dioderobot/arduino/README.md

# PCB boards

This repository contains schematics and boards built using the `pcb` command line utility by Diode, using the Zener language and open source compiler
