dioderobot/arduino/boards/Nano/docs/Nano.md

---
title: "Arduino Nano - Compact Development Board"
confidential: false
company:
  name: "Diode Inc"
  url: "https://diode.io"
client:
  name: "Arduino"
releases:
  - version: "1.0"
    date: "2025/10/21"
    description: "Initial Arduino Nano rebuild design"
---

# PCB Design Specification: Arduino Nano

# Description

The Arduino Nano is a compact microcontroller board based on the ATmega328P. It offers similar functionality to the Arduino Uno but in a smaller, breadboard-friendly form factor. The board is designed for embedded applications where space is at a premium while maintaining full Arduino ecosystem compatibility.

# Features

- ATmega328P microcontroller (16 MHz)
- 32 KB Flash memory (2 KB used by bootloader)
- 2 KB SRAM, 1 KB EEPROM
- 14 digital I/O pins (6 PWM outputs)
- 8 analog input pins
- USB connectivity via Mini-B or USB-C connector
- Breadboard-friendly DIP-30 pin layout
- Power via USB or external 7-12V supply
- Compact size: 18mm x 45mm

# Applications

- Embedded system prototyping
- IoT sensor nodes
- Robotics control systems
- Educational electronics projects
- Wearable electronics
- Home automation controllers

# Block Diagram

```mermaid
graph TB
    subgraph "Arduino Nano Board"
        subgraph "Power"
            USB["USB Power"]
            VIN["VIN (7-12V)"]
            REG["Voltage Regulator"]
            VCC["5V/3.3V Rails"]
            GND["Ground"]
        end
        
        subgraph "Communication"
            UART["USB-Serial (CH340/FTDI)"]
            I2C["I2C (A4/A5)"]
            SPI["SPI (D10-D13)"]
        end
        
        subgraph "Signal I/O"
            DIO["Digital I/O (D2-D13)"]
            AIN["Analog Input (A0-A7)"]
            PWM["PWM Output (D3,5,6,9,10,11)"]
        end
        
        subgraph "Processing"
            MCU["ATmega328P<br/>16 MHz"]
            XTAL["16MHz Crystal"]
        end
        
        USB --> UART
        VIN --> REG
        REG --> VCC
        USB --> VCC
        VCC --> MCU
        UART --> MCU
        XTAL --> MCU
        MCU --> DIO
        MCU --> PWM
        AIN --> MCU
        MCU --> I2C
        MCU --> SPI
    end
```
