dioderobot/arduino/components/74LVC1G3157DW-7/74LVC1G3157DW-7.md

## Description

The 74LVC1G3157 is a single-pole, double-throw analog switch. The device is designed for operation with a power supply range of 1.65 V to 5.5 V . The bidirectional switch can handle signal amplitudes between Vcc and Ground. The OFF state impedance of the switch is typically $50 \mathrm{M} \Omega$ while the ON state is typically $6 \Omega$.

## Pin Assignments



SOT363


Packages not to scale

# Features 

- Wide Supply Voltage Range from 1.65 to 5.5 V
- Control Pin Includes Hysteresis Allowing for Slower Input Rise and Fall Times
- CMOS Low Power Consumption
- Very Low ON-State Resistance
- $7.5 \Omega$ (typical) at $\mathrm{V}_{\mathrm{CC}}=2.7 \mathrm{~V}$
- $6.5 \Omega$ (typical) at $\mathrm{V}_{\mathrm{CC}}=3.3 \mathrm{~V}$
- $6 \Omega$ (typical) at $\mathrm{V}_{\mathrm{CC}}=4.5 \mathrm{~V}$
- Break Before Make Switching
- Control Input accepts up to 5.5V Regardless of Vcc.
- Direct Interface with TTL Levels when $\mathrm{V}_{\mathrm{CC}}=3.3 \mathrm{~V}$
- ESD Protection Tested per JESD 22
- Exceeds 2,000-V Human Body Model (A114)
- Exceeds 1,000-V Charged Device Model (C101)
- Latch-Up Exceeds 100mA per JESD 78, Class I
- Range of Package Options
- Totally Lead-Free \& Fully RoHS Compliant (Notes 1 \& 2)
- Halogen and Antimony Free. "Green" Device (Note 3)
- For automotive applications requiring specific change control (i.e. parts qualified to AEC-Q100/101/200, PPAP capable, and manufactured in IATF 16949 certified facilities), please contact us or your local Diodes representative.
https://www.diodes.com/quality/product-definitions/

## Applications

- Multiplexing of Analog Signals
- Multiplexing of Digital Signals
- Wide array of products such as:
- Tablets, E-readers, Wearables
- Cell Phones, Personal Navigation / GPS
- MP3 Players, Cameras, Video Recorders
- Computer Peripherals, Hard Drives, CD/DVD ROMs
- TV, DVD, DVR, Set Top Boxes
- PCs, Networking, Notebooks, Netbooks, PDAs

Notes: 1. No purposely added lead. Fully EU Directive 2002/95/EC (RoHS), 2011/65/EU (RoHS 2) \& 2015/863/EU (RoHS 3) compliant.
2. See https://www.diodes.com/quality/lead-free/ for more information about Diodes Incorporated's definitions of Halogen- and Antimony-free, "Green" and Lead-free.
3. Halogen- and Antimony-free "Green" products are defined as those which contain <900ppm bromine, <900ppm chlorine ( $<1500 \mathrm{ppm}$ total $\mathrm{Br}+\mathrm{Cl}$ ) and $<1000 \mathrm{ppm}$ antimony compounds.# Ordering Information (Note 4) 



| Device | Package <br> Code | Package <br> (Note 5) | Package <br> Size | $7^{\text {th }}$ Tape and Reel (Note 6) |  |
| :--: | :--: | :--: | :--: | :--: | :--: |
|  |  |  |  | Quantity | Part Number Suffix |
| 74LVC1G3157DW-7 | DW | SOT363 | $2.0 \mathrm{~mm} \times 2.0 \mathrm{~mm} \times 1.1 \mathrm{~mm}$ <br> 0.65 mm lead pitch | 3,000/Tape \& Reel | -7 |
| 74LVC1G3157FZ4-7 | FZ4 | X2-DFN1410-6 | $\begin{gathered} 1.4 \mathrm{~mm} \times 1.0 \mathrm{~mm} \times 0.4 \mathrm{~mm} \\ 0.5 \mathrm{~mm} \text { pad pitch } \end{gathered}$ | 5,000/Tape \& Reel | -7 |

Notes: 4. For packaging details, go to our website at https://www.diodes.com/design/support/packaging/diodes-packaging/.
5. Pad layout as shown in Diodes Incorporated's package outline PDFs, which can be found on our website at https://www.diodes.com/design/support/packaging/diodes-packaging/.
6. The taping orientation is located on our website at https://www.diodes.com/assets/Packaging-Support-Docs/ap02007.pdf.

## Pin Descriptions

| Pin Name | Description |
| :--: | :-- |
| B1 | Selectable Data I/0 |
| GND | Ground |
| B0 | Selectable Data I/0 |
| A | Common Data I/0 |
| $\mathrm{V}_{\mathrm{CC}}$ | Supply Voltage |
| Select | Selection Pin |

## Function Table

| Select | Status |
| :--: | :--: |
| H | B1 connected to A; <br> B0 high impedance |
| L | B0 connected to A; <br> B1 high impedance |

## Logic Diagram



## Simplified Schematic

# Absolute Maximum Ratings (Note 7) 

| Symbol | Description | Rating | Unit |
| :--: | :--: | :--: | :--: |
| ESD HBM | Human Body Model ESD Protection | 2 | kV |
| ESD CDM | Charged Device Model ESD Protection | 1 | kV |
| $\mathrm{V}_{\mathrm{CC}}$ | Supply Voltage Range | -0.5 to 6.5 | V |
| $\mathrm{V}_{\mathrm{IN}}$ | Input Voltage Range Applicable to Select Pin | -0.5 to 6.5 | V |
| $\mathrm{V}_{\text {SW }}$ | Voltage Range Applicable to B0, B1, and A Pins | -0.5 to $\mathrm{V}_{\mathrm{CC}}+0.5$ | V |
| $\mathrm{I}_{\text {IK }}$ | Input Clamp Current V,<0 Applicable to Select Pin | -50 | mA |
| $\mathrm{I}_{\text {IO }}$ | Continuous Current Applicable to B0,B1, and A Pins | $\pm 50$ | mA |
| $\mathrm{I}_{\mathrm{CC},} \mathrm{I}_{\text {GND }}$ | Continuous current through $\mathrm{V}_{\mathrm{CC}}$ or GND | $\pm 100$ | mA |
| $\mathrm{T}_{\mathrm{J}}$ | Operating Junction Temperature | -40 to +150 | ${ }^{\circ} \mathrm{C}$ |
| $\mathrm{T}_{\text {STG }}$ | Storage Temperature | -65 to +150 | ${ }^{\circ} \mathrm{C}$ |

Note: $\quad 7$. Stresses beyond the absolute maximum may result in immediate failure or reduced reliability. These are stress values and device operation should be within recommend values.

## Recommended Operating Conditions

| Symbol | Parameter |  | Min | Max | Unit |
| :--: | :--: | :--: | :--: | :--: | :--: |
| $\mathrm{V}_{\mathrm{CC}}$ | Operating Voltage | Operating | 1.65 | 5.5 | V |
| $\mathrm{V}_{\mathrm{IN}}$ | Select Input Voltage |  | 0 | 5.5 | V |
| $\mathrm{V}_{\text {SW }}$ | Switch Voltage (applicable to pins B0,B1,A) |  | $-0.2$ | $\mathrm{V}_{\mathrm{CC}}$ | V |
| $\Delta \mathrm{I} / \Delta \mathrm{V}$ | Input Transition Rise or Fall <br> Rate - Select Pin | $\mathrm{V}_{\mathrm{CC}}=1.65$ to 2.7 V | - | 20 | ns/V |
|  |  | $\mathrm{V}_{\mathrm{CC}}=2.7 \mathrm{~V}$ to 5.5 V | - | 10 |  |
| $T_{A}$ | Operating Free-Air Temperature | - | $-40$ | $+125$ | ${ }^{\circ} \mathrm{C}$ |# Electrical Characteristics (All typical values are at, $\mathrm{T}_{\mathrm{J}}=+25^{\circ} \mathrm{C}$ ) 

| Symbol | Parameter | Test Condition | $\mathrm{V}_{\mathrm{CC}}(\mathrm{V})$ | $\mathrm{T}_{\mathrm{A}}=-40$ to $+85^{\circ} \mathrm{C}$ |  |  | $\mathrm{T}_{\mathrm{A}}=-40$ to $+125^{\circ} \mathrm{C}$ |  | Unit |
| :--: | :--: | :--: | :--: | :--: | :--: | :--: | :--: | :--: | :--: |
|  |  |  |  | Min | Typical <br> (Note 8) | Max | Min | Max |  |
| $V_{I H}$ | High Level Input Voltage Select Pin | - | 1.65 to 1.95 | $0.65 \mathrm{~V}_{\mathrm{CC}}$ | - | - | $0.65 \mathrm{~V}_{\mathrm{CC}}$ | - | V |
|  |  |  | 2.3 to 2.7 | 1.7 | - | - | 1.7 | - |  |
|  |  |  | 3 to 3.6 | 2.0 | - | - | 2.0 | - |  |
|  |  |  | 4.5 to 5.5 | $0.7 \mathrm{~V}_{\mathrm{CC}}$ | - | - | $0.7 \mathrm{~V}_{\mathrm{CC}}$ | - |  |
| $V_{f L}$ | Low Level Input Voltage Select Pin | - | 1.65 to 1.95 | - | - | $0.35 \mathrm{~V}_{\mathrm{CC}}$ | - | $0.35 \mathrm{~V}_{\mathrm{CC}}$ | V |
|  |  |  | 2.3 to 2.7 | - | - | 0.7 | - | 0.7 |  |
|  |  |  | 3 to 3.6 | - | - | 0.8 | - | 0.8 |  |
|  |  |  | 4.5 to 5.5 | - | - | $0.3 \mathrm{~V}_{\mathrm{CC}}$ | - | $0.3 \mathrm{~V}_{\mathrm{CC}}$ |  |
| $I_{I N}$ | Input Leakage Current Select Pin | $0 \leq$ Select $\leq 5.5 \mathrm{~V}$ | 0 to 5.5 | - | $\pm 0.05$ | $\pm 1$ | - | $\pm 10$ | $\mu \mathrm{A}$ |
| $I_{S(\text { OFF })}$ | OFF State Leakage Current | $0 \mathrm{~V} \leq \mathrm{A}, \mathrm{B}_{\mathrm{n}} \leq \mathrm{V}_{\mathrm{CC}}$ <br> Figure 1 | 1.65 to 5.5 | - | $\pm 0.05$ | $\pm 1$ | - | $\pm 10$ | $\mu \mathrm{A}$ |
| $I_{S(C N)}$ | ON State Leakage Current | $0 \mathrm{~V} \leq \mathrm{A}, \mathrm{B}_{\mathrm{n}} \leq \mathrm{V}_{\mathrm{CC}}$ <br> Figure 2 | 1.65 to 5.5 | - | $\pm 0.05$ | $\pm 1$ | - | $\pm 10$ | $\mu \mathrm{A}$ |
| $I_{S(C N)}$ | ON State Leakage Current | $-0.1 \mathrm{~V} \leq \mathrm{A}, \mathrm{B}_{\mathrm{n}} \leq \mathrm{V}_{\mathrm{CC}}$ <br> Figure 2 | 1.65 to 5.5 | - | $\pm 0.05$ | $\pm 2$ | - | $\pm 20$ | $\mu \mathrm{A}$ |
| $I_{C C}$ | Quiescent Supply Current | Select $=\mathrm{V}_{\mathrm{CC}}$ or GND <br> A, Bn $=\mathrm{V}_{\mathrm{CC}}$ or GND <br> $\mathrm{I}_{\text {OUT }}=0$ | 5.5 | - | 1.0 | 10 | - | 40 | $\mu \mathrm{A}$ |
| $\Delta I_{C C}$ | Additional Supply Current | Select $=\mathrm{V}_{\mathrm{CC}}-0.6 \mathrm{~V}$ <br> A, Bn $=\mathrm{V}_{\mathrm{CC}}$ or GND <br> $\mathrm{I}_{\text {OUT }}=0$ | 5.5 | - | 30 | 500 | - | 5,000 | $\mu \mathrm{A}$ |
| $C_{I}$ | Input <br> Capacitance <br> Select Pin | - | 3.3 | - | 2.5 | - | - | - | pF |
| $\mathrm{C}_{\mathrm{S}(\text { OFF })}$ | OFF State Capacitance | Select $=\mathrm{V}_{\mathrm{CC}}$ or GND <br> A, Bn $=\mathrm{V}_{\mathrm{CC}}$ or GND <br> $\mathrm{I}_{\text {OUT }}=0$ | 3.3 | - | 6.0 | - | - | - | pF |
| $\mathrm{C}_{\mathrm{S}(\text { ON })}$ | ON State Capacitance | Select $=\mathrm{V}_{\mathrm{CC}}$ or GND <br> A, Bn $=\mathrm{V}_{\mathrm{CC}}$ or GND <br> $\mathrm{I}_{\text {OUT }}=0$ | 3.3 | - | 18 | - | - | - | pF |

Note: 8. Typical performance information is included in figures 11 to 34 on pages 11 to 14.# Electrical Characteristics (All typical values are at $\mathrm{T}_{J}=+25^{\circ} \mathrm{C}$ ) 

| Symbol | Parameter | Test Condition (Note 9) | $\mathrm{V}_{\mathrm{CC}}(\mathrm{V})$ | $T_{A}=-40$ to $+85^{\circ} \mathrm{C}$ |  |  | $T_{A}=-40$ to $+125^{\circ} \mathrm{C}$ |  | Unit |
| :--: | :--: | :--: | :--: | :--: | :--: | :--: | :--: | :--: | :--: |
|  |  |  |  | Min | Typ | Max | Min | Max |  |
| $R_{\text {ON }}$ | ON <br> Resistance | $\mathrm{V}_{\mathrm{I}}=0 \mathrm{~V}, \mathrm{I}_{\mathrm{O}}=4 \mathrm{~mA}$ | 1.65 | - | 12.5 | 18 | - | 27 | $\Omega$ |
|  |  | $\mathrm{V}_{\mathrm{I}}=1.65 \mathrm{~V}, \mathrm{I}_{\mathrm{O}}=-4 \mathrm{~mA}$ |  | - | 14 | 18 | - | 35 |  |
|  |  | $\mathrm{V}_{\mathrm{I}}=0 \mathrm{~V}, \mathrm{I}_{\mathrm{O}}=8 \mathrm{~mA}$ | 2.3 | - | 9.0 | 16 | - | 24 |  |
|  |  | $\mathrm{V}_{\mathrm{I}}=2.3 \mathrm{~V}, \mathrm{I}_{\mathrm{O}}=-8 \mathrm{~mA}$ |  | - | 9.0 | 16 | - | 30 |  |
|  |  | $\mathrm{V}_{\mathrm{I}}=0 \mathrm{~V}, \mathrm{I}_{\mathrm{O}}=12 \mathrm{~mA}$ | 2.7 | - | 8.0 | 14 | - | 21 |  |
|  |  | $\mathrm{V}_{\mathrm{I}}=2.7 \mathrm{~V}, \mathrm{I}_{\mathrm{O}}=-12 \mathrm{~mA}$ |  | - | 8.0 | 14 | - | 27 |  |
|  |  | $\mathrm{V}_{\mathrm{I}}=0 \mathrm{~V}, \mathrm{I}_{\mathrm{O}}=24 \mathrm{~mA}$ | 3.0 | - | 7.0 | 12 | - | 18 |  |
|  |  | $\mathrm{V}_{\mathrm{I}}=3.0 \mathrm{~V}, \mathrm{I}_{\mathrm{O}}=-24 \mathrm{~mA}$ |  | - | 7.0 | 12 | - | 23 |  |
|  |  | $\mathrm{V}_{\mathrm{I}}=0 \mathrm{~V}, \mathrm{I}_{\mathrm{O}}=32 \mathrm{~mA}$ | 4.5 | - | 5.5 | 10 | - | 15 |  |
|  |  | $\mathrm{V}_{\mathrm{I}}=2.7 \mathrm{~V}, \mathrm{I}_{\mathrm{O}}=-32 \mathrm{~mA}$ |  | - | 6.0 | 12 | - | 17 |  |
|  |  | $\mathrm{V}_{\mathrm{I}}=4.5 \mathrm{~V}, \mathrm{I}_{\mathrm{O}}=-32 \mathrm{~mA}$ |  | - | 5.5 | 10 | - | 15 |  |
| $R_{\text {RANGE }}$ | On Resistance Over Signal Range | $\mathrm{I}_{\mathrm{A}}=4 \mathrm{~mA}, 0 \leq \mathrm{V}_{\mathrm{BN}} \leq \mathrm{V}_{\mathrm{CC}}$ | 1.65 | - | 34 | 130 | - | 195 | $\Omega$ |
|  |  | $\mathrm{I}_{\mathrm{A}}=8 \mathrm{~mA}, 0 \leq \mathrm{V}_{\mathrm{BN}} \leq \mathrm{V}_{\mathrm{CC}}$ | 2.3 | - | 5 | 30 | - | 45 |  |
|  |  | $\mathrm{I}_{\mathrm{A}}=12 \mathrm{~mA}, 0 \leq \mathrm{V}_{\mathrm{BN}} \leq \mathrm{V}_{\mathrm{CC}}$ | 2.7 | - | 4 | 25 | - | 38 |  |
|  |  | $\mathrm{I}_{\mathrm{A}}=24 \mathrm{~mA}, 0 \leq \mathrm{V}_{\mathrm{BN}} \leq \mathrm{V}_{\mathrm{CC}}$ | 3.0 | - | 7.8 | 20 | - | 30 |  |
|  |  | $\mathrm{I}_{\mathrm{A}}=32 \mathrm{~mA}, 0 \leq \mathrm{V}_{\mathrm{BN}} \leq \mathrm{V}_{\mathrm{CC}}$ | 4.5 | - | 6.2 | 15 | - | 23 |  |
| $\Delta R_{\text {ON }}$ | On Resistance Match Between Channels (Note 10) | $\mathrm{I}_{\mathrm{A}}=-4 \mathrm{~mA}$, <br> $\mathrm{V}_{\mathrm{BN}}=1.15 \mathrm{~V}$ | 1.65 | - | 0.25 | - | - | - | $\Omega$ |
|  |  | $\mathrm{I}_{\mathrm{A}}=-8 \mathrm{~mA}$, <br> $\mathrm{V}_{\mathrm{BN}}=1.6 \mathrm{~V}$ | 2.3 | - | 0.25 | - | - | - |  |
|  |  | $\mathrm{I}_{\mathrm{A}}=-12 \mathrm{~mA}$, <br> $\mathrm{V}_{\mathrm{BN}}=1.9 \mathrm{~V}$ | 2.7 | - | 0.25 | - | - | - |  |
|  |  | $\mathrm{I}_{\mathrm{A}}=-24 \mathrm{~mA}$, <br> $\mathrm{V}_{\mathrm{BN}}=2.1$ | 3.0 | - | 0.25 | - | - | - |  |
|  |  | $\mathrm{I}_{\mathrm{A}}=-32 \mathrm{~mA}$, <br> $\mathrm{V}_{\mathrm{BN}}=3.15$ | 4.5 | - | 0.. 25 | - | - | - |  |
| $R_{\text {flat }}$ | On Resistance Flatness (Note 11) | $\mathrm{I}_{\mathrm{A}}=-4 \mathrm{~mA}, 0 \leq \mathrm{V}_{\mathrm{BN}} \leq \mathrm{V}_{\mathrm{CC}}$ | 1.65 | - | 26 | 110 | - | 150 | $\Omega$ |
|  |  | $\mathrm{I}_{\mathrm{A}}=-8 \mathrm{~mA}, 0 \leq \mathrm{V}_{\mathrm{BN}} \leq \mathrm{V}_{\mathrm{CC}}$ | 2.3 | - | 5.0 | 26 | - | 105 |  |
|  |  | $\mathrm{I}_{\mathrm{A}}=-24 \mathrm{~mA}, 0 \leq \mathrm{V}_{\mathrm{BN}} \leq \mathrm{V}_{\mathrm{CC}}$ | 2.7 | - | 3.5 | 16 | - | 35 |  |
|  |  | $\mathrm{I}_{\mathrm{A}}=-24 \mathrm{~mA}, 0 \leq \mathrm{V}_{\mathrm{BN}} \leq \mathrm{V}_{\mathrm{CC}}$ | 3.3 | - | 2.0 | 9 | - | 15 |  |
|  |  | $\mathrm{I}_{\mathrm{A}}=-32 \mathrm{~mA}, 0 \leq \mathrm{V}_{\mathrm{BN}} \leq \mathrm{V}_{\mathrm{CC}}$ | 5.0 | - | 1.5 | 4 | - | 8 |  |

Note: 9. Switch resistance test is measured per Figure 3.
10. $\Delta R_{\text {ON }}$ is measured at identical $\mathrm{V}_{\mathrm{CC}}$, temperature and voltage levels.
11. Flatness is defined as the difference between the maximum and minimum of ON resistance measured at identical $\mathrm{V}_{\mathrm{CC}}$ and temperature.# Switching Characteristics 

| Symbol | Parameter | Test Condition | $\begin{gathered} V_{C C} \\ \text { Volts } \end{gathered}$ | $\mathrm{T}_{\mathrm{A}}=-40 \text { to }+85^{\circ} \mathrm{C}$ |  |  | $\begin{gathered} \mathrm{T}_{\mathrm{A}}=-40 \text { to } \\ +125^{\circ} \mathrm{C} \end{gathered}$ |  | Unit | Figure Number |
| :--: | :--: | :--: | :--: | :--: | :--: | :--: | :--: | :--: | :--: | :--: |
|  |  |  |  | Min | Typ | Max | Min | Max |  |
| $t_{P H L}$ <br> $t_{P L H}$ | Propagation Delay A to $\mathrm{B}_{\mathrm{n}}$ | $\mathrm{V}_{\mathrm{I}}=$ OPEN <br> (Note 12) | 1.65 to 1.95 | - | - | 2.0 | - | 3.0 | ns | Figure 4 |
|  |  |  | 2.3 to 2.7 | - | - | 1.2 | - | 2.0 |  |  |
|  |  |  | 2.7 | - | - | 1.0 | - | 1.5 |  |  |
|  |  |  | 3.0 to 3.6 | - | - | 0.8 | - | 1.5 |  |  |
|  |  |  | 4.5 to 5.5 | - | - | 0.6 | - | 1.0 |  |  |
| $\begin{aligned} & t_{P Z L} \\ & t_{P Z H} \end{aligned}$ | Output <br> Enable Time Switch to $B_{n}$ | $\begin{aligned} & V_{I}=2 \times V_{C C} \text { for } t_{P Z L} \\ & V_{I}=0 \mathrm{~V} \text { for } t_{P Z H} \end{aligned}$ <br> (Note 13) | 1.65 to 1.95 | 1.0 | 8.7 | 14.0 | 1.0 | 14.0 | ns | Figure 4 |
|  |  |  | 2.3 to 2.7 | 1.0 | 5.3 | 7.5 | 1.0 | 7.5 |  |  |
|  |  |  | 2.7 | 1.0 | 4.9 | 6.0 | 1.0 | 6.0 |  |  |
|  |  |  | 3.0 to 3.6 | 0.5 | 4.0 | 5.5 | 0.5 | 5.5 |  |  |
|  |  |  | 4.5 to 5.5 | 0.5 | 3.0 | 4.0 | 0.5 | 4.0 |  |  |
| $\begin{aligned} & t_{P L Z} \\ & t_{P H Z} \end{aligned}$ | Output <br> Disable Time Switch to $B_{n}$ | $\begin{aligned} & V_{I}=2 \times V_{C C} \text { for } t_{P L Z} \\ & V_{I}=0 \mathrm{~V} \text { for } t_{P H Z} \end{aligned}$ <br> (Note 13) | 1.65 to 1.95 | 2.5 | 6.0 | 8.5 | 2.5 | 8.5 | ns | Figure 4 |
|  |  |  | 2.3 to 2.7 | 2.0 | 4.4 | 8.2 | 2.0 | 8.2 |  |  |
|  |  |  | 2.7 | 1.5 | 4.2 | 8.0 | 1.5 | 8.0 |  |  |
|  |  |  | 3.0 to 3.6 | 1.5 | 3.6 | 7.8 | 1.5 | 7.8 |  |  |
|  |  |  | 4.5 to 5.5 | 0.8 | 2.9 | 7.5 | 0.8 | 7.5 |  |  |
| $t_{B-M}$ | Break Before Make Time (Note 9) | - | 1.65 to 1.95 | 0.5 | - |  | 0.5 | - | ns | Figure 5 |
|  |  |  | 2.3 to 2.7 | 0.5 | - | - | 0.5 | - |  |  |
|  |  |  | 2.7 | 0.5 | - | - | 0.5 | - |  |  |
|  |  |  | 3.0 to 3.6 | 0.5 |  | - | 0.5 | - |  |  |
|  |  |  | 4.5 to 5.5 | 0.5 | - | - | 0.5 |  |  |  |
| Q | Charge Injection (Note 9) | $\begin{aligned} & C_{L}=0.1 \mathrm{nF}, \\ & V_{0 E N}=0 \mathrm{~V} \\ & R_{0 E N}=0 \Omega \end{aligned}$ | 5.0 | - | 7.0 | - | - | - | pC | Figure 6 |
|  |  |  | 3.3 |  | 3.0 | - | - | - |  |  |
| QIRR | Off Isolation (Note 11) | $\begin{aligned} & R_{L}=50 \Omega, \\ & f=10 \mathrm{MHz} \end{aligned}$ | $1.65 \sim 5.5$ | - | $-42$ | - | - | - | dB | Figure 7 |
| Xtalk | Crosstalk | $R_{L}=50 \Omega, f=10 \mathrm{MHz}$ | $1.65 \sim 5.5$ | - | $-42$ | - | - | - | dB | Figure 8 |
| BW | -3dB <br> Bandwidth | $R_{L}=50 \Omega$ | $1.65 \sim 5.5$ | - | 300 | - | - | - | MHz | Figure 9 |
| THD | Total <br> Harmonic <br> Distortion <br> (Note 9) | $\begin{aligned} & R_{L}=600 \Omega, 0.5 \mathrm{~V}_{\mathrm{P}, \mathrm{P}}, \\ & f=600 \mathrm{~Hz} \text { to } 20 \mathrm{kHz} \end{aligned}$ | 5.0 | - | 0.1 | - | - | - | \% | Figure 10 |

Notes: 12. Due to the symmetry of the part, the direction of the propagation delay applies to either direction $A$ to $B_{n}$ or $B_{n}$ to $A$. Propagation time is the calculated RC time constant of the typical ON resistance of the switch and the specified load capacitance when capacitance when driven by an ideal voltage source.
13. The Switch signal enable and disables time are the same for Bn and A if they are reversed at input and output.# Parameter Measurement Information 



Condition 1: $\quad \mathrm{V}_{\mathrm{I}}=\mathrm{GND}, \mathrm{V}_{\mathrm{O}}=\mathrm{V}_{\mathrm{CC}}$
Condition 2: $\quad \mathrm{V}_{\mathrm{I}}=\mathrm{V}_{\mathrm{CC}}, \mathrm{V}_{\mathrm{O}}=\mathrm{GND}$

Figure 1 OFF -State Leakage Curent Test


Figure 2 ON -State Leakage Curent Test


Figure 3 ON State Resistance Test# Parameter Measurement Information (Notes 15-19) 



Figure 4 Load Circuit and Voltage Waveforms

Notes: 14. Includes test lead and test apparatus capacitance.
15. All pulses are supplied at pulse repetition rate $\leq 10 \mathrm{MHz}$.
16. Inputs are measured separately one transition per measurement.
17. $t_{\mathrm{PL} 2}$ and $t_{\mathrm{PH} 2}$ are the same as $t_{\mathrm{dx}}$.
18. $t_{\mathrm{VCL}}$ and $t_{\mathrm{FOV}}$ are the same as $t_{\mathrm{IO}}$.
19. $t_{\mathrm{PLH}}$ and $t_{\mathrm{PH} 4}$ are the same as $t_{\mathrm{IO}}$.# Parameter Measurement Information 



Figure 5 Break before Make Timing Test


Figure 6 Charge Injection


Figure 7 OFF Isolation# Parameter Measurement Information 



Figure 8 Cross Talk


Adjust fin voltage to obtain 0 dBm level at input.
Adjust fin frequency until dB meter reads -3 dB .
Figure 9 Bandwdith


Figure 10 THD

Figure 11 ON state Resistance $\mathrm{Vcc}=1.65 \mathrm{~V} ; \mathrm{I}_{0 \mathrm{n}}=4 \mathrm{ma}$


Figure 13 ON state Resistance $\mathrm{Vcc}=2.3 \mathrm{~V} ; \mathrm{I}_{0 \mathrm{n}}=8 \mathrm{ma}$


Figure 15 ON state Resistance $\mathrm{Vcc}=2.7 \mathrm{~V} ; \mathrm{I}_{0 \mathrm{n}}=12 \mathrm{ma}$


Figure 12 ON state Resistance $\mathrm{Vcc}=1.8 \mathrm{~V} ; \mathrm{I}_{0 \mathrm{n}}=4 \mathrm{ma}$


Figure 14 ON state Resistance $\mathrm{Vcc}=2.5 \mathrm{~V} ; \mathrm{I}_{0 \mathrm{n}}=8 \mathrm{ma}$


Figure 16 ON state Resistance $\mathrm{Vcc}=3 \mathrm{~V} ; \mathrm{I}_{0 \mathrm{n}}=24 \mathrm{ma}$Typical Performance Characteristics (continued)


Figure 17 ON state Resistance $\mathrm{Vcc}=3.3 \mathrm{~V} ; \mathrm{I}_{\mathrm{Bn}}=24 \mathrm{ma}$


Figure 19 ON state Resistance $\mathrm{Vcc}=5.5 \mathrm{~V} ; \mathrm{I}_{\mathrm{Bn}}=32 \mathrm{ma}$


Figure $21 \mathrm{I}_{\mathrm{S}(\mathrm{OFF})}$ OFF state leakage $\mathrm{V}_{\mathrm{IN}}=0 \mathrm{~V}$


Figure 18 ON state Resistance $\mathrm{Vcc}=4.5 \mathrm{~V} ; \mathrm{I}_{\mathrm{Bn}}=32 \mathrm{ma}$


Figure 20 $\triangle$ Ron-Resistance Match Between Channels


Figure $22 \mathrm{I}_{\mathrm{S}(\mathrm{OFF})}$ OFF state leakage $\mathrm{V}_{\mathrm{IN}}=-0.1 \mathrm{~V}$Typical Performance Characteristics (continued)


Figure $23 \mathrm{I}_{\mathrm{S}(\mathrm{OFF})}$ OFF state leakage $\mathrm{V}_{\mathrm{IN}}=-0.2 \mathrm{~V}$


Figure $25 \mathrm{I}_{\mathrm{S}(\mathrm{ON})}$ ON state leakage $\mathrm{V}_{\mathrm{m}}=-0.1 \mathrm{~V}$


Figure $27 \mathrm{I}_{\mathrm{CC}}$ verses Temperture


Figure $24 \mathrm{I}_{\mathrm{S}(\mathrm{ON})}$ ON state leakage $\mathrm{V}_{\mathrm{IN}}=0 \mathrm{~V}$


Figure $26 \mathrm{I}_{\mathrm{S}(\mathrm{ON})}$ ON state leakage $\mathrm{V}_{\mathrm{m}}=-0.2 \mathrm{~V}$


Figure 28 Delta $\mathrm{I}_{\mathrm{CC}}$ verses Temperture# Typical Performance Characteristics (continued) 



Figure $29 \mathrm{~V}_{\mathrm{H}}, \mathrm{V}_{\mathrm{E}}, \mathrm{Hysteresis} \mathrm{V}_{\mathrm{CC}}=1.65 \mathrm{~V}$ and $\mathrm{V}_{\mathrm{CC}}=1.95 \mathrm{~V}$


Figure $31 \mathrm{~V}_{\mathrm{H}}, \mathrm{V}_{\mathrm{E}}, \mathrm{Hysteresis} \mathrm{V}_{\mathrm{CC}}=3 \mathrm{~V}$ and $\mathrm{V}_{\mathrm{CC}}=3.3 \mathrm{~V}$


Figure $30 \mathrm{~V}_{\mathrm{H}}, \mathrm{V}_{\mathrm{E}}, \mathrm{Hysteresis} \mathrm{V}_{\mathrm{CC}}=2.3 \mathrm{~V}$ and $\mathrm{V}_{\mathrm{CC}}=2.7 \mathrm{~V}$


Figure $32 \mathrm{~V}_{\mathrm{H}}, \mathrm{V}_{\mathrm{E}}, \mathrm{Hysteresis} \mathrm{V}_{\mathrm{CC}}=4.5 \mathrm{~V}$ and $\mathrm{V}_{\mathrm{CC}}=5.5 \mathrm{~V}$# Marking Information 

(1) SOT363

(2) X2-DFN1410-6


| Part Number | Package | Identification Code |
| :--: | :--: | :--: |
| 74LVC1G3157FZ4 | X2-DFN1410-6 | J7 |

Package Characteristics (All typical values are at $\mathrm{V}_{\mathrm{CC}}=3.3 \mathrm{~V}, \mathrm{~T}_{\mathrm{A}}=+25^{\circ} \mathrm{C}$ )

| Symbol | Parameter | Test Conditions | $\mathrm{V}_{\mathrm{CC}}$ | Min | Typ. | Max | Unit |
| :--: | :--: | :--: | :--: | :--: | :--: | :--: | :--: |
| $\theta_{\text {JA }}$ | Thermal Resistance Junction-to-Ambient | SOT363 | (Note 20) | - | 371 | - | ${ }^{\circ} \mathrm{C} / \mathrm{W}$ |
|  |  | X2-DFN1410-6 |  | - | 460 | - |  |
| $\theta_{\text {JC }}$ | Thermal Resistance Junction-to-Case | SOT363 | (Note 20) | - | 143 | - | ${ }^{\circ} \mathrm{C} / \mathrm{W}$ |
|  |  | X2-DFN1410-6 |  | - | 265 | - |  |

Note: 20. Test condition SOT363, and X2-DFN1410-6: Device mounted on FR-4 substrate PC board, 2oz. copper, with minimum recommended pad layout.# SOT363 Package Outline Dimensions and Suggested Pad Layout 

Please see http://www.diodes.com/package-outlines.html for the latest version.


| SOT363 |  |  |  |
| :--: | :--: | :--: | :--: |
| Dim | Min | Max | Typ |
| A1 | 0.00 | 0.10 | 0.05 |
| A2 | 0.90 | 1.00 | 1.00 |
| b | 0.10 | 0.30 | 0.25 |
| c | 0.10 | 0.22 | 0.11 |
| D | 1.80 | 2.20 | 2.15 |
| E | 2.00 | 2.20 | 2.10 |
| E1 | 1.15 | 1.35 | 1.30 |
| e | 0.650 BSC |  |  |
| F | 0.40 | 0.45 | 0.425 |
| L | 0.25 | 0.40 | 0.30 |
| a | $0^{\prime \prime}$ | $8^{\prime \prime}$ | - |
| All Dimensions in mm |  |  |  |



| Dimensions | Value <br> (in mm) |
| :--: | :--: |
| C | 0.650 |
| G | 1.300 |
| X | 0.420 |
| Y | 0.600 |
| Y1 | 2.500 |# X2-DFN1410-6 Package Outline Dimensions and Suggested Pad Layout 

Please see http://www.diodes.com/package-outlines.html for the latest version.


| X2-DFN1410-6 |  |  |  |
| :--: | :--: | :--: | :--: |
| Dim | Min | Max | Typ |
| A | - | 0.40 | 0.39 |
| A1 | 0.00 | 0.05 | 0.02 |
| A3 | - | - | 0.13 |
| b | 0.15 | 0.25 | 0.20 |
| D | 1.35 | 1.45 | 1.40 |
| E | 0.95 | 1.05 | 1.00 |
| e | - | - | 0.50 |
| L | 0.25 | 0.35 | 0.30 |
| Z | - | - | 0.10 |
| Z1 | 0.045 | 0.105 | 0.075 |
| All Dimensions in mm |  |  |  |



| Dimensions | Value <br> (in mm) |
| :--: | :--: |
| C | 0.500 |
| G | 0.250 |
| X | 0.250 |
| X1 | 1.250 |
| Y | 0.525 |
| Y1 | 1.250 |

## Mechanical Data

## SOT363

- Moisture Sensitivity: Level 1 per J-STD-020
- Terminals: Finish - Mate Tin Plated Leads, Solderable per MIL-STD-202, Method 208 (1)
- Weight: 0.0064 grams (Approximate)

## X2-DFN1410-6

- Moisture Sensitivity: Level 1 per J-STD-020
- Terminals: Finish - NiPdAu Nickel Palladium Gold, Solderable per MIL-STD-202, Method 208 (1)
- Weight: 0.002 grams (Approximate)# IMPORTANT NOTICE 

1. DIODES INCORPORATED AND ITS SUBSIDIARIES ("DIODES") MAKE NO WARRANTY OF ANY KIND, EXPRESS OR IMPLIED, WITH REGARDS TO ANY INFORMATION CONTAINED IN THIS DOCUMENT, INCLUDING, BUT NOT LIMITED TO, THE IMPLIED WARRANTIES OF MERCHANTABILITY, FITNESS FOR A PARTICULAR PURPOSE OR NON-INFRINGEMENT OF THIRD PARTY INTELLECTUAL PROPERTY RIGHTS (AND THEIR EQUIVALENTS UNDER THE LAWS OF ANY JURISDICTION).
2. The Information contained herein is for informational purpose only and is provided only to illustrate the operation of Diodes products described herein and application examples. Diodes does not assume any liability arising out of the application or use of this document or any product described herein. This document is intended for skilled and technically trained engineering customers and users who design with Diodes products. Diodes products may be used to facilitate safety-related applications; however, in all instances customers and users are responsible for (a) selecting the appropriate Diodes products for their applications, (b) evaluating the suitability of the Diodes products for their intended applications, (c) ensuring their applications, which incorporate Diodes products, comply the applicable legal and regulatory requirements as well as safety and functional-safety related standards, and (d) ensuring they design with appropriate safeguards (including testing, validation, quality control techniques, redundancy, malfunction prevention, and appropriate treatment for aging degradation) to minimize the risks associated with their applications.
3. Diodes assumes no liability for any application-related information, support, assistance or feedback that may be provided by Diodes from time to time. Any customer or user of this document or products described herein will assume all risks and liabilities associated with such use, and will hold Diodes and all companies whose products are represented herein or on Diodes' websites, harmless against all damages and liabilities.
4. Products described herein may be covered by one or more United States, international or foreign patents and pending patent applications. Product names and markings noted herein may also be covered by one or more United States, international or foreign trademarks and trademark applications. Diodes does not convey any license under any of its intellectual property rights or the rights of any third parties (including third parties whose products and services may be described in this document or on Diodes' website) under this document.
5. Diodes products are provided subject to Diodes' Standard Terms and Conditions of Sale (https://www.diodes.com/about/company/terms-and-conditions/terms-and-conditions-of-sales/) or other applicable terms. This document does not alter or expand the applicable warranties provided by Diodes. Diodes does not warrant or accept any liability whatsoever in respect of any products purchased through unauthorized sales channel.
6. Diodes products and technology may not be used for or incorporated into any products or systems whose manufacture, use or sale is prohibited under any applicable laws and regulations. Should customers or users use Diodes products in contravention of any applicable laws or regulations, or for any unintended or unauthorized application, customers and users will (a) be solely responsible for any damages, losses or penalties arising in connection therewith or as a result thereof, and (b) indemnify and hold Diodes and its representatives and agents harmless against any and all claims, damages, expenses, and attorney fees arising out of, directly or indirectly, any claim relating to any noncompliance with the applicable laws and regulations, as well as any unintended or unauthorized application.
7. While efforts have been made to ensure the information contained in this document is accurate, complete and current, it may contain technical inaccuracies, omissions and typographical errors. Diodes does not warrant that information contained in this document is error-free and Diodes is under no obligation to update or otherwise correct this information. Notwithstanding the foregoing, Diodes reserves the right to make modifications, enhancements, improvements, corrections or other changes without further notice to this document and any product described herein. This document is written in English but may be translated into multiple languages for reference. Only the English version of this document is the final and determinative format released by Diodes.
8. Any unauthorized copying, modification, distribution, transmission, display or other use of this document (or any portion hereof) is prohibited. Diodes assumes no responsibility for any losses incurred by the customers or users or any third parties arising from any such unauthorized use.

Copyright © 2021 Diodes Incorporated
www.diodes.com
