dioderobot/arduino/components/B3U-1000P/B3U-1000P.md

# Ultra-small Tactile Switch (SMT) B3U 

## Ultra-small Surface-mounting Tactile Switches with High Contact Reliability $(1.2 \times 3 \times 2.5 \mathrm{~mm}(H \times W \times D)$

- Smallest class in the industry for high-density mounting of compact devices.
- Surface mounted: Ideal for high-density mounting.
- Models with ground terminals are available for protection against static electricity.
- Available on embossed tape: Ideal for automatic mounting.


## RoHS Compliant

## List of Models

| Operation type | Contact material | Height | Operating <br> force (SF) | Plunger color | Locating pin | Embossed taping (standard quantity) |  |  | Embossed taping (small quantity) |  |  |
| :--: | :--: | :--: | :--: | :--: | :--: | :--: | :--: | :--: | :--: | :--: | :--: |
|  |  |  |  |  |  | Without ground terminal | With ground terminal | Minimum packing unit | Without ground terminal | With ground terminal | Minimum packing unit |
| B3U-1000 Series: Topactuated | Silver <br> plated | 1.6 mm | $\begin{aligned} & 1.5 \mathrm{~N} \\ & \text { (153 gf) } \end{aligned}$ | Black | Without boss | B3U-1000P | B3U-1100P | 3,500 | B3U-1000PM | B3U-1100PM | 1,000 |
|  |  |  |  |  | With boss | B3U-1000P-B | B3U-1100P-B |  | B3U-1000PM-B | B3U-1100PM-B |  |
| B3U-3000 Series: <br> Sideactuated |  | 3.2 mm | $\begin{aligned} & 1,59 \mathrm{~N} \\ & (162 \mathrm{gf}) \end{aligned}$ |  | Without boss | B3U-3000P | B3U-3100P | 4,000 | B3U-3000PM | B3U-3100PM | 1,000 |
|  |  |  |  |  | With boss | B3U-3000P-B | B3U-3100P-B |  | B3U-3000PM-B | B3U-3100PM-B |  |

Note: Orders must be made in multiples of the order unit specified above.

## Ratings/Characteristics

|  | Operation <br> type | Top-actuated <br> (B3U-1000 Series) | Side-actuated <br> (B3U-3000 Series) |
| :-- | :-- | :-- | :-- |
| Rating <br> (resistive load) | 1 to 50 mA , 3 to 12 VDC |  |  |
| Minimum applicable <br> load (reference value) | $10 \mu \mathrm{~A}$ at 1 VDC (resistive load) |  |  |
| Ambient operating <br> temperature | $-25^{\circ} \mathrm{C}$ to $+70^{\circ} \mathrm{C}$ at $60 \% \mathrm{RH}$ max. (with no icing or <br> condensation) |  |  |
| Ambient operating <br> humidity | $35 \%$ to $85 \%$ (at +5 to $+35^{\circ} \mathrm{C}$ ) |  |  |
| Contact form | SPST-NO |  |  |
| Contact resistance <br> (initial value) | $100 \mathrm{~m} \Omega$ max. |  |  |
| Insulation resistance | $100 \mathrm{M} \Omega$ min. (at 100 VDC with insulation tester) |  |  |
| Dielectric strength | 250 VAC, 50/60 Hz for 1 min |  |  |
| Bounce time | 5 ms max. |  |  |
| Vibration resistance | 10 to $55 \mathrm{~Hz}, 1.5 \mathrm{~mm}$ double amplitude |  |  |
| Shock resistance | $1,000 \mathrm{~m} / \mathrm{s}^{2}$ max. |  |  |
| Durability | 200,000 operations <br> min. | 100,000 operations <br> min. |  |
| Weight | Approx. 0.022 g |  |  |
| Degree of protection | IEC IP40 |  |  |
| Washing | Not possible |  |  |

## Operating Characteristics

| Operation type <br> Item | Top-actuated <br> (B3U-1000 Series) | Side-actuated <br> (B3U-3000 Series) |
| :-- | :-- | :-- |
| Operating force (OF) | $1.50 \pm 0.49 \mathrm{~N}$ <br> $(153 \pm 50 \mathrm{gf})$ | $1.59 \pm 0.49 \mathrm{~N}$ <br> $(162 \pm 50 \mathrm{gf})$ |
| Releasing force (RF) | 0.2 N min. (20 gf) |  |
| Pretravel (PT) | $0.15 \frac{\pi}{51} \mathrm{~mm}$ | $0.2 \frac{\pi}{51} \mathrm{~mm}$ |- Dimensions (Unit: mm)

Top-actuated Models


Note: Unless otherwise specified, a tolerance of $\pm 0.2 \mathrm{~mm}$ applies to all dimensions. No terminal numbers are indicated on the Switches.Side-actuated Models


Note: Unless otherwise specified, a tolerance of $\pm 0.2 \mathrm{~mm}$ applies to all dimensions. No terminal numbers are indicated on the Switches.

# - Precautions 

Be sure to read the precautions common to all Tactile Switches on pages for correct use.Please check each region's Terms \& Conditions by region website.

# OMRON Corporation 

Electronic and Mechanical Components Company

## Regional Contact

## Americas

https://www.components.omron.com/
Asia-Pacific
https://ecb.omron.com.sg/
Korea
https://www.omron-ecb.co.kr/

Europe
http://components.omron.eu/
China
https://www.ecb.omron.com.cn/
Japan
https://www.omron.co.jp/ecb/
