dioderobot/arduino/components/CLE-130-01-G-DV-P-TR/CLE-130-01-G-DV-P-TR.md

# REVISION BB

## DO NOT SCALE FROM THIS PRINT

- No of Positions: 04 THRU -90 (PER ROW)
- Lead Style: 01 (USE C-80-01-X)
- Plating Specification: -F: 3µ" FLASH SELECTIVE GOLD ON ENTIRE CONTACT -G: 10µ" LIGHT GOLD ON ENTIRE CONTACT

## NOTES:

1. ☑ REPRESENTS A CRITICAL DIMENSION.
2. NOTE DELETED.
3. MINIMUM PUSHOUT FORCE: .5 LB.
4. WILL LOSE TWO POSITIONS FOR EVERY CUT MADE. MAXIMUM CUT FLASH TO BE .010 [0.25] WITH NO FLASH IN HOLES OR EXTENDING BELOW LEADS.
5. NOTE DELETED.
6. MAXIMUM BURR ALLOWANCE: .003 [0.08].
7. ENDWALL AFTER CUTTING: .0115±.0025 [0.292±0.064].
8. VOIDS ON TOP SURFACE TO BE LOCATED AT VENDOR DISCRETION TO CONTROL PART WARPAGE.
9. -TR OPTION ORDERS INVOLVING PARTIAL REEL QUANTITIES MAY BE PACKAGED ACCORDING TO THE SAMTEC PACKAGING EFFICIENCY STANDARDS (SPES) FOUND ON WWW.SAMTEC.COM.
10. -FR OPTIONS WILL BE SHIPPED AT THE MAX QUANTITY PER REEL, BASED ON OPTIONS SELECTED.

## CLE-1XX-XX-X-DV-XX

|  **OPTION** | **P: PICK & PLACE PAD (SEE FIG 2, 5HT 2)**  |
| --- | --- |
|  (AVAILABLE ON POSITIONS -08 THRU -90 ONLY) | (USE LMP-10)  |
|  (USE LMP-10) | -TR: TAPE & REEL PACKAGING (SEE NOTE 9)  |
|  -A: ALIGNMENT PIN (SEE FIG 3 & 4, 5HT 2) | (MOLDED TO POSITION OR STAKED)  |
|  (SAMEC DISCRETION WHICH -A PIN IS USED) | (SAMEC DISCRETION WHICH -A PIN IS USED)  |
|  (STAKE 7 POSITIONS MIN) | (STAKE 7 POSITIONS MIN)  |
|  -K: POLYIMIDE FILM PAD | (AVAILABLE ON POS. 8 THRU 90 ONLY)  |
|  (AVAILABLE ON POS. 8 THRU 90 ONLY) | (SEE FIG 5, 5HT 2)  |
|  (USE K-DOT-.157-.250-.005) | (USE K-DOT-.157-.250-.005)  |

## ROW SPECIFICATION

- D: DOUBLE ROW - VERTICAL (USE CLE-90-D)

END WALLS TO BE SYMMETRICAL 1.0050

- SEE NOTE 6
- 004[.10] POS. 04-65
- 006[.15] POS. 66-90

## SECTION "A"-"A"

UNLESS OTHERWISE SPECIFIED. DIMENSIONS ARE IN INCHES.

|  **TELEFANCES ARE:** | **ANGLES**  |
| --- | --- |
|  **DECIMAL:** | **X**  |
|  **XXX:** | **1.0050 [.13]**  |
|  **XXX:** | **1.0020 [.051]**  |
|  **MATERIAL:** | **DO NOT SCALE DRAWING**  |
|  **INSULATOR:** | **LCP, UL 94 VO, COLOR: BLACK**  |
|  **CONTACT:** | BeCu 190 ALLOY (TM04)  |
|  **THICKNESS:** | **007 [0.18] REF**  |

|  **PROPRIETARY HOTS** | **PREPARED BY:**  |
| --- | --- |
|  **THIS DOCUMENT CONTAINS CONFIDENTIAL AND** | **AND SHUTS RIGHTS AND EXPRESSLY REVERSED BY SAMPLE**  |
|  **AND SHUTS RIGHTS AND EXPRESSLY REVERSED BY SAMPLE** | **DET. THIS DOCUMENT SHALL NOT BE DISCLOSED, IN OR IN**  |
|  **DET. THIS DOCUMENT SHALL NOT BE DISCLOSED, IN OR IN** | **DET. THIS DOCUMENT SHALL NOT BE DISCLOSED, IN OR IN**  |
|  **DRAWING OF SHEET:** | **DRAWING OF SHEET**  |
|  **DRAWING OF SHEET:** | **DRAWING OF SHEET**  |
|  **DRAWING OF SHEET:** | **DRAWING OF SHEET**  |
|  **DRAWING OF SHEET:** | **DRAWING OF SHEET**  |
|  **DRAWING OF SHEET:** | **DRAWING OF SHEET**  |
|  **DRAWING OF SHEET:** | **DRAWING OF SHEET**  |
|  **DRAWING OF SHEET:** | **DRAWING OF SHEET**  |
|  **DRAWING OF SHEET:** | **DRAWING OF SHEET**  |
|  **DRAWING OF SHEET:** | **DRAWING OF SHEET**  |
|  **DRAWING OF SHEET:** | **DRAWING OF SHEET**  |
|  **DRAWING OF SHEET:** | **DRAWING OF SHEET**  |
|  **DRAWING OF SHEET:** | **DRAWING OF SHEET**  |
|  **DRAWING OF SHEET:** | **DRAWING OF SHEET**  |
|  **DRAWING OF SHEET:** | **DRAWING OF SHEET**  |
|  **DRAWING OF SHEET:** | **DRAWING OF SHEET**  |
|  **DRAWING OF SHEET:** | **DRAWING OF SHEET**  |
|  **DRAWING OF SHEET:** | **DRAWING OF SHEET**  |
|  **DRAWING OF SHEET:** | **DRAWING OF SHEET**  |
|  **DRAWING OF SHEET:** | **DRAWING OF SHEET**  |
|  **DRAWING OF SHEET:** | **DRAWING OF SHEET**  |
|  **DRAWING OF SHEET:** | **DRAWING OF SHEET**  |
|  **DRAWING OF SHEET:** | **DRAWING OF SHEET**  |
|  **DRAWING OF SHEET:** | **DRAWING OF SHEET**  |
|  **DRAWING OF SHEET:** | **DRAWING OF SHEET**  |
|  **DRAWING OF SHEET:** | **DRAWING OF SHEET**  |
|  **DRAWING OF SHEET:** | **DRAWING OF SHEET**  |
|  **DRAWING OF SHEET:** | **DRAWING OF SHEET**  |
|  **DRAWING OF SHEET:** | **DRAWING OF SHEET**  |
|  **DRAWING OF SHEET:** | **DRAWING OF SHEET**  |
|  **DRAWING OF SHEET:** | **DRAWING OF SHEET**  |
|  **DRAWING OF SHEET:** | **DRAWING OF SHEET**  |


# REVISION BB

## FIG. 2
### -P OPTION 8 POSITIONS MIN

- **P = [(M - 225) / 2] ± 0.15 [0.38]**
- **LMP - 10**
- **225 [5.72] REF**
- **M**

## FIG. 3
### -A STAKED OPTION 7 POSITIONS MIN

- **P = [(M - 225) / 2] ± 0.15 [0.38]**
- **LMP - 10**
- **225 [5.72] REF**
- **M**

## FIG. 4
### -A OPTION (MOLDED) 4 POSITIONS MIN

- **P = [(M - 225) / 2] ± 0.15 [0.800]**
- **5**
- **1570 ± 0.050 [3.988 ± 0.127]**
- **135 [3.43]**

**NOTE:** "R" = USED MEASURED DIMENSION (REF), "S" = [(R - 1575 [4.00]) / 2] ± 0.20 [0.51]

## FIG. 5
### -K: POLYIMIDE FILM PAD 8 POSITIONS MIN

- **K = [(M - 225) / 2] ± 0.15 [0.800]**
- **5**
- **1570 ± 0.050 [3.988 ± 0.127]**
- **135 [3.43]**

**NOTE:** "R" = USED MEASURED DIMENSION (REF), "S" = [(R - 1575 [4.00]) / 2] ± 0.20 [0.51]

## FIG. 6
### -A ALIGNMENT PIN OPTION
- **M = A7H FOR STAKED VERSION**
- **SM - A7H FOR STAKED VERSION**
- **5**
- **1570 ± 0.050 [3.988 ± 0.127]**
- **135 [3.43]**

## FIG. 7
### -A STAKED OPTION 7 POSITIONS MIN

- **P = [(M - 225) / 2] ± 0.15 [0.800]**
- **5**
- **1570 ± 0.050 [3.988 ± 0.127]**
- **135 [3.43]**

## FIG. 8
### -A STAKED OPTION 7 POSITIONS MIN

- **P = [(M - 225) / 2] ± 0.15 [0.800]**
- **5**
- **1570 ± 0.050 [3.988 ± 0.127]**
- **135 [3.43]**

## FIG. 9
### -B OPTION (MOLDED) 4 POSITIONS MIN

- **B = [(M - 225) / 2] ± 0.15 [0.800]**
- **5**
- **1570 ± 0.050 [3.988 ± 0.127]**
- **135 [3.43]**

**NOTE:** "R" = USED MEASURED DIMENSION (REF), "S" = [(R - 1575 [4.00]) / 2] ± 0.20 [0.51]

## FIG. 10
### -C OPTION (MOLDED) 4 POSITIONS MIN

- **C = [(M - 225) / 2] ± 0.15 [0.800]**
- **5**
- **1570 ± 0.050 [3.988 ± 0.127]**
- **135 [3.43]**

**NOTE:** "R" = USED MEASURED DIMENSION (REF), "S" = [(R - 1575 [4.00]) / 2] ± 0.20 [0.51]
