dioderobot/arduino/components/MMBT3904W_SOT323_3P/SMMBT3904WT1G.md

## General Purpose Transistors NPN and PNP Silicon

## MMBT3904WT1G, NPN, SMMBT3904WT1G, NPN, MMBT3906WT1G, PNP, SMMBT3906WT1G, PNP

These transistors are designed for general purpose amplifier applications. They are housed in the SOT-323/SC-70 package which is designed for low power surface mount applications.

## Features

- S Prefix for Automotive and Other Applications Requiring Unique Site and Control Change Requirements; AEC-Q101 Qualified and PPAP Capable
- These Devices are $\mathrm{Pb}-\mathrm{Free}$, Halogen Free/BFR Free and are RoHS Compliant

## MAXIMUM RATINGS

| Rating | Symbol | Value | Unit |
| :--: | :--: | :--: | :--: |
| Collector-Emitter Voltage <br> MMBT3904WT1, SMMBT3904WT1 <br> MMBT3906WT1, SMMBT3906WT1 | $\mathrm{V}_{\text {CEO }}$ | $\begin{gathered} 40 \\ -40 \end{gathered}$ | Vdc |
| Collector-Base Voltage MMBT3904WT1, SMMBT3904WT1 MMBT3906WT1, SMMBT3906WT1 | $\mathrm{V}_{\text {CBO }}$ | $\begin{gathered} 60 \\ -40 \end{gathered}$ | Vdc |
| Emitter-Base Voltage MMBT3904WT1, SMMBT3904WT1 MMBT3906WT1, SMMBT3906WT1 | $\mathrm{V}_{\text {EBO }}$ | $\begin{gathered} 6.0 \\ -5.0 \end{gathered}$ | Vdc |
| Collector Current - Continuous MMBT3904WT1, SMMBT3904WT1 MMBT3906WT1, SMMBT3906WT1 | $\mathrm{I}_{\mathrm{C}}$ | $\begin{gathered} 200 \\ -200 \end{gathered}$ | mAdc |

THERMAL CHARACTERISTICS

| Characteristic | Symbol | Max | Unit |
| :-- | :--: | :--: | :--: |
| Total Device Dissipation (Note 1) <br> @T $T_{A}=25^{\circ} \mathrm{C}$ | $\mathrm{P}_{\mathrm{D}}$ | 150 | mW |
| Thermal Resistance, Junction-to-Ambient | $\mathrm{R}_{\mathrm{II}, \mathrm{IA}}$ | 833 | ${ }^{\circ} \mathrm{C} / \mathrm{W}$ |
| Junction and Storage Temperature | $\mathrm{T}_{\mathrm{J}}, \mathrm{T}_{\text {stg }}$ | -55 to +150 | ${ }^{\circ} \mathrm{C}$ |

Stresses exceeding those listed in the Maximum Ratings table may damage the device. If any of these limits are exceeded, device functionality should not be assumed, damage may occur and reliability may be affected.

1. Device mounted on FR4 glass epoxy printed circuit board using the minimum recommended footprint.



## MARKING DIAGRAM


$x x \quad=$ AM for MMBT3904WT1, SMMBT3904WT
= 2A for MMBT3906WT1, SMMBT3906WT1
M = Date Code*
$=\mathrm{Pb}-$ Free Package
(Note: Microdot may be in either location)
*Date Code orientation may vary depending upon manufacturing location.

ORDERING INFORMATION

| Device | Package | Shipping ${ }^{\dagger}$ |
| :-- | :--: | :--: |
| MMBT3904WT1G, <br> SMMBT3904WT1G | SC-70/ <br> SOT-323 <br> (Pb-Free) | $3000 /$ Tape \& <br> Reel |
| MMBT3906WT1G, <br> SMMBT3906WT1G | SC-70/ <br> SOT-323 <br> (Pb-Free) | $3000 /$ Tape \& <br> Reel |

$\dagger$ For information on tape and reel specifications, including part orientation and tape sizes, please refer to our Tape and Reel Packaging Specifications Brochure, BRD8011/D.# MMBT3904WT1G, NPN, SMMBT3904WT1G, NPN, MMBT3906WT1G, PNP, SMMBT3906WT1G, PNP 

ELECTRICAL CHARACTERISTICS $\left(T_{A}=25^{\circ} \mathrm{C}\right.$ unless otherwise noted $)$

| Characteristic |  | Symbol | Min | Max | Unit |
| :--: | :--: | :--: | :--: | :--: | :--: |
| OFF CHARACTERISTICS |  |  |  |  |  |
| Collector-Emitter Breakdown Voltage (Note 2) $\left(\mathrm{I}_{\mathrm{C}}=1.0 \mathrm{mAdc}, \mathrm{I}_{\mathrm{B}}=0\right)$ $\left(\mathrm{I}_{\mathrm{C}}=-1.0 \mathrm{mAdc}, \mathrm{I}_{\mathrm{B}}=0\right)$ | MMBT3904WT1, SMMBT3904WT1 <br> MMBT3906WT1, SMMBT3906WT1 | $\mathrm{V}_{(\mathrm{BR}) \mathrm{CEO}}$ | $\begin{aligned} & 40 \\ & -40 \end{aligned}$ | - | Vdc |
| Collector-Base Breakdown Voltage $\left(\mathrm{I}_{\mathrm{C}}=10 \mu \mathrm{Adc}, \mathrm{I}_{\mathrm{E}}=0\right)$ $\left(\mathrm{I}_{\mathrm{C}}=-10 \mu \mathrm{Adc}, \mathrm{I}_{\mathrm{E}}=0\right)$ | MMBT3904WT1, SMMBT3904WT1 <br> MMBT3906WT1, SMMBT3906WT1 | $\mathrm{V}_{(\mathrm{BR}) \mathrm{CBO}}$ | $\begin{aligned} & 60 \\ & -40 \end{aligned}$ | - | Vdc |
| Emitter-Base Breakdown Voltage $\left(\mathrm{I}_{\mathrm{E}}=10 \mu \mathrm{Adc}, \mathrm{I}_{\mathrm{C}}=0\right)$ $\left(\mathrm{I}_{\mathrm{E}}=-10 \mu \mathrm{Adc}, \mathrm{I}_{\mathrm{C}}=0\right)$ | MMBT3904WT1, SMMBT3904WT1 <br> MMBT3906WT1, SMMBT3906WT1 | $\mathrm{V}_{(\mathrm{BR}) \mathrm{EBO}}$ | $\begin{aligned} & 6.0 \\ & -5.0 \end{aligned}$ | - | Vdc |
| Base Cutoff Current $\left(\mathrm{V}_{\mathrm{CE}}=30 \mathrm{Vdc}, \mathrm{V}_{\mathrm{EB}}=3.0 \mathrm{Vdc}\right)$ $\left(\mathrm{V}_{\mathrm{CE}}=-30 \mathrm{Vdc}, \mathrm{V}_{\mathrm{EB}}=-3.0 \mathrm{Vdc}\right)$ | MMBT3904WT1, SMMBT3904WT1 <br> MMBT3906WT1, SMMBT3906WT1 | $\mathrm{I}_{\mathrm{BL}}$ | - | $\begin{aligned} & 50 \\ & -50 \end{aligned}$ | nAdc |
| Collector Cutoff Current $\left(\mathrm{V}_{\mathrm{CE}}=30 \mathrm{Vdc}, \mathrm{V}_{\mathrm{EB}}=3.0 \mathrm{Vdc}\right)$ $\left(\mathrm{V}_{\mathrm{CE}}=-30 \mathrm{Vdc}, \mathrm{V}_{\mathrm{EB}}=-3.0 \mathrm{Vdc}\right)$ | MMBT3904WT1, SMMBT3904WT1 <br> MMBT3906WT1, SMMBT3906WT1 | $\mathrm{I}_{\text {CEX }}$ | - | $\begin{aligned} & 50 \\ & -50 \end{aligned}$ | nAdc |

ON CHARACTERISTICS (Note 2)

| DC Current Gain $\left(\mathrm{I}_{\mathrm{C}}=0.1 \mathrm{mAdc}, \mathrm{V}_{\mathrm{CE}}=1.0 \mathrm{Vdc}\right)$ $\left(\mathrm{I}_{\mathrm{C}}=1.0 \mathrm{mAdc}, \mathrm{V}_{\mathrm{CE}}=1.0 \mathrm{Vdc}\right)$ $\left(\mathrm{I}_{\mathrm{C}}=10 \mathrm{mAdc}, \mathrm{V}_{\mathrm{CE}}=1.0 \mathrm{Vdc}\right)$ $\left(\mathrm{I}_{\mathrm{C}}=50 \mathrm{mAdc}, \mathrm{V}_{\mathrm{CE}}=1.0 \mathrm{Vdc}\right)$ $\left(\mathrm{I}_{\mathrm{C}}=100 \mathrm{mAdc}, \mathrm{V}_{\mathrm{CE}}=1.0 \mathrm{Vdc}\right)$ $\left(\mathrm{I}_{\mathrm{C}}=-0.1 \mathrm{mAdc}, \mathrm{V}_{\mathrm{CE}}=-1.0 \mathrm{Vdc}\right)$ $\left(\mathrm{I}_{\mathrm{C}}=-1.0 \mathrm{mAdc}, \mathrm{V}_{\mathrm{CE}}=-1.0 \mathrm{Vdc}\right)$ $\left(\mathrm{I}_{\mathrm{C}}=-10 \mathrm{mAdc}, \mathrm{V}_{\mathrm{CE}}=-1.0 \mathrm{Vdc}\right)$ $\left(\mathrm{I}_{\mathrm{C}}=-50 \mathrm{mAdc}, \mathrm{V}_{\mathrm{CE}}=-1.0 \mathrm{Vdc}\right)$ $\left(\mathrm{I}_{\mathrm{C}}=-100 \mathrm{mAdc}, \mathrm{V}_{\mathrm{CE}}=-1.0 \mathrm{Vdc}\right)$ | MMBT3904WT1, SMMBT3904WT1 |  | $\begin{aligned} & 40 \\ & 70 \\ & 100 \\ & 60 \\ & 30 \end{aligned}$ | - | - |
| Collector-Emitter Saturation Voltage $\left(\mathrm{I}_{\mathrm{C}}=10 \mathrm{mAdc}, \mathrm{I}_{\mathrm{B}}=1.0 \mathrm{mAdc}\right)$ $\left(\mathrm{I}_{\mathrm{C}}=50 \mathrm{mAdc}, \mathrm{I}_{\mathrm{B}}=5.0 \mathrm{mAdc}\right)$ $\left(\mathrm{I}_{\mathrm{C}}=-10 \mathrm{mAdc}, \mathrm{I}_{\mathrm{B}}=-1.0 \mathrm{mAdc}\right)$ $\left(\mathrm{I}_{\mathrm{C}}=-50 \mathrm{mAdc}, \mathrm{I}_{\mathrm{B}}=-5.0 \mathrm{mAdc}\right)$ | MMBT3904WT1, SMMBT3904WT1 <br> MMBT3906WT1, SMMBT3906WT1 | $\mathrm{V}_{\text {CE(sat) }}$ | - | $\begin{aligned} & 0.2 \\ & 0.3 \\ & -0.25 \\ & -0.4 \end{aligned}$ | Vdc |
| Base-Emitter Saturation Voltage $\left(\mathrm{I}_{\mathrm{C}}=10 \mathrm{mAdc}, \mathrm{I}_{\mathrm{B}}=1.0 \mathrm{mAdc}\right)$ $\left(\mathrm{I}_{\mathrm{C}}=50 \mathrm{mAdc}, \mathrm{I}_{\mathrm{B}}=5.0 \mathrm{mAdc}\right)$ $\left(\mathrm{I}_{\mathrm{C}}=-10 \mathrm{mAdc}, \mathrm{I}_{\mathrm{B}}=-1.0 \mathrm{mAdc}\right)$ $\left(\mathrm{I}_{\mathrm{C}}=-50 \mathrm{mAdc}, \mathrm{I}_{\mathrm{B}}=-5.0 \mathrm{mAdc}\right)$ | MMBT3904WT1, SMMBT3904WT1 <br> MMBT3906WT1, SMMBT3906WT1 | $\mathrm{V}_{\mathrm{BE}(\text { sat) }}$ | $\begin{aligned} & 0.65 \\ & - \\ & -0.65 \\ & - \end{aligned}$ | $\begin{aligned} & 0.85 \\ & 0.95 \\ & -0.85 \\ & -0.95 \end{aligned}$ | Vdc |

2. Pulse Test: Pulse Width $\leq 300 \mu \mathrm{~s}$; Duty Cycle $\leq 2.0 \%$.# MMBT3904WT1G, NPN, SMMBT3904WT1G, NPN, MMBT3906WT1G, PNP, SMMBT3906WT1G, PNP 

ELECTRICAL CHARACTERISTICS ( $\mathrm{T}_{\mathrm{A}}=25^{\circ} \mathrm{C}$ unless otherwise noted) (Continued)

| Characteristic |  | Symbol | Min | Max | Unit |
| :--: | :--: | :--: | :--: | :--: | :--: |
| SMALL-SIGNAL CHARACTERISTICS |  |  |  |  |  |
| Current-Gain - Bandwidth Product $\left(\mathrm{I}_{\mathrm{C}}=10 \mathrm{mAdc}, \mathrm{V}_{\mathrm{CE}}=20 \mathrm{Vdc}, \mathrm{f}=100 \mathrm{MHz}\right)$ $\left(\mathrm{I}_{\mathrm{C}}=-10 \mathrm{mAdc}, \mathrm{V}_{\mathrm{CE}}=-20 \mathrm{Vdc}, \mathrm{f}=100 \mathrm{MHz}\right)$ | MMBT3904WT1, SMMBT3904WT1 <br> MMBT3906WT1, SMMBT3906WT1 | $\mathrm{f}_{\mathrm{T}}$ | $\begin{aligned} & 300 \\ & 250 \end{aligned}$ | - | MHz |
| Output Capacitance $\left(\mathrm{V}_{\mathrm{CB}}=5.0 \mathrm{Vdc}, \mathrm{I}_{\mathrm{E}}=0, \mathrm{f}=1.0 \mathrm{MHz}\right)$ $\left(\mathrm{V}_{\mathrm{CB}}=-5.0 \mathrm{Vdc}, \mathrm{I}_{\mathrm{E}}=0, \mathrm{f}=1.0 \mathrm{MHz}\right)$ | MMBT3904WT1, SMMBT3904WT1 <br> MMBT3906WT1, SMMBT3906WT1 | $\mathrm{C}_{\text {obo }}$ | - | $\begin{aligned} & 4.0 \\ & 4.5 \end{aligned}$ | pF |
| Input Capacitance $\left(\mathrm{V}_{\mathrm{EB}}=0.5 \mathrm{Vdc}, \mathrm{I}_{\mathrm{C}}=0, \mathrm{f}=1.0 \mathrm{MHz}\right)$ $\left(\mathrm{V}_{\mathrm{EB}}=-0.5 \mathrm{Vdc}, \mathrm{I}_{\mathrm{C}}=0, \mathrm{f}=1.0 \mathrm{MHz}\right)$ | MMBT3904WT1, SMMBT3904WT1 <br> MMBT3906WT1, SMMBT3906WT1 | $\mathrm{C}_{\text {Bo }}$ | - | $\begin{aligned} & 8.0 \\ & 10.0 \end{aligned}$ | pF |
| Input Impedance $\left(\mathrm{V}_{\mathrm{CE}}=10 \mathrm{Vdc}, \mathrm{I}_{\mathrm{C}}=1.0 \mathrm{mAdc}, \mathrm{f}=1.0 \mathrm{kHz}\right)$ $\left(\mathrm{V}_{\mathrm{CE}}=-10 \mathrm{Vdc}, \mathrm{I}_{\mathrm{C}}=-1.0 \mathrm{mAdc}, \mathrm{f}=1.0 \mathrm{kHz}\right)$ | MMBT3904WT1, SMMBT3904WT1 <br> MMBT3906WT1, SMMBT3906WT1 | $\mathrm{h}_{\text {ie }}$ | $\begin{aligned} & 1.0 \\ & 2.0 \end{aligned}$ | $\begin{aligned} & 10 \\ & 12 \end{aligned}$ | $\mathrm{k} \Omega$ |
| Voltage Feedback Ratio $\left(\mathrm{V}_{\mathrm{CE}}=10 \mathrm{Vdc}, \mathrm{I}_{\mathrm{C}}=1.0 \mathrm{mAdc}, \mathrm{f}=1.0 \mathrm{kHz}\right)$ $\left(\mathrm{V}_{\mathrm{CE}}=-10 \mathrm{Vdc}, \mathrm{I}_{\mathrm{C}}=-1.0 \mathrm{mAdc}, \mathrm{f}=1.0 \mathrm{kHz}\right)$ | MMBT3904WT1, SMMBT3904WT1 <br> MMBT3906WT1, SMMBT3906WT1 | $\mathrm{h}_{\text {ie }}$ | $\begin{aligned} & 0.5 \\ & 0.1 \end{aligned}$ | $\begin{aligned} & 8.0 \\ & 10 \end{aligned}$ | $\times 10^{-4}$ |
| Small-Signal Current Gain $\left(\mathrm{V}_{\mathrm{CE}}=10 \mathrm{Vdc}, \mathrm{I}_{\mathrm{C}}=1.0 \mathrm{mAdc}, \mathrm{f}=1.0 \mathrm{kHz}\right)$ $\left(\mathrm{V}_{\mathrm{CE}}=-10 \mathrm{Vdc}, \mathrm{I}_{\mathrm{C}}=-1.0 \mathrm{mAdc}, \mathrm{f}=1.0 \mathrm{kHz}\right)$ | MMBT3904WT1, SMMBT3904WT1 <br> MMBT3906WT1, SMMBT3906WT1 | $\mathrm{h}_{\text {te }}$ | $\begin{aligned} & 100 \\ & 100 \end{aligned}$ | $\begin{aligned} & 400 \\ & 400 \end{aligned}$ | - |
| Output Admittance $\left(\mathrm{V}_{\mathrm{CE}}=10 \mathrm{Vdc}, \mathrm{I}_{\mathrm{C}}=1.0 \mathrm{mAdc}, \mathrm{f}=1.0 \mathrm{kHz}\right)$ $\left(\mathrm{V}_{\mathrm{CE}}=-10 \mathrm{Vdc}, \mathrm{I}_{\mathrm{C}}=-1.0 \mathrm{mAdc}, \mathrm{f}=1.0 \mathrm{kHz}\right)$ | MMBT3904WT1, SMMBT3904WT1 <br> MMBT3906WT1, SMMBT3906WT1 | $\mathrm{h}_{\text {oe }}$ | $\begin{aligned} & 1.0 \\ & 3.0 \end{aligned}$ | $\begin{aligned} & 40 \\ & 60 \end{aligned}$ | $\mu \mathrm{mhos}$ |
| Noise Figure $\left(\mathrm{V}_{\mathrm{CE}}=5.0 \mathrm{Vdc}, \mathrm{I}_{\mathrm{C}}=100 \mu \mathrm{Adc}, \mathrm{R}_{\mathrm{S}}=1.0 \mathrm{k} \Omega, \mathrm{f}=1.0 \mathrm{kHz}\right)$ <br> MMBT3904WT1, SMMBT3904WT1 $\left(\mathrm{V}_{\mathrm{CE}}=-5.0 \mathrm{Vdc}, \mathrm{I}_{\mathrm{C}}=-100 \mu \mathrm{Adc}, \mathrm{R}_{\mathrm{S}}=1.0 \mathrm{k} \Omega, \mathrm{f}=1.0 \mathrm{kHz}\right)$ <br> MMBT3906WT1, SMMBT3906WT1 |  | NF | - | $\begin{aligned} & 5.0 \\ & 4.0 \end{aligned}$ | dB |

SWITCHING CHARACTERISTICS

| Characteristic | Condition | Symbol | Min | Max | Unit |
| :--: | :--: | :--: | :--: | :--: | :--: |
| Delay Time | $\left(\mathrm{V}_{\mathrm{CC}}=3.0 \mathrm{Vdc}, \mathrm{V}_{\mathrm{BE}}=-0.5 \mathrm{Vdc}\right)$ <br> MMBT3904WT1, SMMBT3904WT1 <br> $\left(\mathrm{V}_{\mathrm{CC}}=-3.0 \mathrm{Vdc}, \mathrm{V}_{\mathrm{BE}}=0.5 \mathrm{Vdc}\right)$ <br> MMBT3906WT1, SMMBT3906WT1 | $\mathrm{t}_{\mathrm{d}}$ | - | $\begin{aligned} & 35 \\ & 35 \end{aligned}$ | ns |
| Rise Time | $\left(\mathrm{I}_{\mathrm{C}}=10 \mathrm{mAdc}, \mathrm{I}_{\mathrm{B} 1}=1.0 \mathrm{mAdc}\right)$ <br> MMBT3904WT1, SMMBT3904WT1 <br> $\left(\mathrm{I}_{\mathrm{C}}=-10 \mathrm{mAdc}, \mathrm{I}_{\mathrm{B} 1}=-1.0 \mathrm{mAdc}\right)$ <br> MMBT3906WT1, SMMBT3906WT1 | $\mathrm{t}_{\mathrm{r}}$ | - | $\begin{aligned} & 35 \\ & 35 \end{aligned}$ |  |
| Storage Time | $\left(\mathrm{V}_{\mathrm{CC}}=3.0 \mathrm{Vdc}, \mathrm{I}_{\mathrm{C}}=10 \mathrm{mAdc}\right)$ <br> MMBT3904WT1, SMMBT3904WT1 <br> $\left(\mathrm{V}_{\mathrm{CC}}=-3.0 \mathrm{Vdc}, \mathrm{I}_{\mathrm{C}}=-10 \mathrm{mAdc}\right)$ <br> MMBT3906WT1, SMMBT3906WT1 | $\mathrm{t}_{\mathrm{s}}$ | - | $\begin{aligned} & 200 \\ & 225 \end{aligned}$ | ns |
| Fall Time | $\left(\mathrm{I}_{\mathrm{B} 1}=\mathrm{I}_{\mathrm{B} 2}=1.0 \mathrm{mAdc}\right)$ <br> $\left(\mathrm{I}_{\mathrm{B} 1}=\mathrm{I}_{\mathrm{B} 2}=-1.0 \mathrm{mAdc}\right)$ | MMBT3904WT1, SMMBT3904WT1 <br> MMBT3906WT1, SMMBT3906WT1 | $\mathrm{t}_{\mathrm{f}}$ | - | $\begin{aligned} & 50 \\ & 75 \end{aligned}$ |MMBT3904WT1G, NPN, SMMBT3904WT1G, NPN, MMBT3906WT1G, PNP, SMMBT3906WT1G, PNP
MMBT3904WT1, SMMBT3904WT1


* Total shunt capacitance of test jig and connectors

Figure 1. Delay and Rise Time Equivalent Test Circuit

Figure 2. Storage and Fall Time Equivalent Test Circuit# TYPICAL TRANSIENT CHARACTERISTICS 



## TYPICAL AUDIO SMALL-SIGNAL CHARACTERISTICS NOISE FIGURE VARIATIONS

$\left(\mathrm{V}_{\mathrm{CE}}=5.0 \mathrm{VDC}, \mathrm{T}_{\mathrm{A}}=25^{\circ} \mathrm{C}, \mathrm{BANDWIDTH}=1.0 \mathrm{HZ}\right)$


Figure 7. Noise Figure


Figure 4. Rise Time


Figure 6. Fall Time
MMBT3904WT1G, NPN, SMMBT3904WT1G, NPN, MMBT3906WT1G, PNP, SMMBT3906WT1G, PNP
MMBT3904WT1, SMMBT3904WT1


Figure 11. Input Impedance
Figure 12. Voltage Feedback Ratio

# TYPICAL STATIC CHARACTERISTICS 



Figure 13. DC Current GainMMBT3904WT1G, NPN, SMMBT3904WT1G, NPN, MMBT3906WT1G, PNP, SMMBT3906WT1G, PNP
MMBT3904WT1, SMMBT3904WT1


Figure 14. Collector Saturation Region


Figure 15. Collector Emitter Saturation Voltage vs. Collector Current


Figure 17. Base Emitter Voltage vs. Collector
CurrentMMBT3904WT1G, NPN, SMMBT3904WT1G, NPN, MMBT3906WT1G, PNP, SMMBT3906WT1G, PNP
MMBT3904WT1, SMMBT3904WT1


Figure 18. Temperature Coefficients


Figure 20. Current Gain Bandwidth Product vs. Collector Current


Figure 19. Capacitance


Figure 21. Safe Operating AreaMMBT3904WT1G, NPN, SMMBT3904WT1G, NPN, MMBT3906WT1G, PNP, SMMBT3906WT1G, PNP
MMBT3906WT1, SMMBT3906WT1


* Total shunt capacitance of test jig and connectors

Figure 22. Delay and Rise Time Equivalent Test Circuit

Figure 23. Storage and Fall Time Equivalent Test Circuit

# TYPICAL TRANSIENT CHARACTERISTICS 



Figure 25. Fall Time

## TYPICAL AUDIO SMALL-SIGNAL CHARACTERISTICS NOISE FIGURE VARIATIONS



Figure 26.
Figure 27.MMBT3904WT1G, NPN, SMMBT3904WT1G, NPN, MMBT3906WT1G, PNP, SMMBT3906WT1G, PNP
MMBT3906WT1, SMMBT3906WT1

# H PARAMETERS 

$\left(V_{C E}=-10 \mathrm{VDC}, \mathrm{F}=1.0 \mathrm{KHZ}, \mathrm{T}_{\mathrm{A}}=25^{\circ} \mathrm{C}\right)$


Figure 28. Current Gain


Figure 30. Input Impedance


Figure 29. Output Admittance


Figure 31. Voltage Feedback Ratio

## STATIC CHARACTERISTICS



Figure 32. DC Current GainMMBT3904WT1G, NPN, SMMBT3904WT1G, NPN, MMBT3906WT1G, PNP, SMMBT3906WT1G, PNP
MMBT3906WT1, SMMBT3906WT1


Figure 33. Collector Saturation Region


Figure 34. Collector Emitter Saturation Voltage vs. Collector Current


Figure 35. Base Emitter Saturation Voltage vs. Collector Current


Figure 36. Base Emitter Voltage vs. Collector CurrentMMBT3904WT1G, NPN, SMMBT3904WT1G, NPN, MMBT3906WT1G, PNP, SMMBT3906WT1G, PNP
MMBT3906WT1, SMMBT3906WT1
#  

SC-70 (SOT-323)
CASE 419
ISSUE R
DATE 11 OCT 2022

SCALE 4:1


GENERIC
MARKING DIAGRAM

$\mathrm{XX} \quad=$ Specific Device Code
M = Date Code
$\bullet \quad=$ Pb-Free Package
*This information is generic. Please refer to device data sheet for actual part marking. Pb -Free indicator, "G" or microdot " $\bullet$ ", may or may not be present. Some products may not follow the Generic Marking.

| STYLE 1: <br> CANCELLED | STYLE 2: <br> PIN 1, ANGDE <br> 2. N.C. <br> 3. CATHODE | STYLE 3: <br> PIN 1, BASE <br> 2. EMITTER <br> 3. COLLECTOR | STYLE 4: <br> PIN 1, CATHODE <br> 2. CATHODE <br> 3. ANGDE | STYLE 5: <br> PIN 1, ANGDE <br> 2. CATHODE <br> 3. ANGDE | STYLE 6: <br> PIN 1, ANGDE <br> 2. ANGDE <br> 3. CATHODE | STYLE 7: <br> PIN 1, BASE <br> 2. ANGDE <br> 3. CATHODE |
| :--: | :--: | :--: | :--: | :--: | :--: | :--: |
| STYLE 8: <br> PIN 1, EMITTER <br> 2. BASE <br> 3. COLLECTOR | STYLE 7: <br> PIN 1, BASE <br> 2. EMITTER <br> 3. COLLECTOR | STYLE 8: <br> PIN 1, GATE <br> 2. SOURCE <br> 3. DRAIN | STYLE 9: <br> PIN 1, ANGDE <br> 2. CATHODE <br> 3. CATHODE-ANGDE | STYLE 10: <br> PIN 1, CATHODE <br> 2. ANGDE <br> 3. ANGDE-CATHODE | STYLE 11: <br> PIN 1, CATHODE <br> 2. CATHODE <br> 3. CATHODE | STYLE 12: <br> PIN 1, CATHODE <br> 2. CATHODE <br> 3. CATHODE |



| DOCUMENT NUMBER: | 98ASB42819B |  |  | Electronic versions are uncontrolled except when accessed directly from the Document Repository. Printed versions are uncontrolled except when damped "CONTROLLED COPY" in red. |  |  |
| :--: | :--: | :--: | :--: | :--: | :--: | :--: |
| DESCRIPTION: | SC-70 (SOT-323) |  |  |  |  | PAGE 1 OF 1 |

[^0]
[^0]:    onsemi and OTSENTL are trademarks of Semiconductor Components Industries, LLC dba onsemi or its subsidiaries in the United States and/or other countries. onsemi reserves the right to make changes without further notice to any products herein. onsemi makes no warranty, representation or guarantee regarding the suitability of its products for any particular purpose, nor does onsemi assume any liability arising out of the application or use of any product or circuit, and specifically disclaims any and all liability, including without limitation special, consequential or incidental damages. onsemi does not convey any license under its patent rights nor the rights of others.onsemi, CITOUNTS, and other names, marks, and brands are registered and/or common law trademarks of Semiconductor Components Industries, LLC dba "onsemi" or its affiliates and/or subsidiaries in the United States and/or other countries. onsemi owns the rights to a number of patents, trademarks, copyrights, trade secrets, and other intellectual property. A listing of onsemi's product/patent coverage may be accessed at www.onsemi.com/site/pdf/Patent-Marking.pdf. onsemi reserves the right to make changes at any time to any products or information herein, without notice. The information herein is provided "as-is" and onsemi makes no warranty, representation or guarantee regarding the accuracy of the information, product features, availability, functionality, or suitability of its products for any particular purpose, nor does onsemi assume any liability arising out of the application or use of any product or circuit, and specifically disclaims any and all liability, including without limitation special, consequential or incidental damages. Buyer is responsible for its products and applications using onsemi products, including compliance with all laws, regulations and safety requirements or standards, regardless of any support or applications information provided by onsemi. "Typical" parameters which may be provided in onsemi data sheets and/or specifications can and do vary in different applications and actual performance may vary over time. All operating parameters, including "Typicals" must be validated for each customer application by customer's technical experts. onsemi does not convey any license under any of its intellectual property rights nor the rights of others. onsemi products are not designed, intended, or authorized for use as a critical component in life support systems or any FDA Class 3 medical devices or medical devices with a same or similar classification in a foreign jurisdiction or any devices intended for implantation in the human body. Should Buyer purchase or use onsemi products for any such unintended or unauthorized application, Buyer shall indemnify and hold onsemi and its officers, employees, subsidiaries, affiliates, and distributors harmless against all claims, costs, damages, and expenses, and reasonable attorney fees arising out of, directly or indirectly, any claim of personal injury or death associated with such unintended or unauthorized use, even if such claim alleges that onsemi was negligent regarding the design or manufacture of the part. onsemi is an Equal Opportunity/Affirmative Action Employer. This literature is subject to all applicable copyright laws and is not for resale in any manner.

# ADDITIONAL INFORMATION 

## TECHNICAL PUBLICATIONS:

Technical Library: www.onsemi.com/design/resources/technical-documentation onsemi Website: www.onsemi.com

ONLINE SUPPORT: www.onsemi.com/support
For additional information, please contact your local Sales Representative at www.onsemi.com/support/sales
