dioderobot/arduino/components/MMDT3904-7-F_SOT363_6P/C83572.md

Features

- Epitaxial Planar Die Construction
- Ideal for Medium Power Amplification and Switching
- Ultra-Small Surface Mount Package
- Totally Lead-Free \& Fully RoHS Compliant (Notes 1 \& 2)
- Halogen and Antimony Free. "Green" Device (Note 3)
- Qualified to AEC-Q101 Standards for High Reliability

## Mechanical Data

- Case: SOT363
- Case Material: Molded Plastic, "Green" Molding Compound; UL Flammability Classification Rating 94V-0
- Moisture Sensitivity: Level 1 per J-STD-020
- Terminals: Finish - Matte Tin Finish; Solderable per MIL-STD202, Method 208®
- Weight: 0.006 grams (Approximate)

SOT363


Top View


Device Schematic
Top View

# Ordering Information 

| Product | Status | Compliance | Marking | Reel size (inches) | Tape width (mm) | Quantity per reel |
| :--: | :--: | :--: | :--: | :--: | :--: | :--: |
| MMDT3904-7-F | Active | AEC-Q101 | K6N | 7 | 8 | 3,000 |

Notes: 1. No purposely added lead. Fully EU Directive 2002/95/EC (RoHS) \& 2011/65/EU (RoHS 2) compliant.
2. See http://www.diodes.com/quality/lead_free.html for more information about Diodes Incorporated's definitions of Halogen- and Antimony-free, "Green" and Lead-free.
3. Halogen- and Antimony-free "Green" products are defined as those which contain <900ppm bromine, <900ppm chlorine ( $<1500 \mathrm{ppm}$ total $\mathrm{Br}+\mathrm{Cl}$ ) and $<1000 \mathrm{ppm}$ antimony compounds.
4. For packaging details, go to our website at http://www.diodes.com/products/packages.html.

## Marking Information

SOT363


K6N = Product Type Marking Code
YM = Date Code Marking
Y or $\bar{Y}=$ Year (ex: $D=2016$ )
M or $\bar{M}=$ Month (ex: $9=$ September)

Date Code Key

| Year | 2015 |  | 2016 |  | 2017 |  | 2018 |  | 2019 |  | 2020 |  | 2021 |  | 2022 |  |
| :--: | :--: | :--: | :--: | :--: | :--: | :--: | :--: | :--: | :--: | :--: | :--: | :--: | :--: | :--: | :--: | :--: |
| Code | C |  | D |  | E |  | F |  | G |  | H |  | I |  | J |  |
| Month | Jan | Feb | Mar |  | Apr |  | May |  | Jun |  | Jul | Aug | Sep | Oct | Nov | Dec |
| Code | 1 | 2 | 3 |  | 4 |  | 5 |  | 6 |  | 7 | 8 | 9 | 0 | N | D |# Absolute Maximum Ratings ( $\left.\mathrm{GP}_{\mathrm{A}}=+25^{\circ} \mathrm{C}\right)$, unless otherwise specified.) 

| Characteristic | Symbol | Value | Unit |
| :-- | :--: | :--: | :--: |
| Collector-Base Voltage | $\mathrm{V}_{\text {CBO }}$ | 60 | V |
| Collector-Emitter Voltage | $\mathrm{V}_{\text {CEO }}$ | 40 | V |
| Emitter-Base Voltage | $\mathrm{V}_{\text {EBO }}$ | 6.0 | V |
| Collector Current | $\mathrm{I}_{\mathrm{C}}$ | 200 | mA |

## Thermal Characteristics

| Characteristic | Symbol | Value | Unit |
| :-- | :--: | :--: | :--: |
| Power Dissipation (Note 5) | $\mathrm{P}_{\mathrm{D}}$ | 200 | mW |
| Thermal Resistance, Junction to Ambient (Note 5) | $\mathrm{R}_{\mathrm{BJA}}$ | 625 | ${ }^{\circ} \mathrm{C} / \mathrm{W}$ |
| Operating and Storage and Temperature Range | $\mathrm{T}_{\mathrm{J}}, \mathrm{T}_{\mathrm{STG}}$ | -55 to +150 | ${ }^{\circ} \mathrm{C}$ |

## ESD Ratings (Note 6)

| Characteristic | Symbol | Value | Unit | JEDEC Class |
| :-- | :--: | :--: | :--: | :--: |
| Electrostatic Discharge - Human Body Model | ESD HBM | 4,000 | V | 3 A |
| Electrostatic Discharge - Machine Model | ESD MM | 400 | V | C |

Notes: 5. For the device mounted on minimum recommended pad layout FR4 PCB with high coverage of single sided 1 oz copper, in still air conditions; the device is measured when operating in a steady-state condition.
6. Refer to JEDEC specification JESD22-A114 and JESD22-A115.

## Thermal Characteristic and Derating Information

# Electrical Characteristics (@TA $=+25^{\circ} \mathrm{C}$, unless otherwise specified.)

| Characteristic | Symbol | Min | Max | Unit | Test Condition |
| :--: | :--: | :--: | :--: | :--: | :--: |
| OFF CHARACTERISTICS |  |  |  |  |  |
| Collector-Base Breakdown Voltage | $\mathrm{BV}_{\text {CBO }}$ | 60 | — | V | $\mathrm{I}_{\mathrm{C}}=100 \mu \mathrm{~A}, \mathrm{I}_{\mathrm{E}}=0$ |
| Collector-Emitter Breakdown Voltage (Note 7) | $\mathrm{BV}_{\text {CEO }}$ | 40 | — | V | $\mathrm{I}_{\mathrm{C}}=10.0 \mathrm{~mA}, \mathrm{I}_{\mathrm{B}}=0$ |
| Emitter-Base Breakdown Voltage | $\mathrm{BV}_{\text {EBO }}$ | 6.0 | — | V | $\mathrm{I}_{\mathrm{E}}=100 \mu \mathrm{~A}, \mathrm{I}_{\mathrm{C}}=0$ |
| Collector-Base Cut-Off Current | $\mathrm{I}_{\text {CBO }}$ | - | 50 | nA | $\mathrm{V}_{\mathrm{CB}}=50 \mathrm{~V}$ |
| Collector-Emitter Cut-Off Current | $\mathrm{I}_{\mathrm{CEV}}$ | - | 50 | nA | $\begin{aligned} & \mathrm{V}*{\mathrm{CE}}=40 \mathrm{~V}, \mathrm{~V}*{\mathrm{BE}(\mathrm{OFF})}=3.0 \mathrm{~V} \\ & \mathrm{~V}*{\mathrm{CE}}=40 \mathrm{~V}, \mathrm{~V}*{\mathrm{BE}(\mathrm{ON})}=0.25 \mathrm{~V} \end{aligned}$ |
| Emitter-Base Cut-Off Current | $\mathrm{I}_{\text {EBO }}$ | - | 50 | nA | $\mathrm{V}_{\mathrm{EB}}=5 \mathrm{~V}$ |
| ON CHARACTERISTICS (Note 7) |  |  |  |  |  |
| DC Current Gain | $\mathrm{h}_{\mathrm{FE}}$ | $\begin{gathered} 40 \\ 70 \\ 100 \\ 60 \\ 30 \end{gathered}$ | $\begin{aligned} & \text { — } \\ & 300 \\ & \text { — } \\ & \text { — } \end{aligned}$ | — | $\begin{aligned} & \mathrm{I}*{\mathrm{C}}=100 \mu \mathrm{~A}, \mathrm{~V}*{\mathrm{CE}}=1.0 \mathrm{~V} \\ & \mathrm{I}*{\mathrm{C}}=1.0 \mathrm{~mA}, \mathrm{~V}*{\mathrm{CE}}=1.0 \mathrm{~V} \\ & \mathrm{I}*{\mathrm{C}}=10 \mathrm{~mA}, \mathrm{~V}*{\mathrm{CE}}=1.0 \mathrm{~V} \\ & \mathrm{I}*{\mathrm{C}}=50 \mathrm{~mA}, \mathrm{~V}*{\mathrm{CE}}=1.0 \mathrm{~V} \\ & \mathrm{I}*{\mathrm{C}}=100 \mathrm{~mA}, \mathrm{~V}*{\mathrm{CE}}=1.0 \mathrm{~V} \end{aligned}$ |
| Collector-Emitter Saturation Voltage | $\mathrm{V}_{\text {CE }(\text { sat }}$ | - | $\begin{aligned} & 0.20 \\ & 0.30 \end{aligned}$ | V | $\begin{aligned} & \mathrm{I}*{\mathrm{C}}=10 \mathrm{~mA}, \mathrm{I}*{\mathrm{B}}=1.0 \mathrm{~mA} \\ & \mathrm{I}*{\mathrm{C}}=50 \mathrm{~mA}, \mathrm{I}*{\mathrm{B}}=5.0 \mathrm{~mA} \end{aligned}$ |
| Base-Emitter Saturation Voltage | $\mathrm{V}_{\mathrm{BE}(\text { sat }}$ | $\begin{aligned} & 0.65 \\ & - \end{aligned}$ | $\begin{aligned} & 0.85 \\ & 0.95 \end{aligned}$ | V | $\begin{aligned} & \mathrm{I}*{\mathrm{C}}=10 \mathrm{~mA}, \mathrm{I}*{\mathrm{B}}=1.0 \mathrm{~mA} \\ & \mathrm{I}*{\mathrm{C}}=50 \mathrm{~mA}, \mathrm{I}_{\mathrm{B}}=5.0 \mathrm{~mA} \end{aligned}$ |
| SMALL SIGNAL CHARACTERISTICS |  |  |  |  |  |
| Output Capacitance | $\mathrm{C}_{\text {obo }}$ | - | 4.0 | pF | $\mathrm{V}_{\mathrm{CB}}=5.0 \mathrm{~V}, \mathrm{f}=1.0 \mathrm{MHz}, \mathrm{I}_{\mathrm{E}}=0$ |
| Input Capacitance | $\mathrm{C}_{\text {ibo }}$ | - | 8.0 | pF | $\mathrm{V}_{\mathrm{EB}}=0.5 \mathrm{~V}, \mathrm{f}=1.0 \mathrm{MHz}, \mathrm{I}_{\mathrm{C}}=0$ |
| Input Impedance | $\mathrm{h}_{\text {ip }}$ | 1.0 | 10 | k 1 |  |
| Voltage Feedback Ratio | $\mathrm{h}_{\mathrm{ff}}$ | 0.5 | 8.0 | $\times 10^{-4}$ | $\mathrm{V}_{\mathrm{CE}}=10 \mathrm{~V}, \mathrm{I}_{\mathrm{C}}=1.0 \mathrm{~mA}$, $\mathrm{f}=1.0 \mathrm{kHz}$ |
| Small Signal Current Gain | $\mathrm{h}_{\mathrm{ss}}$ | 100 | 400 | — |  |
| Output Admittance | $\mathrm{h}_{\text {oa }}$ | 1.0 | 40 | $\mu \mathrm{S}$ |  |
| Current Gain-Bandwidth Product | $\mathrm{f}_{\mathrm{T}}$ | 300 | - | MHz | $\begin{aligned} & \mathrm{V}*{\mathrm{CE}}=20 \mathrm{~V}, \mathrm{I}*{\mathrm{C}}=10 \mathrm{~mA}, \\ & \mathrm{f}=100 \mathrm{MHz} \end{aligned}$ |
| Noise Figure | NF | - | 5.0 | dB | $\begin{aligned} & \mathrm{V}*{\mathrm{CE}}=5.0 \mathrm{~V}, \mathrm{I}*{\mathrm{C}}=100 \mu \mathrm{~A}, \\ & \mathrm{R}*{\mathrm{S}}=1.0 \mathrm{k} \Omega, \mathrm{f}=1.0 \mathrm{kHz} \end{aligned}$ |
| SWITCHING CHARACTERISTICS |  |  |  |  |  |
| Delay Time | $\mathrm{t}_{\mathrm{d}}$ | - | 35 | ns | $\mathrm{V}_{\mathrm{CC}}=3.0 \mathrm{~V}, \mathrm{I}_{\mathrm{C}}=10 \mathrm{~mA}$, |
| Rise Time | $\mathrm{t}_{\mathrm{r}}$ | - | 35 | ns | $\begin{aligned} & \mathrm{V}_{\mathrm{RE}(\text { off }}=-0.5 \mathrm{~V}, \mathrm{I}_{\mathrm{B} 1}=1.0 \mathrm{~mA} \end{aligned}$ |
| Storage Time | $\mathrm{t}_{\mathrm{s}}$ | - | 200 | ns | $\mathrm{V}_{\mathrm{CC}}=3.0 \mathrm{~V}, \mathrm{I}_{\mathrm{C}}=10 \mathrm{~mA}$, |
| Fall Time | $\mathrm{t}_{\mathrm{f}}$ | - | 50 | ns | $\mathrm{I}_{\mathrm{B} 1}=\mathrm{I}_{\mathrm{B} 2}=1.0 \mathrm{~mA}$ |

Note: 7. Measured under pulsed conditions. Pulse width $\leq 300 \mu \mathrm{~s}$. Duty cycle $\leq 2 \%$.

# Typical Electrical Characteristics (@TA = +25°C, unless otherwise specified.)

## Table 1: Typical Electrical Characteristics

|  **Parameter** | **Value**  |
| --- | --- |
|  **AC** | 1.000  |
|  **DC** | 1.000  |
|  **AC** | 1.000  |
|  **CE** | 1.000  |
|  **FWHM** | 100  |
|  **PRIORITY** | 10  |
|  **AC** | 1.000  |
|  **DC** | 1.000  |
|  **CE** | 1.000  |
|  **FWHM** | 100  |
|  **PRIORITY** | 10  |
|  **AC** | 1.000  |
|  **DC** | 1.000  |
|  **CE** | 1.000  |
|  **FWHM** | 100  |
|  **PRIORITY** | 10  |
|  **AC** | 1.000  |
|  **DC** | 1.000  |
|  **CE** | 1.000  |
|  **FWHM** | 100  |
|  **PRIORITY** | 10  |
|  **AC** | 1.000  |
|  **DC** | 1.000  |
|  **CE** | 1.000  |
|  **FWHM** | 100  |
|  **PRIORITY** | 10  |
|  **AC** | 1.000  |
|  **DC** | 1.000  |
|  **CE** | 1.000  |
|  **FWHM** | 100  |
|  **PRIORITY** | 10  |
|  **AC** | 1.000  |
|  **DC** | 1.000  |
|  **CE** | 1.000  |
|  **FWHM** | 100  |
|  **PRIORITY** | 10  |
|  **AC** | 1.000  |
|  **DC** | 1.000  |
|  **CE** | 1.000  |
|  **FWHM** | 100  |
|  **PRIORITY** | 10  |
|  **AC** | 1.000  |
|  **DC** | 1.000  |
|  **CE** | 1.000  |
|  **FWHM** | 100  |
|  **PRIORITY** | 10  |
|  **AC** | 1.000  |
|  **DC** | 1.000  |
|  **CE** | 1.000  |
|  **FWHM** | 100  |
|  **PRIORITY** | 10  |
|  **AC** | 1.000  |
|  **DC** | 1.000  |
|  **CE** | 1.000  |
|  **FWHM** | 100  |
|  **PRIORITY** | 10  |
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
|  **DC** | 1.0  |
|  **DC** | 1.0  |
|  **DC** | 1.0  |
|  **DC** | 1.0  |
|  **DC** | 1.0  |
|  **DC** | 1.0  |
|  **DC** | 1.0  |
|  **DC** | 1.0  |
|  **DC** | 1.0  |
# Package Outline Dimensions 

Please see http://www.diodes.com/package-outlines.html for the latest version.


| SOT363 |  |  |  |
| :--: | :--: | :--: | :--: |
| Dim | Min | Max | Typ |
| A1 | 0.00 | 0.10 | 0.05 |
| A2 | 0.90 | 1.00 | 1.00 |
| b | 0.10 | 0.30 | 0.25 |
| c | 0.10 | 0.22 | 0.11 |
| D | 1.80 | 2.20 | 2.15 |
| E | 2.00 | 2.20 | 2.10 |
| E1 | 1.15 | 1.35 | 1.30 |
| e | 0.650 BSC |  |  |
| F | 0.40 | 0.45 | 0.425 |
| L | 0.25 | 0.40 | 0.30 |
| a | $0^{\circ}$ | $8^{\circ}$ | - |
| All Dimensions in mm |  |  |  |

## Suggested Pad Layout

Please see http://www.diodes.com/package-outlines.html for the latest version.


| Dimensions | Value <br> (in mm) |
| :--: | :--: |
| C | 0.650 |
| G | 1.300 |
| X | 0.420 |
| Y | 0.600 |
| Y1 | 2.500 |# IMPORTANT NOTICE 

DIODES INCORPORATED MAKES NO WARRANTY OF ANY KIND, EXPRESS OR IMPLIED, WITH REGARDS TO THIS DOCUMENT, INCLUDING, BUT NOT LIMITED TO, THE IMPLIED WARRANTIES OF MERCHANTABILITY AND FITNESS FOR A PARTICULAR PURPOSE (AND THEIR EQUIVALENTS UNDER THE LAWS OF ANY JURISDICTION).

Diodes Incorporated and its subsidiaries reserve the right to make modifications, enhancements, improvements, corrections or other changes without further notice to this document and any product described herein. Diodes Incorporated does not assume any liability arising out of the application or use of this document or any product described herein; neither does Diodes Incorporated convey any license under its patent or trademark rights, nor the rights of others. Any Customer or user of this document or products described herein in such applications shall assume all risks of such use and will agree to hold Diodes Incorporated and all the companies whose products are represented on Diodes Incorporated website, harmless against all damages.

Diodes Incorporated does not warrant or accept any liability whatsoever in respect of any products purchased through unauthorized sales channel. Should Customers purchase or use Diodes Incorporated products for any unintended or unauthorized application, Customers shall indemnify and hold Diodes Incorporated and its representatives harmless against all claims, damages, expenses, and attorney fees arising out of, directly or indirectly, any claim of personal injury or death associated with such unintended or unauthorized application.

Products described herein may be covered by one or more United States, international or foreign patents pending. Product names and markings noted herein may also be covered by one or more United States, international or foreign trademarks.

This document is written in English but may be translated into multiple languages for reference. Only the English version of this document is the final and determinative format released by Diodes Incorporated.

## LIFE SUPPORT

Diodes Incorporated products are specifically not authorized for use as critical components in life support devices or systems without the express written approval of the Chief Executive Officer of Diodes Incorporated. As used herein:
A. Life support devices or systems are devices or systems which:

1. are intended to implant into the body, or
2. support or sustain life and whose failure to perform when properly used in accordance with instructions for use provided in the labeling can be reasonably expected to result in significant injury to the user.
B. A critical component is any component in a life support device or system whose failure to perform can be reasonably expected to cause the failure of the life support device or to affect its safety or effectiveness.

Customers represent that they have all necessary expertise in the safety and regulatory ramifications of their life support devices or systems, and acknowledge and agree that they are solely responsible for all legal, regulatory and safety-related requirements concerning their products and any use of Diodes Incorporated products in such safety-critical, life support devices or systems, notwithstanding any devices- or systems-related information or support that may be provided by Diodes Incorporated. Further, Customers must fully indemnify Diodes Incorporated and its representatives against any damages arising out of the use of Diodes Incorporated products in such safety-critical, life support devices or systems.

Copyright © 2016, Diodes Incorporated
www.diodes.com
