dioderobot/arduino/components/MT53E512M32D1ZW-046_WT_B/MT53E512M32D1ZW-046_WT_B.md

# LPDDR4X/LPDDR4 SDRAM 

## MT53E512M32D1, MT53E1G32D2, MT53E512M64D2

## Features

This data sheet is for LPDDR4X and LPDDR4 unified product based on LPDDR4X information. As for LPDDR4 setting, refer to General LPDDR4 Specification at the end of this data sheet.

- Ultra-low-voltage core and I/O power supplies
$-\mathrm{V}_{\mathrm{DD} 1}=1.70-1.95 \mathrm{~V} ; 1.80 \mathrm{~V}$ nominal
$-\mathrm{V}_{\mathrm{DD} 2}=1.06-1.17 \mathrm{~V} ; 1.10 \mathrm{~V}$ nominal
$-\mathrm{V}_{\mathrm{DDQ}}=0.57-0.65 \mathrm{~V} ; 0.60 \mathrm{~V}$ nominal or $\mathrm{V}_{\mathrm{DDQ}}=1.06-1.17 \mathrm{~V} ; 1.10 \mathrm{~V}$ nominal
- Frequency range
- 2133-10 MHz (data rate range per pin: 4266-20 $\mathrm{Mb} / \mathrm{s}$ )
- 16n prefetch DDR architecture
- 8 internal banks per channel for concurrent operation
- Single-data-rate CMD/ADR entry
- Bidirectional/differential data strobe per byte lane
- Programmable READ and WRITE latencies (RL/WL)
- Programmable and on-the-fly burst lengths ( $\mathrm{BL}=16$, 32)
- Directed per-bank refresh for concurrent bank operation and ease of command scheduling
- Up to $8.5 \mathrm{~GB} / \mathrm{s}$ per die x16 channel
- On-chip temperature sensor to control self refresh rate
- Partial-array self refresh (PASR)
- Selectable output drive strength (DS)
- Clock-stop capability
- RoHS-compliant, "green" packaging
- Programmable $\mathrm{V}_{\mathrm{SS}}$ (ODT) termination
- Single-ended CK and DQS support

## Options

- $\mathrm{V}_{\mathrm{DD} 1} / \mathrm{V}_{\mathrm{DD} 2} / \mathrm{V}_{\mathrm{DDQ}}: 1.80 \mathrm{~V} / 1.10 \mathrm{~V} / 0.60 \mathrm{~V}$ or 1.10 V
- Array configuration
- 512 Meg x 32 (2 channels x 16 I/O) 512M32
- 1 Gig x 32 (2 channels x 16 I/O) 1G32
- 512 Meg x 64 (4 channels x 16 I/O) 512M64
- Device configuration
- 512M32 x 1 die in package D1
- 512M32 x 2 die in package D2
- FBGA "green" package
- 200-ball TFBGA ( $10 \mathrm{~mm} \times 14.5 \mathrm{~mm} \mathrm{x}$ ZW 1.05mm, Ø0.40 SMD)
- 200-ball TFBGA ( $10 \mathrm{~mm} \times 14.5 \mathrm{~mm} \mathrm{x}$ FW 1.1mm, Ø0.40 SMD)
- 376-ball WFBGA ( $14 \mathrm{~mm} \times 14 \mathrm{~mm} \mathrm{x}$ NZ 0.71mm, Ø0.24 SMD)
- 556-ball TFBGA ( $12.4 \mathrm{~mm} \times 12.4 \mathrm{~mm} \mathrm{x}$ HJ 1.1mm, Ø0.24 SMD)
- Speed grade, cycle time
- 468ps @ RL = 36/40 -046
- Operating temperature range
- $-25^{\circ} \mathrm{C}$ to $+85^{\circ} \mathrm{C} \quad$ WT
- $-40^{\circ} \mathrm{C}$ to $+95^{\circ} \mathrm{C} \quad$ IT
- Revision :B

Table 1: Key Timing Parameters

| Speed Grade | Clock Rate (MHz) | Data Rate per Pin (Mb/s) | Array <br> Configuration | WRITE Latency |  | READ Latency |  |
| :--: | :--: | :--: | :--: | :--: | :--: | :--: | :--: |
|  |  |  |  | Set A | Set B | DBI <br> Disabled | DBI <br> Enabled |
| $-046$ | 2133 | 4266 | 512 Meg x 32 | 18 | 34 | 36 | 40 |
| $-046$ | 2133 | 4266 | $1 G \times 32$ | 18 | 34 | 36 | 40 |
| $-046$ | 2133 | 4266 | 512 Meg x 64 | 18 | 34 | 36 | 40 |# Part Number Ordering Information 

Figure 1: Part Number Chart


Table 2: Part Number List

| Part Number | Total Density | Data Rate per Pin |
| :--: | :--: | :--: |
| MT53E512M32D1ZW-046 WT:B | 2GB (16Gb) | $4266 \mathrm{Mb} / \mathrm{s}$ |
| MT53E512M32D1ZW-046 IT:B | 2GB (16Gb) | $4266 \mathrm{Mb} / \mathrm{s}$ |
| MT53E1G32D2FW-046 WT:B | 4GB (32Gb) | $4266 \mathrm{Mb} / \mathrm{s}$ |
| MT53E512M64D2NZ-046 WT:B | 4GB (32Gb) | $4266 \mathrm{Mb} / \mathrm{s}$ |
| MT53E512M64D2HJ-046 WT:B | 4GB (32Gb) | $4266 \mathrm{Mb} / \mathrm{s}$ |

## FBGA Part Marking Decoder

Due to space limitations, FBGA-packaged components have an abbreviated part marking that is different from the part number. Micron's FBGA part marking decoder is available at www.micron.com/decoder.# Micron 

## Contents

Part Number Ordering Information ..... 2
FBGA Part Marking Decoder ..... 2
Important Notes and Warnings ..... 16
Product Specification ..... 17
General Description ..... 17
General Notes ..... 17
Device Configuration ..... 18
Refresh Requirement Parameters ..... 19
Package Block Diagrams ..... 20
Ball Assignments and Descriptions ..... 23
Ball Descriptions and Assignments ..... 26
Package Dimensions ..... 29
Package Dimensions ..... 31
Package Dimensions ..... 32
Product Specific Mode Register Definition ..... 33
$\mathrm{I}_{\mathrm{DD}}$ Parameters ..... 34
$\mathrm{I}_{\mathrm{DD}}$ Parameters ..... 36
General LPDDR4X Specification ..... 38
Functional Description ..... 38
SDRAM Addressing ..... 39
Simplified Bus Interface State Diagram ..... 42
Power-Up and Initialization ..... 43
Voltage Ramp ..... 44
Reset Initialization with Stable Power ..... 46
Power-Off Sequence ..... 46
Controlled Power-Off ..... 46
Uncontrolled Power-Off ..... 47
Mode Registers ..... 48
Mode Register Assignments and Definitions ..... 48
Commands and Timing ..... 74
Truth Tables ..... 74
ACTIVATE Command ..... 77
Read and Write Access Modes ..... 78
Preamble and Postamble ..... 78
Burst READ Operation ..... 82
Read Timing ..... 84
${ }^{1} \mathrm{LZ}(\mathrm{DQS}),{ }^{1} \mathrm{LZ}(\mathrm{DQ}),{ }^{1} \mathrm{HZ}(\mathrm{DQS}),{ }^{1} \mathrm{HZ}(\mathrm{DQ})$ Calculation ..... 85
${ }^{1} \mathrm{LZ}(\mathrm{DQS})$ and ${ }^{1} \mathrm{HZ}(\mathrm{DQS})$ Calculation for ATE (Automatic Test Equipment) ..... 85
${ }^{1} \mathrm{LZ}(\mathrm{DQ})$ and ${ }^{1} \mathrm{HZ}(\mathrm{DQ})$ Calculation for ATE (Automatic Test Equipment) ..... 87
Burst WRITE Operation ..... 88
Write Timing ..... 90
${ }^{1}$ WPRE Calculation for ATE (Automatic Test Equipment) ..... 91
${ }^{1}$ WPST Calculation for ATE (Automatic Test Equipment) ..... 92
MASK WRITE Operation ..... 92
Mask Write Timing Constraints for BL16 ..... 94
Data Mask and Data Bus Inversion (DBI [DC]) Function ..... 96
WRITE and MASKED WRITE Operation DQS Control (WDQS Control) ..... 100
WDQS Control Mode 1 - Read-Based Control ..... 100
WDQS Control Mode 2 - WDQS_On/Off ..... 100
Preamble and Postamble Behavior ..... 104
Preamble, Postamble Behavior in READ-to-READ Operations ..... 104READ-to-READ Operations - Seamless ..... 104
READ-to-READ Operations - Consecutive ..... 105
WRITE-to-WRITE Operations - Seamless ..... 111
WRITE-to-WRITE Operations - Consecutive ..... 113
PRECHARGE Operation ..... 117
Burst READ Operation Followed by Precharge ..... 117
Burst WRITE Followed by Precharge ..... 118
Auto Precharge ..... 119
Burst READ With Auto Precharge ..... 119
Burst WRITE With Auto Precharge ..... 120
RAS Lock Function ..... 124
Delay Time From WRITE-to-READ with Auto Precharge ..... 125
REFRESH Command ..... 125
Burst READ Operation Followed by Per-Bank Refresh ..... 131
Refresh Requirement ..... 132
Refresh Management Command ..... 133
Refresh Management Command Definition ..... 133
Refresh Management Operation Examples ..... 135
SELF REFRESH Operation ..... 135
Self Refresh Entry and Exit ..... 135
Power-Down Entry and Exit During Self Refresh ..... 136
Command Input Timing After Power-Down Exit ..... 137
Self Refresh Abort ..... 138
MRR, MRW, MPC Commands During ${ }^{1} \mathrm{XSR},{ }^{1} \mathrm{RFC}$ ..... 138
Power-Down Mode ..... 140
Power-Down Entry and Exit ..... 140
Input Clock Stop and Frequency Change ..... 147
Clock Frequency Change - CKE LOW ..... 147
Clock Stop - CKE LOW ..... 147
Clock Frequency Change - CKE HIGH ..... 147
Clock Stop - CKE HIGH ..... 147
MODE REGISTER READ Operation ..... 149
MRR After a READ and WRITE Command ..... 150
MRR After Power-Down Exit ..... 152
MODE REGISTER WRITE ..... 153
Mode Register Write States ..... 154
$\mathrm{V}_{\text {REF }}$ Current Generator (VRCG) ..... 155
$\mathrm{V}_{\text {REF }}$ Training ..... 156
$\mathrm{V}_{\text {REF(CA) }}$ Training ..... 156
$\mathrm{V}_{\text {REF(DQ) }}$ Training ..... 162
Command Bus Training ..... 167
Command Bus Training Mode ..... 167
Training Sequence for Single-Rank Systems ..... 168
Training Sequence for Multiple-Rank Systems ..... 168
Relation Between CA Input Pin and DQ Output Pin ..... 170
Write Leveling ..... 174
Mode Register Write-WR Leveling Mode ..... 174
Write Leveling Procedure ..... 174
Input Clock Frequency Stop and Change ..... 175
MULTIPURPOSE Operation ..... 178
Read DQ Calibration Training ..... 182
Read DQ Calibration Training Procedure ..... 182
Read DQ Calibration Training Example ..... 184MPC|READ DQ CALIBRATION] After Power-Down Exit ..... 185
Write Training ..... 185
Internal Interval Timer ..... 190
DQS Interval Oscillator Matching Error ..... 191
OSC Count Readout Time ..... 193
Thermal Offset ..... 194
Temperature Sensor ..... 194
ZQ Calibration ..... 195
ZQCAL Reset ..... 196
Multichannel Considerations ..... 196
ZQ External Resistor, Tolerance, and Capacitive Loading ..... 197
Frequency Set Points ..... 198
Frequency Set Point Update Timing ..... 199
Pull-Up and Pull-Down Characteristics and Calibration ..... 202
On-Die Termination for the Command/Address Bus ..... 203
ODT Mode Register and ODT State Table ..... 203
ODT Mode Register and ODT Characteristics ..... 204
ODT for CA Update Time ..... 205
DQ On-Die Termination ..... 206
Output Driver and Termination Register Temperature and Voltage Sensitivity ..... 207
ODT Mode Register ..... 208
Asynchronous ODT ..... 208
DQ ODT During Power-Down and Self Refresh Modes ..... 210
ODT During Write Leveling Mode ..... 210
Target Row Refresh Mode ..... 210
TRR Mode Operation ..... 210
Post-Package Repair ..... 212
Failed Row Address Repair ..... 212
Read Preamble Training ..... 214
Electrical Specifications ..... 215
Absolute Maximum Ratings ..... 215
AC and DC Operating Conditions ..... 215
AC and DC Input Measurement Levels ..... 217
Input Levels for CKE ..... 217
Input Levels for RESET_n ..... 217
Differential Input Voltage for CK ..... 217
Peak Voltage Calculation Method ..... 218
Single-Ended Input Voltage for Clock ..... 219
Differential Input Slew Rate Definition for Clock ..... 220
Differential Input Cross-Point Voltage ..... 221
Differential Input Voltage for DQS ..... 222
Peak Voltage Calculation Method ..... 222
Single-Ended Input Voltage for DQS ..... 223
Differential Input Slew Rate Definition for DQS ..... 224
Differential Input Cross-Point Voltage ..... 225
Input Levels for ODT_CA ..... 225
Output Slew Rate and Overshoot/Undershoot Specifications ..... 226
Single-Ended Output Slew Rate ..... 226
Differential Output Slew Rate ..... 226
Overshoot and Undershoot Specifications ..... 227
Driver Output Timing Reference Load ..... 228
LVSTL I/O System ..... 228
Input/Output Capacitance ..... 230$\mathrm{I}_{\mathrm{DD}}$ Specification Parameters and Test Conditions ..... 230
$\mathrm{I}_{\mathrm{DD}}$ Specifications ..... 247
AC Timing ..... 249
CA Rx Voltage and Timing ..... 257
DQ Tx Voltage and Timing ..... 261
DRAM Data Timing ..... 261
DQ Rx Voltage and Timing ..... 262
Clock Specification ..... 265
${ }^{1} \mathrm{CK}(\mathrm{abs}),{ }^{1} \mathrm{CH}(\mathrm{abs})$, and ${ }^{1} \mathrm{CL}(\mathrm{abs})$ ..... 266
Clock Period Jitter ..... 266
Clock Period Jitter Effects on Core Timing Parameters ..... 266
Cycle Time Derating for Core Timing Parameters ..... 267
Clock Cycle Derating for Core Timing Parameters ..... 267
Clock Jitter Effects on Command/Address Timing Parameters ..... 267
Clock Jitter Effects on READ Timing Parameters ..... 267
Clock Jitter Effects on WRITE Timing Parameters ..... 268
LPDDR4 $1.10 \mathrm{~V} \mathrm{~V}_{\mathrm{DDQ}}$ ..... 269
Power-Up and Initialization - LPDDR4 ..... 269
Mode Register Definition - LPDDR4 ..... 270
Burst READ Operation - LPDDR4 ATE Condition ..... 277
${ }^{1} \mathrm{LZ}(\mathrm{DQS}),{ }^{1} \mathrm{LZ}(\mathrm{DQ}),{ }^{1} \mathrm{HZ}(\mathrm{DQS}),{ }^{1} \mathrm{HZ}(\mathrm{DQ})$ Calculation ..... 277
${ }^{1} \mathrm{LZ}(\mathrm{DQS})$ and ${ }^{1} \mathrm{HZ}(\mathrm{DQS})$ Calculation for ATE (Automatic Test Equipment) ..... 277
${ }^{1} \mathrm{LZ}(\mathrm{DQ})$ and ${ }^{1} \mathrm{HZ}(\mathrm{DQ})$ Calculation for ATE (Automatic Test Equipment) ..... 279
$\mathrm{V}_{\text {REF }}$ Specifications - LPDDR4 ..... 281
Internal $\mathrm{V}_{\text {REF(CA) }}$ Specifications ..... 281
Internal $\mathrm{V}_{\text {REF(DQ) }}$ Specifications ..... 282
Command Definitions and Timing Diagrams - LPDDR4 ..... 284
Pull Up/Pull Down Driver Characteristics and Calibration ..... 284
On-Die Termination for the Command/Address Bus ..... 284
ODT Mode Register and ODT State Table ..... 285
ODT Mode Register and ODT Characteristics ..... 286
DQ On-Die Termination ..... 287
Output Driver and Termination Register Temperature and Voltage Sensitivity ..... 290
AC and DC Operating Conditions - LPDDR4 ..... 290
Recommended DC Operating Conditions ..... 290
Output Slew Rate and Overshoot/Undershoot specifications - LPDDR4 ..... 291
Single-Ended Output Slew Rate ..... 291
Differential Output Slew Rate ..... 292
LVSTL I/O System - LPDDR4 ..... 292
Product Specific Mode Register definition ..... 294
Revision History ..... 295
Rev. G - 05/2022 ..... 295
Rev. F - 04/2022 ..... 295
Rev. E - 02/2022 ..... 295
Rev. D - 11/2021 ..... 295
Rev. C - 09/2021 ..... 295
Rev. B - 05/2021 ..... 295
Rev. A - 04/2021 ..... 295# LPDDR4X/LPDDR4 SDRAM 

## List of Figures

Figure 1: Part Number Chart ..... 2
Figure 2: Single-Die, Dual-Channel Package Block Diagram ..... 20
Figure 3: Dual-Die, Dual-Channel Package Block Diagram ..... 21
Figure 4: Dual-Die, Quad-Channel Package Block Diagram ..... 22
Figure 5: 200-Ball Dual-Channel, Single-Rank Discrete FBGA ..... 23
Figure 6: 200-Ball Dual-Channel, Dual-Rank Discrete FBGA ..... 24
Figure 7: 376-Ball Quad-Channel, Single-Rank POP FBGA ..... 27
Figure 8: 556-Ball Quad-Channel, Single-Rank POP FBGA ..... 28
Figure 9: 200-Ball TFBGA - $10 \mathrm{~mm} \times 14.5 \mathrm{~mm} \times 1.05 \mathrm{~mm}$ (Package Code: ZW) ..... 29
Figure 10: 200-Ball TFBGA - $10 \mathrm{~mm} \times 14.5 \mathrm{~mm} \times 1.1 \mathrm{~mm}$ (Package Code: FW) ..... 30
Figure 11: 376-Ball WFBGA - $14.0 \mathrm{~mm} \times 14.0 \mathrm{~mm} \times 0.71 \mathrm{~mm}$ (Package Code: NZ) ..... 31
Figure 12: 556-Ball TFBGA - $12.4 \mathrm{~mm} \times 12.4 \mathrm{~mm} \times 1.1 \mathrm{~mm}$ (Package Code: HJ) ..... 32
Figure 13: Simplified State Diagram ..... 42
Figure 14: Simplified State Diagram ..... 43
Figure 15: Voltage Ramp and Initialization Sequence ..... 45
Figure 16: ACTIVATE Command ..... 77
Figure 17: ${ }^{1}$ FAW Timing ..... 78
Figure 18: DQS Read Preamble and Postamble - Toggling Preamble and $0.5 n$ CK Postamble ..... 79
Figure 19: DQS Read Preamble and Postamble - Static Preamble and $1.5 n$ CK Postamble ..... 79
Figure 20: DQS Write Preamble and Postamble $-0.5 n$ CK Postamble ..... 80
Figure 21: DQS Write Preamble and Postamble $-1.5 n$ CK Postamble ..... 81
Figure 22: Burst Read Timing ..... 82
Figure 23: Burst Read Followed by Burst Write or Burst Mask Write ..... 83
Figure 24: Seamless Burst Read ..... 83
Figure 25: Read Timing ..... 84
Figure 26: ${ }^{1}$ LZ(DQS) Method for Calculating Transitions and Endpoint ..... 85
Figure 27: ${ }^{1} \mathrm{HZ}(\mathrm{DQS})$ Method for Calculating Transitions and Endpoint ..... 86
Figure 28: ${ }^{1} \mathrm{LZ}(\mathrm{DQ})$ Method for Calculating Transitions and Endpoint ..... 87
Figure 29: ${ }^{1} \mathrm{HZ}(\mathrm{DQ})$ Method for Calculating Transitions and Endpoint ..... 87
Figure 30: Burst WRITE Operation ..... 89
Figure 31: Burst Write Followed by Burst Read ..... 89
Figure 32: Write Timing ..... 90
Figure 33: Method for Calculating ${ }^{1}$ WPRE Transitions and Endpoints ..... 91
Figure 34: Method for Calculating ${ }^{1}$ WPST Transitions and Endpoints ..... 92
Figure 35: MASK WRITE Command - Same Bank ..... 93
Figure 36: MASK WRITE Command - Different Bank ..... 93
Figure 37: MASKED WRITE Command with Write DBI Enabled; DM Enabled. ..... 98
Figure 38: WRITE Command with Write DBI Enabled; DM Disabled ..... 99
Figure 39: WDQS Control Mode 1 ..... 100
Figure 40: Burst WRITE Operation ..... 102
Figure 41: Burst READ Followed by Burst WRITE or Burst MASKED WRITE (ODT Disable) ..... 103
Figure 42: Burst READ Followed by Burst WRITE or Burst MASKED WRITE (ODT Enable) ..... 103
Figure 43: READ Operations: ${ }^{1} \mathrm{CCD}=$ MIN, Preamble $=$ Toggle, $1.5 n$ CK Postamble ..... 104
Figure 44: Seamless READ: ${ }^{1} \mathrm{CCD}=$ MIN +1 , Preamble $=$ Toggle, $1.5 n$ CK Postamble ..... 105
Figure 45: Consecutive READ: ${ }^{1} \mathrm{CCD}=$ MIN +1 , Preamble $=$ Toggle, $0.5 n$ CK Postamble ..... 105
Figure 46: Consecutive READ: ${ }^{1} \mathrm{CCD}=$ MIN +1 , Preamble $=$ Static, $1.5 n$ CK Postamble ..... 106
Figure 47: Consecutive READ: ${ }^{1} \mathrm{CCD}=$ MIN +1 , Preamble $=$ Static, $0.5 n$ CK Postamble ..... 106
Figure 48: Consecutive READ: ${ }^{1} \mathrm{CCD}=$ MIN +2 , Preamble $=$ Toggle, $1.5 n$ CK Postamble ..... 107
Figure 49: Consecutive READ: ${ }^{1} \mathrm{CCD}=$ MIN +2 , Preamble $=$ Toggle, $0.5 n$ CK Postamble ..... 107
Figure 50: Consecutive READ: ${ }^{1} \mathrm{CCD}=$ MIN +2 , Preamble $=$ Static, $1.5 n$ CK Postamble ..... 108
Figure 51: Consecutive READ: ${ }^{1} \mathrm{CCD}=$ MIN +2 , Preamble $=$ Static, $0.5 n$ CK Postamble ..... 108Figure 52: Consecutive READ: ${ }^{1} \mathrm{CCD}=\mathrm{MIN}+3$, Preamble $=$ Toggle, $1.5 n \mathrm{CK}$ Postamble ..... 109
Figure 53: Consecutive READ: ${ }^{1} \mathrm{CCD}=\mathrm{MIN}+3$, Preamble $=$ Toggle, $0.5 n \mathrm{CK}$ Postamble ..... 109
Figure 54: Consecutive READ: ${ }^{1} \mathrm{CCD}=\mathrm{MIN}+3$, Preamble $=$ Static, $1.5 n \mathrm{CK}$ Postamble ..... 110
Figure 55: Consecutive READ: ${ }^{1} \mathrm{CCD}=\mathrm{MIN}+3$, Preamble $=$ Static, $0.5 n \mathrm{CK}$ Postamble ..... 110
Figure 56: Seamless WRITE: ${ }^{1} \mathrm{CCD}=\mathrm{MIN}, 0.5 n \mathrm{CK}$ Postamble. ..... 111
Figure 57: Seamless WRITE: ${ }^{1} \mathrm{CCD}=\mathrm{MIN}, 1.5 n \mathrm{CK}$ Postamble, 533 MHz < Clock Frequency <= 800 MHz , ODT Worst Timing Case ..... 112
Figure 58: Seamless WRITE: ${ }^{1} \mathrm{CCD}=\mathrm{MIN}, 1.5 n \mathrm{CK}$ Postamble ..... 112
Figure 59: Consecutive WRITE: ${ }^{1} \mathrm{CCD}=\mathrm{MIN}+1,0.5 n \mathrm{CK}$ Postamble ..... 113
Figure 60: Consecutive WRITE: ${ }^{1} \mathrm{CCD}=\mathrm{MIN}+1,1.5 n \mathrm{CK}$ Postamble ..... 113
Figure 61: Consecutive WRITE: ${ }^{1} \mathrm{CCD}=\mathrm{MIN}+2,0.5 n \mathrm{CK}$ Postamble ..... 114
Figure 62: Consecutive WRITE: ${ }^{1} \mathrm{CCD}=\mathrm{MIN}+2,1.5 n \mathrm{CK}$ Postamble ..... 114
Figure 63: Consecutive WRITE: ${ }^{1} \mathrm{CCD}=\mathrm{MIN}+3,0.5 n \mathrm{CK}$ Postamble ..... 115
Figure 64: Consecutive WRITE: ${ }^{1} \mathrm{CCD}=\mathrm{MIN}+3,1.5 n \mathrm{CK}$ Postamble ..... 115
Figure 65: Consecutive WRITE: ${ }^{1} \mathrm{CCD}=\mathrm{MIN}+4,1.5 n \mathrm{CK}$ Postamble ..... 116
Figure 66: Burst READ Followed by Precharge - BL16, Toggling Preamble, $0.5 n \mathrm{CK}$ Postamble ..... 118
Figure 67: Burst READ Followed by Precharge - BL32, $2^{1} \mathrm{CK}, 0.5 n \mathrm{CK}$ Postamble ..... 118
Figure 68: Burst WRITE Followed by PRECHARGE - BL16, $2 n$ CK Preamble, $0.5 n$ CK Postamble ..... 119
Figure 69: Burst READ With Auto Precharge - BL16, Non-Toggling Preamble, $0.5 n \mathrm{CK}$ Postamble ..... 120
Figure 70: Burst READ With Auto Precharge - BL32, Toggling Preamble, $1.5 n$ CK Postamble ..... 120
Figure 71: Burst WRITE With Auto Precharge - BL16, $2 n$ CK Preamble, $0.5 n$ CK Postamble ..... 121
Figure 72: Command Input Timing with RAS Lock ..... 124
Figure 73: Delay Time From WRITE-to-READ with Auto Precharge ..... 125
Figure 74: All-Bank REFRESH Operation ..... 128
Figure 75: Per-Bank REFRESH Operation ..... 128
Figure 76: Postponing REFRESH Commands (Example) ..... 130
Figure 77: Pulling in REFRESH Commands (Example) ..... 130
Figure 78: Burst READ Operation Followed by Per-Bank Refresh ..... 131
Figure 79: Burst READ With AUTO PRECHARGE Operation Followed by Per-Bank Refresh ..... 132
Figure 80: Self Refresh Entry/Exit Timing ..... 136
Figure 81: Self Refresh Entry/Exit Timing with Power-Down Entry/Exit ..... 137
Figure 82: Command Input Timings after Power-Down Exit During Self Refresh ..... 137
Figure 83: MRR, MRW, and MPC Commands Issuing Timing During ${ }^{1} \mathrm{XSR}$. ..... 138
Figure 84: MRR, MRW, and MPC Commands Issuing Timing During ${ }^{1} \mathrm{RFC}$ ..... 139
Figure 85: Basic Power-Down Entry and Exit Timing ..... 141
Figure 86: Read and Read with Auto Precharge to Power-Down Entry. ..... 141
Figure 87: Write and Mask Write to Power-Down Entry. ..... 142
Figure 88: Write With Auto Precharge and Mask Write With Auto Precharge to Power-Down Entry. ..... 143
Figure 89: Refresh Entry to Power-Down Entry ..... 143
Figure 90: ACTIVATE Command to Power-Down Entry. ..... 144
Figure 91: PRECHARGE Command to Power-Down Entry ..... 144
Figure 92: Mode Register Read to Power-Down Entry ..... 145
Figure 93: Mode Register Write to Power-Down Entry. ..... 146
Figure 94: MULTI PURPOSE Command for ZQCAL Start to Power-Down Entry ..... 146
Figure 95: MODE REGISTER READ Operation ..... 150
Figure 96: READ-to-MRR Timing. ..... 151
Figure 97: WRITE-to-MRR Timing. ..... 152
Figure 98: MRR Following Power-Down ..... 153
Figure 99: MODE REGISTER WRITE Timing. ..... 153
Figure 100: VRCG Enable Timing. ..... 156
Figure 101: VRCG Disable Timing ..... 156
Figure 102: $\mathrm{V}_{\text {REF }}$ Operating Range $\left(\mathrm{V}_{\text {REF,max }} \mathrm{V}_{\text {REF,min }}\right)$ ..... 157
Figure 103: $\mathrm{V}_{\text {REF }}$ Set-Point Tolerance and Step Size ..... 158Figure 104: ${ }^{\mathrm{t}} \mathrm{V}_{\text {ref }}$ for Short, Middle, and Long Timing Diagram ..... 159
Figure 105: $\mathrm{V}_{\text {REF(CA) }}$ Single-Step Increment ..... 159
Figure 106: $\mathrm{V}_{\text {REF(CA) }}$ Single-Step Decrement. ..... 160
Figure 107: $\mathrm{V}_{\text {REF(CA) }}$ Full Step from $\mathrm{V}_{\text {REF,min }}$ to $\mathrm{V}_{\text {REF,max }}$ ..... 160
Figure 108: $\mathrm{V}_{\text {REF(CA) }}$ Full Step from $\mathrm{V}_{\text {REF,max }}$ to $\mathrm{V}_{\text {REF,min }}$ ..... 160
Figure 109: $\mathrm{V}_{\text {REF }}$ Operating Range $\left(\mathrm{V}_{\text {REF,max }} \mathrm{V}_{\text {REF,min }}\right)$ ..... 162
Figure 110: $\mathrm{V}_{\text {REF }}$ Set Tolerance and Step Size ..... 163
Figure 111: $\mathrm{V}_{\text {REF(DQ) }}$ Transition Time for Short, Middle, or Long Changes ..... 164
Figure 112: $\mathrm{V}_{\text {REF(DQ) }}$ Single-Step Size Increment ..... 164
Figure 113: $\mathrm{V}_{\text {REF(DQ) }}$ Single-Step Size Decrement ..... 165
Figure 114: $\mathrm{V}_{\text {REF(DQ) }}$ Full Step from $\mathrm{V}_{\text {REF,min }}$ to $\mathrm{V}_{\text {REF,max }}$ ..... 165
Figure 115: $\mathrm{V}_{\text {REF(DQ) }}$ Full Step from $\mathrm{V}_{\text {REF,max }}$ to $\mathrm{V}_{\text {REF,min }}$ ..... 165
Figure 116: Command Bus Training Mode Entry - CA Training Pattern I/O with $\mathrm{V}_{\text {REF(CA) }}$ Value Update ..... 170
Figure 117: Consecutive $\mathrm{V}_{\text {REF(CA) }}$ Value Update ..... 171
Figure 118: Command Bus Training Mode Exit with Valid Command ..... 172
Figure 119: Command Bus Training Mode Exit with Power-Down Entry ..... 173
Figure 120: Write Leveling Timing - ${ }^{\mathrm{t}}$ DQSL(MAX) ..... 175
Figure 121: Write Leveling Timing - ${ }^{\mathrm{t}}$ DQSL(MIN) ..... 175
Figure 122: Clock Stop and Timing During Write Leveling ..... 176
Figure 123: DQS_t/DQS_c to CK_t/CK_c Timings at the Pins Referenced from the Internal Latch ..... 177
Figure 124: WRITE-FIFO - ${ }^{\mathrm{t}}$ WPRE $=2 n \mathrm{CK},{ }^{\mathrm{t}}$ WPST $=0.5 n \mathrm{CK}$ ..... 179
Figure 125: READ-FIFO - ${ }^{\mathrm{t}}$ WPRE $=2 n \mathrm{CK},{ }^{\mathrm{t}}$ WPST $=0.5 n \mathrm{CK},{ }^{\mathrm{t}}$ RPRE $=$ Toggling, ${ }^{\mathrm{t}}$ RPST $=1.5 n \mathrm{CK}$ ..... 180
Figure 126: READ-FIFO - ${ }^{\mathrm{t}}$ RPRE $=$ Toggling, ${ }^{\mathrm{t}}$ RPST $=1.5 n \mathrm{CK}$ ..... 180
Figure 127: Read DQ Calibration Training Timing: Read-to-Read DQ Calibration ..... 183
Figure 128: Read DQ Calibration Training Timing: Read DQ Calibration to Read DQ Calibration/Read. ..... 183
Figure 129: MPC[READ DQ CALIBRATION] Following Power-Down State ..... 185
Figure 130: WRITE-to-MPC[WRITE-FIFO] Operation Timing ..... 187
Figure 131: MPC[WRITE-FIFO]-to-MPC[READ-FIFO] Timing ..... 187
Figure 132: MPC[READ-FIFO] to Read Timing ..... 188
Figure 133: MPC[WRITE-FIFO] with DQ ODT Timing ..... 189
Figure 134: Power-Down Exit to MPC[WRITE-FIFO] Timing ..... 190
Figure 135: Interval Oscillator Offset - OSC $_{\text {offset }}$ ..... 192
Figure 136: In Case of DQS Interval Oscillator is Stopped by MPC Command ..... 193
Figure 137: In Case of DQS Interval Oscillator is Stopped by DQS Interval Timer ..... 193
Figure 138: Temperature Sensor Timing ..... 195
Figure 139: ZQCAL Timing ..... 196
Figure 140: Frequency Set Point Switching Timing ..... 199
Figure 141: Training for Two Frequency Set Points. ..... 201
Figure 142: Example of Switching Between Two Trained Frequency Set Points. ..... 201
Figure 143: Example of Switching to a Third Trained Frequency Set Point ..... 202
Figure 144: ODT for CA ..... 203
Figure 145: ODT for CA Setting Update Timing in 4-Clock Cycle Command ..... 205
Figure 146: Functional Representation of DQ ODT. ..... 206
Figure 147: Asynchronous ODTon/ODToff Timing. ..... 209
Figure 148: Target Row Refresh Mode ..... 211
Figure 149: Post-Package Repair Timing ..... 213
Figure 150: Read Preamble Training ..... 214
Figure 151: Input Timing Definition for CKE ..... 217
Figure 152: Input Timing Definition for RESET_n ..... 217
Figure 153: CK Differential Input Voltage ..... 218
Figure 154: Definition of Differential Clock Peak Voltage ..... 219
Figure 155: Clock Single-Ended Input Voltage ..... 219
Figure 156: Differential Input Slew Rate Definition for CK_t, CK_c. ..... 220Figure 157: $\mathrm{V}_{\mathrm{le}}$ Definition (Clock) ..... 221
Figure 158: DQS Differential Input Voltage ..... 222
Figure 159: Definition of Differential DQS Peak Voltage ..... 223
Figure 160: DQS Single-Ended Input Voltage ..... 223
Figure 161: Differential Input Slew Rate Definition for DQS_t, DQS_c ..... 224
Figure 162: $\mathrm{V}_{\text {le }}$ Definition (DQS) ..... 225
Figure 163: Single-Ended Output Slew Rate Definition ..... 226
Figure 164: Differential Output Slew Rate Definition ..... 227
Figure 165: Overshoot and Undershoot Definition ..... 228
Figure 166: Driver Output Timing Reference Load ..... 228
Figure 167: LVSTL I/O Cell ..... 229
Figure 168: Pull-Up Calibration ..... 229
Figure 169: ${ }^{t}$ CMDCKE Timing ..... 253
Figure 170: ${ }^{t}$ ESCKE Timing ..... 255
Figure 171: CA Receiver (Rx) Mask ..... 257
Figure 172: Across Pin $\mathrm{V}_{\text {REF (CA) }}$ Voltage Variation ..... 258
Figure 173: CA Timings at the DRAM Pins ..... 258
Figure 174: CA ${ }^{\text {t }} \mathrm{clPW}$ and SRIN_cIVW Definition (for Each Input Pulse) ..... 259
Figure 175: CA $\mathrm{V}_{\mathrm{IHL}_{-} \mathrm{AC}}$ Definition (for Each Input Pulse) ..... 259
Figure 176: Read Data Timing Definitions - ${ }^{\mathrm{t}} \mathrm{QH}$ and ${ }^{\mathrm{t}} \mathrm{DQSQ}$ Across DQ Signals per DQS Group ..... 261
Figure 177: DQ Receiver (Rx) Mask ..... 262
Figure 178: Across Pin $\mathrm{V}_{\text {REF }}$ DQ Voltage Variation ..... 262
Figure 179: DQ-to-DQS ${ }^{\mathrm{t}} \mathrm{DQS} 2 \mathrm{DQ}$ and ${ }^{\mathrm{t}} \mathrm{DQDQ}$ ..... 263
Figure 180: DQ ${ }^{\mathrm{t}} \mathrm{DIPW}$ and SRIN_dIVW Definition for Each Input Pulse ..... 264
Figure 181: DQ $\mathrm{V}_{\mathrm{IHL}(\mathrm{AC})}$ Definition (for Each Input Pulse) ..... 264
Figure 182: ${ }^{\mathrm{t}} \mathrm{LZ}(\mathrm{DQS})$ Method for Calculating Transitions and Endpoint ..... 277
Figure 183: ${ }^{\mathrm{t}} \mathrm{HZ}(\mathrm{DQS})$ Method for Calculating Transitions and Endpoint ..... 278
Figure 184: ${ }^{\mathrm{t}} \mathrm{LZ}(\mathrm{DQ})$ Method for Calculating Transitions and Endpoint ..... 279
Figure 185: ${ }^{\mathrm{t}} \mathrm{HZ}(\mathrm{DQ})$ Method for Calculating Transitions and Endpoint ..... 279
Figure 186: ODT for CA ..... 285
Figure 187: Functional Representation of DQ ODT ..... 288
Figure 188: Single-Ended Output Slew Rate Definition ..... 291
Figure 189: Differential Output Slew Rate Definition ..... 292
Figure 190: LVSTL I/O Cell ..... 293
Figure 191: Pull-Up Calibration ..... 293# Micron 

## List of Tables

Table 1: Key Timing Parameters ..... 1
Table 2: Part Number List ..... 2
Table 3: Device Configuration ..... 18
Table 4: Refresh Requirement Parameters ..... 19
Table 5: Ball/Pad Descriptions for x32 ..... 25
Table 6: Ball/Pad Descriptions for x64 ..... 26
Table 7: Mode Register Contents ..... 33
Table 8: LPDDR4X $\mathrm{I}_{\mathrm{DD}}$ Parameters - Single Die (16Gb Dual-Channel Die) ..... 34
Table 9: $\mathrm{I}_{\text {DD6 }}$ Full-Array Self Refresh Current - Single Die (16Gb Dual-Channel Die) ..... 35
Table 10: LPDDR4 $\mathrm{I}_{\mathrm{DD}}$ Parameters - Single Die (16Gb Dual-Channel Die) ..... 36
Table 11: $\mathrm{I}_{\text {DD6 }}$ Full-Array Self Refresh Current - Single Die (16Gb Dual-Channel Die) ..... 37
Table 12: SDRAM Addressing - Dual-Channel Die ..... 40
Table 13: SDRAM Addressing - Single-Channel Die ..... 41
Table 14: Mode Register Default Settings ..... 43
Table 15: Voltage Ramp Conditions ..... 44
Table 16: Initialization Timing Parameters ..... 46
Table 17: Reset Timing Parameter ..... 46
Table 18: Power Supply Conditions ..... 47
Table 19: Power-Off Timing ..... 47
Table 20: Mode Register Assignments ..... 48
Table 21: MR0 Device Feature 0 (MA[5:0] = 00h) ..... 49
Table 22: MR0 Op-Code Bit Definitions ..... 49
Table 23: MR1 Device Feature 1 (MA[5:0] = 01h) ..... 50
Table 24: MR1 Op-Code Bit Definitions ..... 50
Table 25: Burst Sequence for Read ..... 52
Table 26: Burst Sequence for Write ..... 53
Table 27: MR2 Device Feature 2 (MA[5:0] = 02h) ..... 54
Table 28: MR2 Op-Code Bit Definitions ..... 54
Table 29: Frequency Ranges for RL, WL, $n$ WR, and $n$ RTP Settings ..... 56
Table 30: MR3 I/O Configuration 1 (MA[5:0] = 03h) ..... 56
Table 31: MR3 Op-Code Bit Definitions ..... 57
Table 32: MR4 Device Temperature (MA[5:0] = 04h) ..... 58
Table 33: MR4 Op-Code Bit Definitions ..... 58
Table 34: MR5 Basic Configuration 1 (MA[5:0] = 05h) ..... 59
Table 35: MR5 Op-Code Bit Definitions ..... 59
Table 36: MR6 Basic Configuration 2 (MA[5:0] = 06h) ..... 59
Table 37: MR6 Op-Code Bit Definitions ..... 59
Table 38: MR7 Basic Configuration 3 (MA[5:0] = 07h) ..... 59
Table 39: MR7 Op-Code Bit Definitions ..... 59
Table 40: MR8 Basic Configuration 4 (MA[5:0] = 08h) ..... 60
Table 41: MR8 Op-Code Bit Definitions ..... 60
Table 42: MR9 Test Mode (MA[5:0] = 09h) ..... 60
Table 43: MR9 Op-Code Definitions ..... 60
Table 44: MR10 Calibration (MA[5:0] = 0Ah) ..... 60
Table 45: MR10 Op-Code Bit Definitions ..... 60
Table 46: MR11 ODT Control (MA[5:0] = 0Bh) ..... 61
Table 47: MR11 Op-Code Bit Definitions ..... 61
Table 48: MR12 Register Information (MA[5:0] = 0Ch) ..... 61
Table 49: MR12 Op-Code Bit Definitions ..... 62
Table 50: MR13 Register Control (MA[5:0] = 0Dh) ..... 62
Table 51: MR13 Op-Code Bit Definition. ..... 63# Micron 

LPDDR4X/LPDDR4 SDRAM
Table 52: Mode Register $14(\mathrm{MA}[5: 0]=0 \mathrm{Eh})$ ..... 63
Table 53: MR14 Op-Code Bit Definition. ..... 64
Table 54: $\mathrm{V}_{\text {REF }}$ Setting for Range[0] and Range[1] ..... 65
Table 55: MR15 Register Information (MA[5:0] = 0Fh) ..... 65
Table 56: MR15 Op-code Bit Definition ..... 66
Table 57: MR15 Invert Register Pin Mapping ..... 66
Table 58: MR16 PASR Bank Mask (MA[5:0] = 010h) ..... 66
Table 59: MR16 Op-Code Bit Definitions ..... 66
Table 60: MR17 PASR Segment Mask (MA[5:0] = 11h) ..... 67
Table 61: MR17 PASR Segment Mask Definitions ..... 67
Table 62: MR17 PASR Segment Mask ..... 67
Table 63: MR18 Register Information (MA[5:0] = 12h) ..... 67
Table 64: MR18 LSB DQS Oscillator Count ..... 67
Table 65: MR19 Register Information (MA[5:0] = 13h) ..... 68
Table 66: MR19 DQS Oscillator Count ..... 68
Table 67: MR20 Register Information (MA[5:0] = 14h) ..... 68
Table 68: MR20 Register Information ..... 68
Table 69: MR20 Invert Register Pin Mapping ..... 68
Table 70: MR21 Register Information (MA[5:0] = 15h) ..... 68
Table 71: MR22 Register Information (MA[5:0] = 16h) ..... 69
Table 72: MR22 Register Information ..... 69
Table 73: MR23 Register Information (MA[5:0] = 17h) ..... 69
Table 74: MR23 Register Information ..... 70
Table 75: MR24 Register Information (MA[5:0] = 18h) when MR0 OP[2] = 0b ..... 70
Table 76: MR24 Register Information when MR0 OP[2] = 0b ..... 70
Table 77: MR24 Register Information (MA[5:0] = 18h) when MR0 OP[2] = 1b ..... 71
Table 78: MR24 Register Information when MR0 OP[2] = 1b ..... 71
Table 79: MR25 Register Information (MA[5:0] = 19h) ..... 72
Table 80: MR25 Register Information ..... 72
Table 81: MR26:29 Register Information (MA[5:0] = 1Ah-1Dh) ..... 72
Table 82: MR30 Register Information (MA[5:0] = 1Eh) ..... 72
Table 83: MR30 Register Information ..... 72
Table 84: MR31 Register Information (MA[5:0] = 1Fh) ..... 72
Table 85: MR32 Register Information (MA[5:0] = 20h) ..... 72
Table 86: MR32 Register Information ..... 73
Table 87: MR33:35 Register Information (MA[5:0] = 21h-23h) ..... 73
Table 88: MR36 Register Information (MA[5:0] = 24h) ..... 73
Table 89: MR36 Register Information ..... 73
Table 90: MR37:38 Register Information (MA[5:0] = 25h-26h) ..... 73
Table 91: MR39 Register Information (MA[5:0] = 27h) ..... 73
Table 92: MR39 Register Information ..... 74
Table 93: MR40 Register Information (MA[5:0] = 28h) ..... 74
Table 94: MR40 Register Information ..... 74
Table 95: MR41:47 Register Information (MA[5:0] = 29h-2Fh) ..... 74
Table 96: MR48:63 Register Information (MA[5:0] = 30h-3Fh) ..... 74
Table 97: Command Truth Table ..... 75
Table 98: Reference Voltage for ${ }^{1} \mathrm{LZ}(\mathrm{DQS}),{ }^{1} \mathrm{HZ}(\mathrm{DQS})$ Timing Measurements. ..... 86
Table 99: Reference Voltage for ${ }^{1} \mathrm{LZ}(\mathrm{DQ}),{ }^{1} \mathrm{HZ}(\mathrm{DQ})$ Timing Measurements ..... 88
Table 100: Method for Calculating ${ }^{1}$ WPRE Transitions and Endpoints ..... 91
Table 101: Reference Voltage for ${ }^{1}$ WPST Timing Measurements ..... 92
Table 102: Same Bank (ODT Disabled) ..... 94
Table 103: Different Bank (ODT Disabled) ..... 94
Table 104: Same Bank (ODT Enabled) ..... 95# Micron 

LPDDR4X/LPDDR4 SDRAM
Table 105: Different Bank (ODT Enabled) ..... 95
Table 106: Function Behavior of DMI Signal During WRITE, MASKED WRITE, and READ Operations ..... 96
Table 107: WDQS_On/WDQS_Off Definition ..... 101
Table 108: WDQS_On/WDQS_Off Allowable Variation Range ..... 101
Table 109: DQS Turn-Around Parameter ..... 101
Table 110: Precharge Bank Selection ..... 117
Table 111: Timing Between Commands (PRECHARGE and AUTO PRECHARGE): DQ ODT is Disable ..... 121
Table 112: Timing Between Commands (PRECHARGE and AUTO PRECHARGE): DQ ODT is Enable ..... 124
Table 113: Bank and Refresh Counter Increment Behavior. ..... 126
Table 114: REFRESH Command Timing Constraints ..... 127
Table 115: Legacy REFRESH Command Timing Constraints ..... 129
Table 116: Modified REFRESH Command Timing Constraints ..... 129
Table 117: Refresh Requirement Parameters ..... 132
Table 118: REFRESH Command With RFM ..... 133
Table 119: Refresh Management Parameters ..... 134
Table 120: RFM Operation Example (One Bank) ..... 135
Table 121: MRR ..... 149
Table 122: Truth Table for MRR and MRW ..... 154
Table 123: MRR/MRW Timing Constraints: DQ ODT is Disable ..... 154
Table 124: MRR/MRW Timing Constraints: DQ ODT is Enable ..... 155
Table 125: VRCG Enable/Disable Timing ..... 156
Table 126: Internal $\mathrm{V}_{\mathrm{REF}(\mathrm{CA})}$ Specifications ..... 161
Table 127: Internal $\mathrm{V}_{\mathrm{REF}(\mathrm{DQ})}$ Specifications ..... 166
Table 128: Mapping MR12 Op Code and DQ Numbers ..... 167
Table 129: Mapping CA Input Pin and DQ Output Pin ..... 170
Table 130: Write Leveling Timing Parameters ..... 176
Table 131: Write Leveling Setup and Hold Timing. ..... 176
Table 132: MPC Command Definition ..... 178
Table 133: MPC Commands ..... 179
Table 134: Timing Constraints for Training Commands ..... 181
Table 135: Invert Mask Assignments ..... 182
Table 136: Read DQ Calibration Bit Ordering and Inversion Example ..... 184
Table 137: MR Setting vs. DMI Status ..... 184
Table 138: MPC|WRITE-FIFO| AC Timing ..... 190
Table 139: DQS Oscillator Matching Error Specification ..... 192
Table 140: DQS Interval Oscillator AC Timing ..... 194
Table 141: Temperature Sensor ..... 195
Table 142: ZQ Calibration Parameters ..... 196
Table 143: Mode Register Function With Two Physical Registers ..... 198
Table 144: Relation Between MR Setting and DRAM Operation ..... 199
Table 145: Frequency Set Point AC Timing ..... 200
Table 146: ${ }^{1} \mathrm{FC}$ Value Mapping ..... 200
Table 147: ${ }^{1} \mathrm{FC}$ Value Mapping: Example ..... 200
Table 148: Pull-Down Driver Characteristics - ZQ Calibration. ..... 202
Table 149: Pull-Up Characteristics - ZQ Calibration ..... 202
Table 150: Valid Calibration Points ..... 202
Table 151: Command Bus ODT State ..... 203
Table 152: ODT DC Electrical Characteristics for Command/Address Bus ..... 204
Table 153: ODT DC Electrical Characteristics for DQ Bus ..... 206
Table 154: Output Driver and Termination Register Sensitivity Definition ..... 207
Table 155: Output Driver and Termination Register Temperature and Voltage Sensitivity ..... 207
Table 156: $\mathrm{ODTL}_{\mathrm{ON}}$ and $\mathrm{ODTL}_{\mathrm{OFF}}$ Latency Values ..... 209
Table 157: Termination State in Write Leveling Mode ..... 210# Micron 

## LPDDR4X/LPDDR4 SDRAM

Table 158: Post-Package Repair Timing Parameters ..... 213
Table 159: Absolute Maximum DC Ratings ..... 215
Table 160: Recommended DC Operating Conditions ..... 215
Table 161: Input Leakage Current ..... 215
Table 162: Input/Output Leakage Current ..... 216
Table 163: Operating Temperature Range ..... 216
Table 164: Input Levels ..... 217
Table 165: Input Levels ..... 217
Table 166: CK Differential Input Voltage ..... 218
Table 167: Clock Single-Ended Input Voltage ..... 219
Table 168: Differential Input Slew Rate Definition for CK_t, CK_c. ..... 220
Table 169: Differential Input Level for CK_t, CK_c. ..... 220
Table 170: Differential Input Slew Rate for CK_t, CK_c ..... 221
Table 171: Cross-Point Voltage for Differential Input Signals (Clock) ..... 221
Table 172: DQS Differential Input Voltage ..... 222
Table 173: DQS Single-Ended Input Voltage ..... 223
Table 174: Differential Input Slew Rate Definition for DQS_t, DQS_c. ..... 224
Table 175: Differential Input Level for DQS_t, DQS_c ..... 224
Table 176: Differential Input Slew Rate for DQS_t, DQS_c ..... 225
Table 177: Cross-Point Voltage for Differential Input Signals (DQS) ..... 225
Table 178: Input Levels for ODT_CA ..... 225
Table 179: Single-Ended Output Slew Rate ..... 226
Table 180: Differential Output Slew Rate ..... 226
Table 181: AC Overshoot/Undershoot Specifications ..... 227
Table 182: Overshoot/Undershoot Specification for CKE and RESET ..... 227
Table 183: Input/Output Capacitance ..... 230
Table 184: $\mathrm{I}_{\mathrm{DD}}$ Measurement Conditions ..... 230
Table 185: CA Pattern for $\mathrm{I}_{\mathrm{DD} 4 \mathrm{~B}}$ for $\mathrm{BL}=16$ ..... 231
Table 186: CA Pattern for $\mathrm{I}_{\mathrm{DD} 4 \mathrm{~W}}$ for $\mathrm{BL}=16$ ..... 232
Table 187: Data Pattern for $\mathrm{I}_{\mathrm{DD} 4 \mathrm{~W}}$ (DBI Off) for $\mathrm{BL}=16$ ..... 232
Table 188: Data Pattern for $\mathrm{I}_{\mathrm{DD} 4 \mathrm{~B}}$ (DBI Off) for $\mathrm{BL}=16$ ..... 233
Table 189: Data Pattern for $\mathrm{I}_{\mathrm{DD} 4 \mathrm{~W}}$ (DBI On) for $\mathrm{BL}=16$ ..... 234
Table 190: Data Pattern for $\mathrm{I}_{\mathrm{DD} 4 \mathrm{~B}}$ (DBI On) for $\mathrm{BL}=16$ ..... 235
Table 191: CA Pattern for $\mathrm{I}_{\mathrm{DD} 4 \mathrm{~B}}$ for $\mathrm{BL}=32$ ..... 236
Table 192: CA Pattern for $\mathrm{I}_{\mathrm{DD} 4 \mathrm{~W}}$ for $\mathrm{BL}=32$ ..... 237
Table 193: Data Pattern for $\mathrm{I}_{\mathrm{DD} 4 \mathrm{~W}}$ (DBI Off) for $\mathrm{BL}=32$ ..... 238
Table 194: Data Pattern for $\mathrm{I}_{\mathrm{DD} 4 \mathrm{~B}}$ (DBI Off) for $\mathrm{BL}=32$ ..... 240
Table 195: Data Pattern for $\mathrm{I}_{\mathrm{DD} 4 \mathrm{~W}}$ (DBI On) for $\mathrm{BL}=32$ ..... 242
Table 196: Data Pattern for $\mathrm{I}_{\mathrm{DD} 4 \mathrm{~B}}$ (DBI On) for $\mathrm{BL}=32$ ..... 244
Table 197: $\mathrm{I}_{\mathrm{DD}}$ Specification Parameters and Operating Conditions ..... 247
Table 198: Clock Timing ..... 249
Table 199: Read Output Timing ..... 249
Table 200: Write Timing ..... 251
Table 201: CKE Input Timing ..... 252
Table 202: Command Address Input Timing ..... 253
Table 203: Boot Timing Parameters ( $10-55 \mathrm{MHz}$ ) ..... 253
Table 204: Mode Register Timing Parameters ..... 254
Table 205: Core Timing Parameters ..... 254
Table 206: CA Bus ODT Timing ..... 255
Table 207: CA Bus Training Parameters ..... 256
Table 208: Asynchronous ODT Turn On and Turn Off Timing ..... 257
Table 209: Temperature Derating Parameters ..... 257
Table 210: DRAM CMD/ADR, CS ..... 260# Micron 

LPDDR4X/LPDDR4 SDRAM
Table 211: DQs In Receive Mode ..... 264
Table 212: Definitions and Calculations ..... 265
Table 213: ${ }^{4} \mathrm{CK}(\mathrm{abs}),{ }^{4} \mathrm{CH}(\mathrm{abs})$, and ${ }^{4} \mathrm{CL}(\mathrm{abs})$ Definitions ..... 266
Table 214: Mode Register Default Settings ..... 269
Table 215: Mode Register Assignments ..... 270
Table 216: MR0 Device Feature $0(\mathrm{MA}[5: 0]=00 \mathrm{~h})$ ..... 271
Table 217: MR0 Op-Code Bit Definitions ..... 271
Table 218: MR3 I/O Configuration 1 (MA[5:0] = 03h) ..... 272
Table 219: MR3 Op-Code Bit Definitions ..... 272
Table 220: MR12 Register Information (MA[5:0] = 0Ch) ..... 273
Table 221: MR12 Op-Code Bit Definitions ..... 273
Table 222: Mode Register $14(\mathrm{MA}[5: 0]=0 \mathrm{Eh})$ ..... 273
Table 223: MR14 Op-Code Bit Definition ..... 273
Table 224: $\mathrm{V}_{\text {REF }}$ Setting for Range[0] and Range[1] ..... 275
Table 225: MR22 Register Information (MA[5:0] = 16h) ..... 276
Table 226: MR22 Register Information ..... 276
Table 227: Reference Voltage for ${ }^{1} \mathrm{LZ}(\mathrm{DQS}),{ }^{1} \mathrm{HZ}(\mathrm{DQS})$ Timing Measurements ..... 278
Table 228: Reference Voltage for ${ }^{1} \mathrm{LZ}(\mathrm{DQ}),{ }^{1} \mathrm{HZ}(\mathrm{DQ})$ Timing Measurements ..... 280
Table 229: Internal $\mathrm{V}_{\text {REF(CA) }}$ Specifications ..... 281
Table 230: Internal $\mathrm{V}_{\text {REF(DQ) }}$ Specifications ..... 282
Table 231: Pull-Down Driver Characteristics - ZQ Calibration ..... 284
Table 232: Pull-Up Characteristics - ZQ Calibration ..... 284
Table 233: Terminated Valid Calibration Points ..... 284
Table 234: Command Bus ODT State ..... 285
Table 235: ODT DC Electrical Characteristics for Command/Address Bus - up to $3200 \mathrm{Mb} / \mathrm{s}$ ..... 286
Table 236: ODT DC Electrical Characteristics for Command/Address Bus - Beyond $3200 \mathrm{Mb} / \mathrm{s}$ ..... 287
Table 237: ODT DC Electrical Characteristics for DQ Bus- up to $3200 \mathrm{Mb} / \mathrm{s}$ ..... 288
Table 238: ODT DC Electrical Characteristics for DQ Bus - Beyond $3200 \mathrm{Mb} / \mathrm{s}$ ..... 289
Table 239: Output Driver and Termination Register Sensitivity Definition ..... 290
Table 240: Output Driver and Termination Register Temperature and Voltage Sensitivity ..... 290
Table 241: Recommended DC Operating Conditions ..... 290
Table 242: Single-Ended Output Slew Rate ..... 291
Table 243: Differential Output Slew Rate ..... 292
Table 244: Mode Register Contents ..... 294# Important Notes and Warnings 

Micron Technology, Inc. ("Micron") reserves the right to make changes to information published in this document, including without limitation specifications and product descriptions. This document supersedes and replaces all information supplied prior to the publication hereof. You may not rely on any information set forth in this document if you obtain the product described herein from any unauthorized distributor or other source not authorized by Micron.

Automotive Applications. Products are not designed or intended for use in automotive applications unless specifically designated by Micron as automotive-grade by their respective data sheets. Distributor and customer/distributor shall assume the sole risk and liability for and shall indemnify and hold Micron harmless against all claims, costs, damages, and expenses and reasonable attorneys' fees arising out of, directly or indirectly, any claim of product liability, personal injury, death, or property damage resulting directly or indirectly from any use of non-automotive-grade products in automotive applications. Customer/distributor shall ensure that the terms and conditions of sale between customer/distributor and any customer of distributor/customer (1) state that Micron products are not designed or intended for use in automotive applications unless specifically designated by Micron as automotive-grade by their respective data sheets and (2) require such customer of distributor/customer to indemnify and hold Micron harmless against all claims, costs, damages, and expenses and reasonable attorneys' fees arising out of, directly or indirectly, any claim of product liability, personal injury, death, or property damage resulting from any use of non-automotive-grade products in automotive applications.
Critical Applications. Products are not authorized for use in applications in which failure of the Micron component could result, directly or indirectly in death, personal injury, or severe property or environmental damage ("Critical Applications"). Customer must protect against death, personal injury, and severe property and environmental damage by incorporating safety design measures into customer's applications to ensure that failure of the Micron component will not result in such harms. Should customer or distributor purchase, use, or sell any Micron component for any critical application, customer and distributor shall indemnify and hold harmless Micron and its subsidiaries, subcontractors, and affiliates and the directors, officers, and employees of each against all claims, costs, damages, and expenses and reasonable attorneys' fees arising out of, directly or indirectly, any claim of product liability, personal injury, or death arising in any way out of such critical application, whether or not Micron or its subsidiaries, subcontractors, or affiliates were negligent in the design, manufacture, or warning of the Micron product.

Customer Responsibility. Customers are responsible for the design, manufacture, and operation of their systems, applications, and products using Micron products. ALL SEMICONDUCTOR PRODUCTS HAVE INHERENT FAILURE RATES AND LIMITED USEFUL LIVES. IT IS THE CUSTOMER'S SOLE RESPONSIBILITY TO DETERMINE WHETHER THE MICRON PRODUCT IS SUITABLE AND FIT FOR THE CUSTOMER'S SYSTEM, APPLICATION, OR PRODUCT. Customers must ensure that adequate design, manufacturing, and operating safeguards are included in customer's applications and products to eliminate the risk that personal injury, death, or severe property or environmental damages will result from failure of any semiconductor component.

Limited Warranty. In no event shall Micron be liable for any indirect, incidental, punitive, special or consequential damages (including without limitation lost profits, lost savings, business interruption, costs related to the removal or replacement of any products or rework charges) whether or not such damages are based on tort, warranty, breach of contract or other legal theory, unless explicitly stated in a written agreement executed by Micron's duly authorized representative.# Product Specification 

## General Description

The 16 Gb mobile low-power DDR4 SDRAM with low $\mathrm{V}_{\mathrm{DDQ}}$ (LPDDR4X) is a high-speed, CMOS dynamic random-access memory device. This device is internally configured with 2 channels or 1 channel $\times 16$ I/O, each channel having 8-banks.

## General Notes

Throughout the data sheet, figures and text refer to DQs as DQ. DQ should be interpreted as any or all DQ collectively, unless stated otherwise.
DQS and CK should be interpreted as DQS_t, DQS_c and CK_t, CK_c respectively, unless stated otherwise. CA includes all CA pins used for a given density.
In timing diagrams, CMD is used as an indicator only. Actual signals occur on CA[5:0].
$\mathrm{V}_{\text {REF }}$ indicates $\mathrm{V}_{\text {REFCA }}$ and $\mathrm{V}_{\text {REFDQ. }}$.
Complete functionality may be described throughout the entire document. Any page or diagram may have been simplified to convey a topic and may not be inclusive of all requirements.
Any specific requirement takes precedence over a general statement.
Any functionality not specifically stated herein is considered undefined, illegal, not supported, and will result in unknown operation.
For single-ended CK and DQS features or specifications, refer to the LPDDR4X Single-Ended CK and DQS Addendum.# Device Configuration

Table 3: Device Configuration

| |  | 512M32 (16Gb/package) | 1G32 (32Gb/package) | 512M64 (32Gb/package)  |
| --- | --- | --- | --- | --- |
|  Die organization in the package | Channel A, rank 0 | x16 mode $\times 1$ die (dual channel) | x16 mode $\times 1$ die (dual channel) | x16 mode $\times 1$ die (dual channel)  |
| | Channel B, rank 0 | - | - | x16 mode $\times 1$ die (dual channel)  |
| | Channel C, rank 0 | - | - | x16 mode $\times 1$ die (dual channel)  |
| | Channel D, rank 0 |  |  | |
| | Channel A, rank 1 | - | x16 mode $\times 1$ die (dual channel) | -  |
| | Channel B, rank 1 |  |  | |
|  Die addressing | Dual/single Die | 16Gb dual-channel die |  | |
| | Memory density (per die) | 16Gb |  | |
| | Memory density (per channel) | 8Gb |  | |
| | Configuration | $64 \mathrm{Mb} \times 16 \mathrm{DQ} \times 8$ banks $\times 2$ channels |  | |
| | Number of channels (per die) | 2 |  | |
| | Number of banks (per channel) | 8 |  | |
| | Array prefetch (bits, per channel) | 256 |  | |
| | Number of rows (per channel) | 65,336 |  | |
| | Number of columns (fetch boundaries) | 64 |  | |
| | Page size (bytes) | 2048 |  | |
| | Channel density (bits per channel) | 8,589,934,592 |  | |
| | Total density (bits per die) | $17,179,869,184$ |  | |
| | Bank address | BA[2:0] |  | |
| | Row address | R[15:0] |  | |
| | Column address | C[9:0] |  | |
| | Burst starting address boundary | 64-bit |  | |

Note: 1. Refer to Package Block Diagram section in Product Specification and SDRAM Addressing section in General LPDDR4X specification.# Refresh Requirement Parameters

Table 4: Refresh Requirement Parameters

|  Parameter | Symbol | 8Gb per Channel | Unit  |
| --- | --- | --- | --- |
|  REFRESH cycle time (all banks) | ${ }^{1} \mathrm{RFCab}$ | 280 | ns  |
|  REFRESH cycle time (per bank) | ${ }^{1} \mathrm{RFCpb}$ | 140 | ns  |
|  Per bank refresh to per bank refresh time (different bank) | ${ }^{1} \mathrm{PBR} 2 \mathrm{PBR}$ | 90 | ns  |

Note: 1. This table only describes refresh parameters which are density dependent. Refer to Refresh Requirement section in General LPDDR4X specification for all the refresh parameters.# Package Block Diagrams 

Figure 2: Single-Die, Dual-Channel Package Block Diagram
Figure 3: Dual-Die, Dual-Channel Package Block Diagram
# Micron 

Figure 4: Dual-Die, Quad-Channel Package Block Diagram
# Ball Assignments and Descriptions 

Figure 5: 200-Ball Dual-Channel, Single-Rank Discrete FBGA

|  | 1 | 2 | 3 | 4 | 5 | 6 | 7 | 8 | 9 | 10 | 11 | 12 |
| :--: | :--: | :--: | :--: | :--: | :--: | :--: | :--: | :--: | :--: | :--: | :--: | :--: |
| A | DNU | DNU | $\mathrm{V}_{55}$ | $\mathrm{V}_{\mathrm{DD} 2}$ | ZQ0 |  |  | NC | $\mathrm{V}_{\mathrm{DD} 2}$ | $\mathrm{V}_{55}$ | DNU | DNU |
| B | DNU | DQ0_A | $\mathrm{V}_{\mathrm{DDQ}}$ | DQ7_A | $\mathrm{V}_{\mathrm{DDQ}}$ |  |  | $\mathrm{V}_{\mathrm{DDQ}}$ | DQ15_A | $\mathrm{V}_{\mathrm{DDQ}}$ | DQ8_A | DNU |
| C | $\mathrm{V}_{55}$ | DQ1_A | DMI0_A | DQ6_A | $\mathrm{V}_{55}$ |  |  | $\mathrm{V}_{55}$ | DQ14_A | DMI1_A | DQ9_A | $\mathrm{V}_{55}$ |
| D | $\mathrm{V}_{\mathrm{DDQ}}$ | $\mathrm{V}_{55}$ | DQ50_t_A | $\mathrm{V}_{55}$ | $\mathrm{V}_{\mathrm{DDQ}}$ |  |  | $\mathrm{V}_{\mathrm{DDQ}}$ | $\mathrm{V}_{55}$ | DQ51_t_A | $\mathrm{V}_{55}$ | $\mathrm{V}_{\mathrm{DDQ}}$ |
| E | $\mathrm{V}_{55}$ | DQ2_A | DQ50_c_A | DQ5_A | $\mathrm{V}_{55}$ |  |  | $\mathrm{V}_{55}$ | DQ13_A | DQ51_c_A | DQ10_A | $\mathrm{V}_{55}$ |
| F | $\mathrm{V}_{\mathrm{DD} 1}$ | DQ3_A | $\mathrm{V}_{\mathrm{DDQ}}$ | DQ4_A | $\mathrm{V}_{\mathrm{DD} 2}$ |  |  | $\mathrm{V}_{\mathrm{DD} 2}$ | DQ12_A | $\mathrm{V}_{\mathrm{DDQ}}$ | DQ11_A | $\mathrm{V}_{\mathrm{DD} 1}$ |
| G | $\mathrm{V}_{55}$ | ODT_CA_A | $\mathrm{V}_{55}$ | $\mathrm{V}_{\mathrm{DD} 1}$ | $\mathrm{V}_{55}$ |  |  | $\mathrm{V}_{55}$ | $\mathrm{V}_{\mathrm{DD} 1}$ | $\mathrm{V}_{55}$ | NC | $\mathrm{V}_{55}$ |
| H | $\mathrm{V}_{\mathrm{DD} 2}$ | CA0_A | NC | CS0_A | $\mathrm{V}_{\mathrm{DD} 2}$ |  |  | $\mathrm{V}_{\mathrm{DD} 2}$ | CA2_A | CA3_A | CA4_A | $\mathrm{V}_{\mathrm{DD} 2}$ |
| J | $\mathrm{V}_{55}$ | CA1_A | $\mathrm{V}_{55}$ | CKE0_A | NC |  |  | CK_t_A | CK_c_A | $\mathrm{V}_{55}$ | CAS_A | $\mathrm{V}_{55}$ |
| K | $\mathrm{V}_{\mathrm{DD} 2}$ | $\mathrm{V}_{55}$ | $\mathrm{V}_{\mathrm{DD} 2}$ | $\mathrm{V}_{55}$ | NC |  |  | NC | $\mathrm{V}_{55}$ | $\mathrm{V}_{\mathrm{DD} 2}$ | $\mathrm{V}_{55}$ | $\mathrm{V}_{\mathrm{DD} 2}$ |

L
M

| N | $\mathrm{V}_{\mathrm{DD} 2}$ | $\mathrm{V}_{55}$ | $\mathrm{V}_{\mathrm{DD} 2}$ | $\mathrm{V}_{55}$ | NC |
| :--: | :--: | :--: | :--: | :--: | :--: |
| P | $\mathrm{V}_{55}$ | CA1_B | $\mathrm{V}_{55}$ | CKE0_B | NC |
| R | $\mathrm{V}_{\mathrm{DD} 2}$ | CA0_B | NC | CS0_B | $\mathrm{V}_{\mathrm{DD} 2}$ |
| T | $\mathrm{V}_{55}$ | ODT_CA_B | $\mathrm{V}_{55}$ | $\mathrm{V}_{\mathrm{DD} 1}$ | $\mathrm{V}_{55}$ |
| U | $\mathrm{V}_{\mathrm{DD} 1}$ | DQ3_B | $\mathrm{V}_{\mathrm{DDQ}}$ | DQ4_B | $\mathrm{V}_{\mathrm{DD} 2}$ |
| V | $\mathrm{V}_{55}$ | DQ2_B | DQ50_c_B | DQ5_B | $\mathrm{V}_{55}$ |
| W | $\mathrm{V}_{\mathrm{DDQ}}$ | $\mathrm{V}_{55}$ | DQ50_t_B | $\mathrm{V}_{55}$ | $\mathrm{V}_{\mathrm{DDQ}}$ |
| Y | $\mathrm{V}_{55}$ | DQ1_B | DMI0_B | DQ6_B | $\mathrm{V}_{55}$ |
| AA | DNU | DQ0_B | $\mathrm{V}_{\mathrm{DDQ}}$ | DQ7_B | $\mathrm{V}_{\mathrm{DDQ}}$ |
| AB | DNU | DNU | $\mathrm{V}_{55}$ | $\mathrm{V}_{\mathrm{DD} 2}$ | $\mathrm{V}_{55}$ |

| NC | $\mathrm{V}_{55}$ | $\mathrm{V}_{\mathrm{DD} 2}$ | $\mathrm{V}_{55}$ | $\mathrm{V}_{\mathrm{DD} 2}$ |
| :--: | :--: | :--: | :--: | :--: |
| CK_t_B | CK_c_B | $\mathrm{V}_{55}$ | CAS_B | $\mathrm{V}_{55}$ |
| $\mathrm{V}_{\mathrm{DD} 2}$ | CA2_B | CA3_B | CA4_B | $\mathrm{V}_{\mathrm{DD} 2}$ |
| $\mathrm{V}_{55}$ | $\mathrm{V}_{\mathrm{DD} 1}$ | $\mathrm{V}_{55}$ | RESET_n | $\mathrm{V}_{55}$ |
| $\mathrm{V}_{\mathrm{DD} 2}$ | DQ12_B | $\mathrm{V}_{\mathrm{DDQ}}$ | DQ11_B | $\mathrm{V}_{\mathrm{DD} 1}$ |
| $\mathrm{V}_{55}$ | DQ13_B | DQ51_c_B | DQ10_B | $\mathrm{V}_{55}$ |
| $\mathrm{V}_{\mathrm{DDQ}}$ | $\mathrm{V}_{55}$ | DQ51_t_B | $\mathrm{V}_{55}$ | $\mathrm{V}_{\mathrm{DDQ}}$ |
| $\mathrm{V}_{55}$ | DQ14_B | DMI1_B | DQ9_B | $\mathrm{V}_{55}$ |
| $\mathrm{V}_{\mathrm{DDQ}}$ | DQ15_B | $\mathrm{V}_{\mathrm{DDQ}}$ | DQ8_B | DNU |
| $\mathrm{V}_{55}$ | $\mathrm{V}_{\mathrm{DD} 2}$ | $\mathrm{V}_{55}$ | DNU | DNU |

Top View (ball down)
Figure 6: 200-Ball Dual-Channel, Dual-Rank Discrete FBGA

|  | 1 | 2 | 3 | 4 | 5 | 6 | 7 | 8 | 9 | 10 | 11 | 12 |
| :--: | :--: | :--: | :--: | :--: | :--: | :--: | :--: | :--: | :--: | :--: | :--: | :--: |
| A | DNU | DNU | $\mathrm{V}_{\mathrm{SS}}$ | $\mathrm{V}_{\mathrm{DD2}}$ | ZQ0 |  |  | ZQ1 | $\mathrm{V}_{\mathrm{DD2}}$ | $\mathrm{V}_{\mathrm{SS}}$ | DNU | DNU |
| B | DNU | DQ0_A | $\mathrm{V}_{\mathrm{DDQ}}$ | DQ7_A | $\mathrm{V}_{\mathrm{DDQ}}$ |  |  | $\mathrm{V}_{\mathrm{DDQ}}$ | DQ15_A | $\mathrm{V}_{\mathrm{DDQ}}$ | DQ8_A | DNU |
| C | $\mathrm{V}_{\mathrm{SS}}$ | DQ1_A | DMI0_A | DQ6_A | $\mathrm{V}_{\mathrm{SS}}$ |  |  | $\mathrm{V}_{\mathrm{SS}}$ | DQ14_A | DMI1_A | DQ9_A | $\mathrm{V}_{\mathrm{SS}}$ |
| D | $\mathrm{V}_{\mathrm{DDQ}}$ | $\mathrm{V}_{\mathrm{SS}}$ | DQS0_t_A | $\mathrm{V}_{\mathrm{SS}}$ | $\mathrm{V}_{\mathrm{DDQ}}$ |  |  | $\mathrm{V}_{\mathrm{DDQ}}$ | $\mathrm{V}_{\mathrm{SS}}$ | DQS1_t_A | $\mathrm{V}_{\mathrm{SS}}$ | $\mathrm{V}_{\mathrm{DDQ}}$ |
| E | $\mathrm{V}_{\mathrm{SS}}$ | DQ2_A | DQS0_c_A | DQ5_A | $\mathrm{V}_{\mathrm{SS}}$ |  |  | $\mathrm{V}_{\mathrm{SS}}$ | DQ13_A | DQS1_c_A | DQ10_A | $\mathrm{V}_{\mathrm{SS}}$ |
| F | $\mathrm{V}_{\mathrm{DD1}}$ | DQ3_A | $\mathrm{V}_{\mathrm{DDQ}}$ | DQ4_A | $\mathrm{V}_{\mathrm{DD2}}$ |  |  | $\mathrm{V}_{\mathrm{DD2}}$ | DQ12_A | $\mathrm{V}_{\mathrm{DDQ}}$ | DQ11_A | $\mathrm{V}_{\mathrm{DD1}}$ |
| G | $\mathrm{V}_{\mathrm{SS}}$ | ODT_CA_A | $\mathrm{V}_{\mathrm{SS}}$ | $\mathrm{V}_{\mathrm{DD1}}$ | $\mathrm{V}_{\mathrm{SS}}$ |  |  | $\mathrm{V}_{\mathrm{SS}}$ | $\mathrm{V}_{\mathrm{DD1}}$ | $\mathrm{V}_{\mathrm{SS}}$ | NC | $\mathrm{V}_{\mathrm{SS}}$ |
| H | $\mathrm{V}_{\mathrm{DD2}}$ | CA0_A | CS1_A | CS0_A | $\mathrm{V}_{\mathrm{DD2}}$ |  |  | $\mathrm{V}_{\mathrm{DD2}}$ | CA2_A | CA3_A | CA4_A | $\mathrm{V}_{\mathrm{DD2}}$ |
| J | $\mathrm{V}_{\mathrm{SS}}$ | CA1_A | $\mathrm{V}_{\mathrm{SS}}$ | CKE0_A | CKE1_A |  |  | CK_t_A | CK_c_A | $\mathrm{V}_{\mathrm{SS}}$ | CAS_A | $\mathrm{V}_{\mathrm{SS}}$ |
| K | $\mathrm{V}_{\mathrm{DD2}}$ | $\mathrm{V}_{\mathrm{SS}}$ | $\mathrm{V}_{\mathrm{DD2}}$ | $\mathrm{V}_{\mathrm{SS}}$ | NC |  |  | NC | $\mathrm{V}_{\mathrm{SS}}$ | $\mathrm{V}_{\mathrm{DD2}}$ | $\mathrm{V}_{\mathrm{SS}}$ | $\mathrm{V}_{\mathrm{DD2}}$ |

L

M

| N | $\mathrm{V}_{\mathrm{DD2}}$ | $\mathrm{V}_{\mathrm{SS}}$ | $\mathrm{V}_{\mathrm{DD2}}$ | $\mathrm{V}_{\mathrm{SS}}$ | NC |
| :--: | :--: | :--: | :--: | :--: | :--: |
| P | $\mathrm{V}_{\mathrm{SS}}$ | CA1_B | $\mathrm{V}_{\mathrm{SS}}$ | CKE0_B | CKE1_B |
| R | $\mathrm{V}_{\mathrm{DD2}}$ | CA0_B | CS1_B | CS0_B | $\mathrm{V}_{\mathrm{DD2}}$ |
| T | $\mathrm{V}_{\mathrm{SS}}$ | ODT_CA_B | $\mathrm{V}_{\mathrm{SS}}$ | $\mathrm{V}_{\mathrm{DD1}}$ | $\mathrm{V}_{\mathrm{SS}}$ |
| U | $\mathrm{V}_{\mathrm{DD1}}$ | DQ3_B | $\mathrm{V}_{\mathrm{DDQ}}$ | DQ4_B | $\mathrm{V}_{\mathrm{DD2}}$ |
| V | $\mathrm{V}_{\mathrm{SS}}$ | DQ2_B | DQS0_c_B | DQ5_B | $\mathrm{V}_{\mathrm{SS}}$ |
| W | $\mathrm{V}_{\mathrm{DDQ}}$ | $\mathrm{V}_{\mathrm{SS}}$ | DQS0_t_B | $\mathrm{V}_{\mathrm{SS}}$ | $\mathrm{V}_{\mathrm{DDQ}}$ |
| Y | $\mathrm{V}_{\mathrm{SS}}$ | DQ1_B | DMI0_B | DQ6_B | $\mathrm{V}_{\mathrm{SS}}$ |
| AA | DNU | DQ0_B | $\mathrm{V}_{\mathrm{DDQ}}$ | DQ7_B | $\mathrm{V}_{\mathrm{DDQ}}$ |
| AB | DNU | DNU | $\mathrm{V}_{\mathrm{SS}}$ | $\mathrm{V}_{\mathrm{DD2}}$ | $\mathrm{V}_{\mathrm{SS}}$ |

| NC | $\mathrm{V}_{\mathrm{SS}}$ | $\mathrm{V}_{\mathrm{DD2}}$ | $\mathrm{V}_{\mathrm{SS}}$ | $\mathrm{V}_{\mathrm{DD2}}$ |
| :--: | :--: | :--: | :--: | :--: |
| CK_t_B | CK_c_B | $\mathrm{V}_{\mathrm{SS}}$ | CAS_B | $\mathrm{V}_{\mathrm{SS}}$ |
| $\mathrm{V}_{\mathrm{DD2}}$ | CA2_B | CA3_B | CA4_B | $\mathrm{V}_{\mathrm{DD2}}$ |
| $\mathrm{V}_{\mathrm{SS}}$ | $\mathrm{V}_{\mathrm{DD1}}$ | $\mathrm{V}_{\mathrm{SS}}$ | RESET_n | $\mathrm{V}_{\mathrm{SS}}$ |
| $\mathrm{V}_{\mathrm{DD2}}$ | DQ12_B | $\mathrm{V}_{\mathrm{DDQ}}$ | DQ11_B | $\mathrm{V}_{\mathrm{DD1}}$ |
| $\mathrm{V}_{\mathrm{SS}}$ | DQ13_B | DQS1_c_B | DQ10_B | $\mathrm{V}_{\mathrm{SS}}$ |
| $\mathrm{V}_{\mathrm{DDQ}}$ | $\mathrm{V}_{\mathrm{SS}}$ | DQS1_t_B | $\mathrm{V}_{\mathrm{SS}}$ | $\mathrm{V}_{\mathrm{DDQ}}$ |
| $\mathrm{V}_{\mathrm{SS}}$ | DQ14_B | DMI1_B | DQ9_B | $\mathrm{V}_{\mathrm{SS}}$ |
| $\mathrm{V}_{\mathrm{DDQ}}$ | DQ15_B | $\mathrm{V}_{\mathrm{DDQ}}$ | DQ8_B | DNU |
| $\mathrm{V}_{\mathrm{SS}}$ | $\mathrm{V}_{\mathrm{DD2}}$ | $\mathrm{V}_{\mathrm{SS}}$ | DNU | DNU |

Top View (ball down)
Table 5: Ball/Pad Descriptions for $\mathbf{x 3 2}$

| Symbol | Type | Description |
| :--: | :--: | :--: |
| $\mathrm{CK}_{-} \mathrm{t}_{-} \mathrm{A}, \mathrm{CK}_{-} \mathrm{c}_{-} \mathrm{A}$, <br> CK_t_B, CK_c_B | Input | Clock: CK_t and CK_c are differential clock inputs. All address, command and control input signals are sampled on positive edge of CK_t and the negative edge of CK_c. AC timings for CA parameters are referenced to clock. Each channel (A, B) has its own clock pair. |
| $\mathrm{CKEO}_{-} \mathrm{A}, \mathrm{CKE1}_{-} \mathrm{A}$, <br> CKEO_B, CKE1_B | Input | Clock enable: CKE HIGH activates and CKE LOW deactivates the internal clock signals, input buffers, and output drivers. Power-saving modes are entered and exited via CKE transitions. CKE is sampled at the rising edge of CK. |
| $\begin{aligned} & \hline \text { CSO_A, CS1_A, } \\ & \text { CSO_B, CS1_B } \end{aligned}$ | Input | Chip select: Each channel (A, B) has its own CS signals. |
| $\begin{aligned} & \hline \text { CA[5:0]_A, } \\ & \text { CA[5:0]_B } \end{aligned}$ | Input | Command/address inputs: Provide the command and address inputs according to the command truth table. Each channel (A, B) has its own CA signals. |
| ODT_CA_A, ODT_CA_B | Input | LPDDR4 CA ODT control: The ODT_CA pin is used in conjunction with the mode register to turn on/off the on-die termination for CA pins. It is bonded to $\mathrm{V}_{\mathrm{DD} 2}$ within the package, or at the package ball, for the terminating rank, and the non-terminating ranks are bonded to $\mathrm{V}_{55}$ (or left floating with a weak pull-down on the DRAM die). The terminating rank is the DRAM that terminates the CA bus for all die on the same channel. LPDDR4X CA ODT Control: The ODT_CA pin is ignored by LPDDR4X devices. CA ODT is fully controlled through MR11 and MR22. The ODT_CA pin shall be connected to a valid logic level. |
| $\begin{aligned} & \text { DQ[15:0]_A, } \\ & \text { DQ[15:0]_B } \end{aligned}$ | I/O | Data input/output: Bidirectional data bus. |
| $\begin{aligned} & \text { DQS[1:0]_t_A, } \\ & \text { DQS[1:0]_c_A, } \\ & \text { DQS[1:0]_t_B, } \\ & \text { DQS[1:0]_c_B } \end{aligned}$ | I/O | Data strobe: DQS_t and DQS_c are bi-directional differential output clock signals used to strobe data during a READ or WRITE. The data strobe is generated by the DRAM for a READ and is edge-aligned with data. The data strobe is generated by the SoC memory controller for a WRITE and is trained to precede data. Each byte of data has a data strobe signal pair. Each channel (A, B) has its own DQS_t and DQS_c strobes. |
| $\begin{aligned} & \text { DMI[1:0]_A, } \\ & \text { DMI[1:0]_B } \end{aligned}$ | I/O | Data mask/Data bus inversion: Data mask inversion (DMI) is a dual use bi-directional signal used to indicate data to be masked, and data which is inverted on the bus. For data bus inversion (DBI), the DMI signal is driven HIGH when the data on the data bus is inverted, or driven LOW when the data is in its normal state. DBI can be disabled via a mode register setting. For data mask, the DMI signal is used in combination with the data lines to indicate data to be masked in a MASK WRITE command (see the Data Mask (DM) and Data Bus Inversion (DBI) sections for details). The data mask function can be disabled via a mode register setting. Each byte of data has a DMI signal. Each channel has its own DMI signals. |
| ZQ0, ZQ1 | Reference | ZQ calibration reference: Used to calibrate the output drive strength and the termination resistance. The ZQ pin shall be connected to $\mathrm{V}_{\text {DDQ }}$ through a $240 \Omega \pm 1 \%$ resistor. |
| $\mathrm{V}_{\text {DDQ }}, \mathrm{V}_{\mathrm{DD} 1}, \mathrm{~V}_{\mathrm{DD} 2}$ | Supply | Power supplies: Isolated on the die for improved noise immunity. |
| $\mathrm{V}_{55}$ | Supply | Ground reference: Power supply ground reference. |
| RESET_n | Input | RESET: When asserted LOW, the RESET pin resets all channels of the die. |
| DNU | - | Do not use: Must be grounded or left floating. |
| NC | - | No connect: Not internally connected. |# Ball Descriptions and Assignments

Table 6: Ball/Pad Descriptions for x64

|  Symbol | Type | Description  |
| --- | --- | --- |
|  CK_t_A, CK_c_A, CK_t_B, CK_c_B, CK_t_C, CK_c_C, CK_t_D, CK_c_D | Input | Clock: CK_t and CK_c are differential clock inputs. All address, command, and control input signals are sampled on positive edge of CK_t and the negative edge of CK_c. AC timings for CA parameters are referenced to clock. Each channel (A, B, C, and D) has its own clock pair.  |
|  CKEO_A, CKE1_A, CKEO_B, CKE1_B, CKEO_C, CKE1_C, CKEO_D, CKE1_D | Input | Clock enable: CKE HIGH activates and CKE LOW deactivates the internal clock signals, input buffers, and output drivers. Power-saving modes are entered and exited via CKE transitions. CKE is sampled at the rising edge of CK.  |
|  $\begin{gathered} \text { CSO_A, CS1_A, } \ \text { CSO_B, CS1_B, } \ \text { CSO_C, CS1_C, } \ \text { CSO_D, CS1_D } \end{gathered}$ | Input | Chip select: Each rank $(0,1)$ in each channel (A, B, C, and D) has its own CS signals.  |
|  $\begin{gathered} \text { CA[5:0]_A, CA[5:0]_B, } \ \text { CA[5:0]_C, CA[5:0]_D } \end{gathered}$ | Input | Command/Address inputs: Provide the command and address inputs according to the command truth table. Each channel (A, B, C, and D) has its own CA signals.  |
|  ODT_CA_A, ODT_CA_B, ODT_CA_C, ODT_CA_D | Input | CA ODT control: The ODT_CA pin is ignored by LPDDR4X devices. CA ODT is fully controlled through MR11 and MR22. The ODT_CA pin shall be connected to a valid logic level.  |
|  $\begin{gathered} \text { DQ[15:0]_A, DQ[15:0]_B, } \ \text { DQ[15:0]_C, DQ[15:0]_D } \end{gathered}$ | I/O | Data input/output: Bidirectional data bus.  |
|  $\begin{gathered} \text { DQS[1:0]_t_A, } \ \text { DQS[1:0]_c_A, } \ \text { DQS[1:0]_t_B, } \ \text { DQS[1:0]_c_B, } \ \text { DQS[1:0]_t_C, } \ \text { DQS[1:0]_c_C, } \ \text { DQS[1:0]_t_D, } \ \text { DQS[1:0]_c_D } \end{gathered}$ | I/O | Data strobe: DQS_t and DQS_c are bi-directional differential output clock signals used to strobe data during READ or WRITE. The data strobe is generated by the DRAM for a READ and is edge-aligned with data. The data strobe is generated by the SoC memory controller for a WRITE and is trained to precede data. Each byte of data has a data strobe signal pair. Each channel (A, B, C, and D) has its own DQS_t and DQS_c strobes.  |
|  $\begin{gathered} \text { DMI[1:0]_A, DMI[1:0]_B, } \ \text { DMI[1:0]_C, DMI[1:0]_D } \end{gathered}$ | I/O | Data mask/Data bus inversion: Data mask inversion (DMI) is a dual use bi-directional signal used to indicate data to be masked, and data which is inverted on the bus. For data bus inversion (DBI), the DMI signal is driven HIGH when the data on the data bus is inverted, or driven LOW when the data is in its normal state. DBI can be disabled via a mode register setting. For data mask, the DMI signal is used in combination with the data lines to indicate data to be masked in a MASK WRITE command (see the Data Mask (DM) and Data Bus Inversion (DBI) sections for details). The data mask function can be disabled via a mode register setting. Each byte of data has a DMI signal. Each channel has its own DMI signals.  |
|  $\begin{gathered} \text { ZQ0_A, ZQ1_A, } \ \text { ZQ0_D, ZQ1_D } \end{gathered}$ | Reference | ZQ calibration reference: Used to calibrate the output drive strength and the termination resistance. The ZQ pin shall be connected to $\mathrm{V}_{\text {DDQ }}$ through a $240 \Omega$ $\pm 1 \%$ resistor.  |
|  $\mathrm{V}_{\text {DDQ }}, \mathrm{V}_{\mathrm{DD} 1}, \mathrm{~V}_{\mathrm{DD} 2}$ | Supply | Power supplies: Isolated on the die for improved noise immunity.  |
|  $\mathrm{V}_{\mathrm{SS}}$ | Supply | Ground reference: Power supply ground reference.  |
|  RESET_n | Input | RESET: When asserted LOW, the RESET pin resets all channels of the die.  |
|  NC | - | No connect: Not internally connected.  |# Micron 

LPDDR4X/LPDDR4 SDRAM Product Specification


Micron Confidential and Proprietary

**LPDDR4X/LPDDR4 SDRAM Product Specification**



|  |   |   |   |   |   |   |   |   |   |   |   |   |   |   |   |   |   |   |   |   |   |   |   |   |   |   |   |   |   |   |   |   |   |   |   |   |   |   |   |   |   |   |   |   |   |   |   |   |   |   |   |   |   |   |   |   |   |   |   |   |   |   |   |   |   |   |   |   |   |   |   |   |   |   |   |   |   |   |   |   |   |   |   |   |   |   |   |   |   |   |   |   |   |   |   |   |   |   |   |   |  # Package Dimensions 

Figure 9: 200-Ball TFBGA - 10mm x 14.5mm x 1.05mm (Package Code: ZW)



Notes: 1. All dimensions are in millimeters.
2. Solder ball composition: SACQ with CuOSP pads ( $\mathrm{Sn}, 4 \% \mathrm{Ag}, 0.5 \% \mathrm{Cu}, 3 \% \mathrm{Bi}, 0.05 \% \mathrm{Ni}$ ).Figure 10: 200-Ball TFBGA - 10mm $\times 14.5 \mathrm{~mm} \times 1.1 \mathrm{~mm}$ (Package Code: FW)



Notes: 1. All dimensions are in millimeters.
2. Solder ball composition: SACQ with CuOSP pads ( $\mathrm{Sn}, 4 \% \mathrm{Ag}, 0.5 \% \mathrm{Cu}, 3 \% \mathrm{Bi}, 0.05 \% \mathrm{Ni}$ ).# Package Dimensions 

Figure 11: 376-Ball WFBGA - 14.0mm x 14.0mm x 0.71mm (Package Code: NZ)



Notes: 1. All dimensions are in millimeters.
2. Solder ball composition: SAC302 with $\mathrm{Ni} / \mathrm{Au}$ pads ( $\mathrm{Sn} 3 \mathrm{Ag0.2Cu})$.
3. The package height does not include room temperature warpage.# Package Dimensions 

Figure 12: 556-Ball TFBGA - 12.4mm $\times 12.4 \mathrm{~mm} \times 1.1 \mathrm{~mm}$ (Package Code: HJ)



Notes: 1. All dimensions are in millimeters.
2. Solder ball composition: SACQ ( $\mathrm{Sn}, 4 \% \mathrm{Ag}, 0.5 \% \mathrm{Cu}, 3 \% \mathrm{Bi}, 0.05 \% \mathrm{Ni}$ )
3. The package height does not include room temperature warpage.# LPDDR4X/LPDDR4 SDRAM Product Specification

## Product Specific Mode Register Definition

Table 7: Mode Register Contents

|  Mode Register | OP7 | OP6 | OP5 | OP4 | OP3 | OP2 | OP1 | OP0  |
| --- | --- | --- | --- | --- | --- | --- | --- | --- |
|  MR0 |  |  | Single-ended mode |  |  | RFM support | Latency mode | REF  |
| |  |  | $\begin{aligned} & \text { OP[0] = 1b: Only modified refresh mode supported } \ & \text { OP[1] = 0b: Device supports normal latency } \ & \text { OP[2] = 0b: Device supports TRR } \ & \text { OP[5] = 1b: Device supports single-ended mode } \end{aligned}$ |  |  |  |  | |
|  MR3 |  |  |  |  |  | PPRP $^{3}$ |  | |
| |  |  | OP[2] = 0b: PPR protection disabled (default) 1b: PPR protection enabled |  |  |  |  | |
|  MR5 |  |  | Manufacturer ID |  |  |  |  | |
| |  |  | 1111 1111b: Micron |  |  |  |  | |
|  MR6 |  |  | Revision ID1 |  |  |  |  | |
| |  |  | 0000 0111b |  |  |  |  | |
|  MR8 | I/O width |  | Density |  |  |  |  | |
| | $\begin{aligned} & \text { OP[7:6] = } \ & \text { 00b: x16/channel } \end{aligned}$ |  | $\begin{aligned} & \text { OP[5:2] = 0100b: 16Gb dual-channel die } \ & \text { OP[5:2] = 0110b: 16Gb single-channel die } \end{aligned}$ |  |  |  |  | |
|  MR13 |  |  |  |  |  | VRO |  | |
| |  | OP[2] = 0b: Normal operation (default) 1b: Output the $\mathrm{V}_{\text {REF(CA) }}$ value on DQ7 and $\mathrm{V}_{\text {REF(DQ) }}$ value on DQ6 |  |  |  |  |  | |
|  MR24 | TRR mode |  |  |  | Unlimited MAC |  | MAC value | |
| |  |  | OP[3:0] = 1000b: Unlimited MAC |  |  |  |  | |
| |  |  | OP[7] = 0b: Disable (default) 1b: Reserved |  |  |  |  | |
|  MR25 |  | PPR resources ${ }^{4}$ |  |  |  |  |  | |
| | Bank 7 | Bank 6 | Bank 5 | Bank 4 | Bank 3 | Bank 2 | Bank 1 | Bank 0  |
| |  |  | 0b: PPR resource is not available 1b: PPR resource is available |  |  |  |  | |

Notes: 1. The contents of Product Specific Mode Register definition will reflect information specific to each die in these packages. 2. Other bits not defined above and other mode registers are referred to Mode Register Assignments and Definitions section. 3. When not using PPR function, PPR protection should be enabled to prevent unintended PPR entry.(MR3 OP[2] = 1b). 4. Before using PPR function, confirm the availability of PPR resource by reading MR25. 5. Notes 1 and 2 apply to entire table.# I $_{\text {DD }}$ Parameters 

Refer to $\mathrm{I}_{\mathrm{DD}}$ Specification Parameters and Test Conditions section for detailed conditions.
Table 8: LPDDR4X I $_{\text {DD }}$ Parameters - Single Die (16Gb Dual-Channel Die)

| Symbol | Supply | $\mathrm{T}_{\mathrm{C}} / 4266 \mathrm{Mb} / \mathrm{s}$ |  | Unit | Note |
| :--: | :--: | :--: | :--: | :--: | :--: |
|  |  | $85^{\circ} \mathrm{C}$ | $95^{\circ} \mathrm{C}$ |  |  |
| IDDO1 | $\mathrm{V}_{\mathrm{DD} 1}$ | 8.00 | 8.40 | mA |  |
| IDDO2 | $\mathrm{V}_{\mathrm{DD} 2}$ | 58.00 | 59.00 |  |  |
| IDDOQ | $\mathrm{V}_{\mathrm{DDQ}}$ | 1.50 | 1.50 |  |  |
| IDD2P1 | $\mathrm{V}_{\mathrm{DD} 1}$ | 2.40 | 2.40 | mA |  |
| IDD2P2 | $\mathrm{V}_{\mathrm{DD} 2}$ | 3.60 | 5.40 |  |  |
| IDD2PQ | $\mathrm{V}_{\mathrm{DDQ}}$ | 1.50 | 1.50 |  |  |
| IDD2PS1 | $\mathrm{V}_{\mathrm{DD} 1}$ | 2.40 | 2.40 | mA |  |
| IDD2PS2 | $\mathrm{V}_{\mathrm{DD} 2}$ | 3.60 | 5.40 |  |  |
| IDD2PSQ | $\mathrm{V}_{\mathrm{DDQ}}$ | 1.50 | 1.50 |  |  |
| IDD2N1 | $\mathrm{V}_{\mathrm{DD} 1}$ | 2.40 | 2.40 | mA |  |
| IDD2N2 | $\mathrm{V}_{\mathrm{DD} 2}$ | 30.00 | 33.00 |  |  |
| IDD2NQ | $\mathrm{V}_{\mathrm{DDQ}}$ | 1.50 | 1.50 |  |  |
| IDD2NS1 | $\mathrm{V}_{\mathrm{DD} 1}$ | 2.40 | 2.40 | mA |  |
| IDD2NS2 | $\mathrm{V}_{\mathrm{DD} 2}$ | 20.00 | 25.00 |  |  |
| IDD2NSQ | $\mathrm{V}_{\mathrm{DDQ}}$ | 1.50 | 1.50 |  |  |
| IDD3P1 | $\mathrm{V}_{\mathrm{DD} 1}$ | 2.40 | 2.40 | mA |  |
| IDD3P2 | $\mathrm{V}_{\mathrm{DD} 2}$ | 9.60 | 9.80 |  |  |
| IDD3PQ | $\mathrm{V}_{\mathrm{DDQ}}$ | 1.50 | 1.50 |  |  |
| IDD3PS1 | $\mathrm{V}_{\mathrm{DD} 1}$ | 2.40 | 2.40 | mA |  |
| IDD3PS2 | $\mathrm{V}_{\mathrm{DD} 2}$ | 9.60 | 9.80 |  |  |
| IDD3PSQ | $\mathrm{V}_{\mathrm{DDQ}}$ | 1.50 | 1.50 |  |  |
| IDD3N1 | $\mathrm{V}_{\mathrm{DD} 1}$ | 3.40 | 3.40 | mA |  |
| IDD3N2 | $\mathrm{V}_{\mathrm{DD} 2}$ | 42.00 | 44.00 |  |  |
| IDD3NQ | $\mathrm{V}_{\mathrm{DDQ}}$ | 1.50 | 1.50 |  |  |
| IDD3NS1 | $\mathrm{V}_{\mathrm{DD} 1}$ | 3.40 | 3.40 | mA |  |
| IDD3NS2 | $\mathrm{V}_{\mathrm{DD} 2}$ | 30.00 | 36.00 |  |  |
| IDD3NSQ | $\mathrm{V}_{\mathrm{DDQ}}$ | 1.50 | 1.50 |  |  |
| IDD4R1 | $\mathrm{V}_{\mathrm{DD} 1}$ | 15.00 | 15.00 | mA | 2,3 |
| IDD4R2 | $\mathrm{V}_{\mathrm{DD} 2}$ | 400.00 | 400.00 |  |  |
| IDD4RQ | $\mathrm{V}_{\mathrm{DDQ}}$ | 126.10 | 126.10 |  |  |# Micron 

LPDDR4X/LPDDR4 SDRAM Product Specification

Table 8: LPDDR4X $\mathrm{I}_{\mathrm{DD}}$ Parameters - Single Die (16Gb Dual-Channel Die)

| Symbol | Supply | $\mathrm{T}_{\mathrm{C}} / 4266 \mathrm{Mb} / \mathrm{s}$ |  | Unit | Note |
| :--: | :--: | :--: | :--: | :--: | :--: |
|  |  | $85^{\circ} \mathrm{C}$ | $95^{\circ} \mathrm{C}$ |  |  |
| IDD4W1 | $\mathrm{V}_{\mathrm{DD} 1}$ | 15.00 | 15.00 | mA | 2 |
| IDD4W2 | $\mathrm{V}_{\mathrm{DD} 2}$ | 300.00 | 300.00 |  |  |
| IDD4WQ | $\mathrm{V}_{\mathrm{DDQ}}$ | 1.50 | 1.50 |  |  |
| IDDS1 | $\mathrm{V}_{\mathrm{DD} 1}$ | 35.00 | 35.00 | mA |  |
| IDDS2 | $\mathrm{V}_{\mathrm{DD} 2}$ | 190.00 | 195.00 |  |  |
| IDDSQ | $\mathrm{V}_{\mathrm{DDQ}}$ | 1.50 | 1.50 |  |  |
| IDDSAB1 | $\mathrm{V}_{\mathrm{DD} 1}$ | 7.60 | 7.80 | mA |  |
| IDDSAB2 | $\mathrm{V}_{\mathrm{DD} 2}$ | 36.00 | 41.00 |  |  |
| IDDSABQ | $\mathrm{V}_{\mathrm{DDQ}}$ | 1.50 | 1.50 |  |  |
| IDDSPB1 | $\mathrm{V}_{\mathrm{DD} 1}$ | 6.00 | 6.70 | mA |  |
| IDDSPB2 | $\mathrm{V}_{\mathrm{DD} 2}$ | 36.00 | 41.00 |  |  |
| IDDSPBQ | $\mathrm{V}_{\mathrm{DDQ}}$ | 1.50 | 1.50 |  |  |

Notes: 1. Published $\mathrm{I}_{\mathrm{DD}}$ values except $\mathrm{I}_{\mathrm{DD} 4 \mathrm{RQ}}$ are the maximum $\mathrm{I}_{\mathrm{DD}}$ values considering the worst-case conditions of process, temperature, and voltage.
2. $\mathrm{BL}=16, \mathrm{DBI}$ disabled.
3. $\mathrm{I}_{\mathrm{DD} 4 \mathrm{RQ}}$ value is reference only. Typical value. $\mathrm{V}_{\mathrm{OH}}=0.5 \times \mathrm{V}_{\mathrm{DDQ}} ; \mathrm{T}_{\mathrm{C}}=25^{\circ} \mathrm{C}$
4. $\mathrm{I}_{\mathrm{DD}}$ values reflect dual-channel operation with the same pattern for each channel.
5. $\mathrm{V}_{\mathrm{DD} 2}=1.06-1.17 \mathrm{~V} ; \mathrm{V}_{\mathrm{DDQ}}=0.57-0.65 \mathrm{~V} ; \mathrm{V}_{\mathrm{DD} 1}=1.70-1.95 \mathrm{~V}$;

Table 9: $\mathrm{I}_{\mathrm{DD6}}$ Full-Array Self Refresh Current - Single Die (16Gb Dual-Channel Die)

| Temperature | Supply | Full-Array Self Refresh Current | Unit |
| :-- | :--: | :--: | :--: |
| $25^{\circ} \mathrm{C}$ | $\mathrm{V}_{\mathrm{DD} 1}$ | 0.65 | mA |
|  | $\mathrm{V}_{\mathrm{DD} 2}$ | 1.33 |  |
|  | $\mathrm{V}_{\mathrm{DDQ}}$ | 0.02 |  |
| $85^{\circ} \mathrm{C}$ | $\mathrm{V}_{\mathrm{DD} 1}$ | 5.00 | mA |
|  | $\mathrm{V}_{\mathrm{DD} 2}$ | 12.00 |  |
|  | $\mathrm{V}_{\mathrm{DDQ}}$ | 1.50 |  |
| $95^{\circ} \mathrm{C}$ | $\mathrm{V}_{\mathrm{DD} 1}$ | 6.50 | mA |
|  | $\mathrm{V}_{\mathrm{DD} 2}$ | 18.00 |  |
|  | $\mathrm{V}_{\mathrm{DDQ}}$ | 1.50 |  |

Notes: 1. $\mathrm{I}_{\mathrm{DD} 6} 25^{\circ} \mathrm{C}$ is the typical value in the distribution with nominal $\mathrm{V}_{\mathrm{DD}}$ and a reference-only value. $\mathrm{I}_{\mathrm{DD} 6} 85^{\circ} \mathrm{C}, \mathrm{I}_{\mathrm{DD} 6} 95^{\circ} \mathrm{C}$ is the maximum $\mathrm{I}_{\mathrm{DD}}$ guaranteed value considering the worst-case conditions of process, temperature, and voltage.
2. $\mathrm{I}_{\mathrm{DD}}$ values reflect dual-channel operation with the same pattern for each channel.
3. $\mathrm{V}_{\mathrm{DD} 2}=1.06-1.17 \mathrm{~V} ; \mathrm{V}_{\mathrm{DDQ}}=0.57-0.65 \mathrm{~V} ; \mathrm{V}_{\mathrm{DD} 1}=1.70-1.95 \mathrm{~V}$# I $_{\text {DD }}$ Parameters 

Refer to $\mathrm{I}_{\mathrm{DD}}$ Specification Parameters and Test Conditions section for detailed conditions.
Table 10: LPDDR4 I $_{\text {DD }}$ Parameters - Single Die (16Gb Dual-Channel Die)

| Symbol | Supply | $\mathrm{T}_{\mathrm{C}} / 4266 \mathrm{Mb} / \mathrm{s}$ |  | Unit | Note |
| :--: | :--: | :--: | :--: | :--: | :--: |
|  |  | $85^{\circ} \mathrm{C}$ | $95^{\circ} \mathrm{C}$ |  |  |
| IDDO1 | $\mathrm{V}_{\mathrm{DD} 1}$ | 8.00 | 8.40 | mA |  |
| IDDO2 | $\mathrm{V}_{\mathrm{DD} 2}$ | 58.00 | 59.00 |  |  |
| IDDOQ | $\mathrm{V}_{\mathrm{DDQ}}$ | 1.50 | 1.50 |  |  |
| IDD2P1 | $\mathrm{V}_{\mathrm{DD} 1}$ | 2.40 | 2.40 | mA |  |
| IDD2P2 | $\mathrm{V}_{\mathrm{DD} 2}$ | 3.60 | 5.40 |  |  |
| IDD2PQ | $\mathrm{V}_{\mathrm{DDQ}}$ | 1.50 | 1.50 |  |  |
| IDD2PS1 | $\mathrm{V}_{\mathrm{DD} 1}$ | 2.40 | 2.40 | mA |  |
| IDD2PS2 | $\mathrm{V}_{\mathrm{DD} 2}$ | 3.60 | 5.40 |  |  |
| IDD2PSQ | $\mathrm{V}_{\mathrm{DDQ}}$ | 1.50 | 1.50 |  |  |
| IDD2N1 | $\mathrm{V}_{\mathrm{DD} 1}$ | 2.40 | 2.40 | mA |  |
| IDD2N2 | $\mathrm{V}_{\mathrm{DD} 2}$ | 30.00 | 33.00 |  |  |
| IDD2NQ | $\mathrm{V}_{\mathrm{DDQ}}$ | 1.50 | 1.50 |  |  |
| IDD2NS1 | $\mathrm{V}_{\mathrm{DD} 1}$ | 2.40 | 2.40 | mA |  |
| IDD2NS2 | $\mathrm{V}_{\mathrm{DD} 2}$ | 20.00 | 25.00 |  |  |
| IDD2NSQ | $\mathrm{V}_{\mathrm{DDQ}}$ | 1.50 | 1.50 |  |  |
| IDD3P1 | $\mathrm{V}_{\mathrm{DD} 1}$ | 2.40 | 2.40 | mA |  |
| IDD3P2 | $\mathrm{V}_{\mathrm{DD} 2}$ | 9.60 | 9.80 |  |  |
| IDD3PQ | $\mathrm{V}_{\mathrm{DDQ}}$ | 1.50 | 1.50 |  |  |
| IDD3PS1 | $\mathrm{V}_{\mathrm{DD} 1}$ | 2.40 | 2.40 | mA |  |
| IDD3PS2 | $\mathrm{V}_{\mathrm{DD} 2}$ | 9.60 | 9.80 |  |  |
| IDD3PSQ | $\mathrm{V}_{\mathrm{DDQ}}$ | 1.50 | 1.50 |  |  |
| IDD3N1 | $\mathrm{V}_{\mathrm{DD} 1}$ | 3.40 | 3.40 | mA |  |
| IDD3N2 | $\mathrm{V}_{\mathrm{DD} 2}$ | 42.00 | 44.00 |  |  |
| IDD3NQ | $\mathrm{V}_{\mathrm{DDQ}}$ | 1.50 | 1.50 |  |  |
| IDD3NS1 | $\mathrm{V}_{\mathrm{DD} 1}$ | 3.40 | 3.40 | mA |  |
| IDD3NS2 | $\mathrm{V}_{\mathrm{DD} 2}$ | 30.00 | 36.00 |  |  |
| IDD3NSQ | $\mathrm{V}_{\mathrm{DDQ}}$ | 1.50 | 1.50 |  |  |
| IDD4R1 | $\mathrm{V}_{\mathrm{DD} 1}$ | 15.00 | 15.00 | mA | 2,3 |
| IDD4R2 | $\mathrm{V}_{\mathrm{DD} 2}$ | 400.00 | 400.00 |  |  |
| IDD4RQ | $\mathrm{V}_{\mathrm{DDQ}}$ | 187.80 | 187.80 |  |  |# Micron 

LPDDR4X/LPDDR4 SDRAM Product Specification

Table 10: LPDDR4 $\mathrm{I}_{\text {DD }}$ Parameters - Single Die (16Gb Dual-Channel Die)

| Symbol | Supply | $\mathrm{T}_{\mathrm{C}} / 4266 \mathrm{Mb} / \mathrm{s}$ |  | Unit | Note |
| :--: | :--: | :--: | :--: | :--: | :--: |
|  |  | $85^{\circ} \mathrm{C}$ | $95^{\circ} \mathrm{C}$ |  |  |
| IDD4W1 | $\mathrm{V}_{\mathrm{DD} 1}$ | 15.00 | 15.00 | mA | 2 |
| IDD4W2 | $\mathrm{V}_{\mathrm{DD} 2}$ | 300.00 | 300.00 |  |  |
| IDD4WQ | $\mathrm{V}_{\mathrm{DDQ}}$ | 1.50 | 1.50 |  |  |
| IDDS1 | $\mathrm{V}_{\mathrm{DD} 1}$ | 35.00 | 35.00 | mA |  |
| IDDS2 | $\mathrm{V}_{\mathrm{DD} 2}$ | 190.00 | 195.00 |  |  |
| IDDSQ | $\mathrm{V}_{\mathrm{DDQ}}$ | 1.50 | 1.50 |  |  |
| IDDSAB1 | $\mathrm{V}_{\mathrm{DD} 1}$ | 7.60 | 7.80 | mA |  |
| IDDSAB2 | $\mathrm{V}_{\mathrm{DD} 2}$ | 36.00 | 41.00 |  |  |
| IDDSABQ | $\mathrm{V}_{\mathrm{DDQ}}$ | 1.50 | 1.50 |  |  |
| IDDSPB1 | $\mathrm{V}_{\mathrm{DD} 1}$ | 6.00 | 6.70 | mA |  |
| IDDSPB2 | $\mathrm{V}_{\mathrm{DD} 2}$ | 36.00 | 41.00 |  |  |
| IDDSPBQ | $\mathrm{V}_{\mathrm{DDQ}}$ | 1.50 | 1.50 |  |  |

Notes: 1. Published $\mathrm{I}_{\mathrm{DD}}$ values except $\mathrm{I}_{\mathrm{DD} 4 \mathrm{RQ}}$ are the maximum $\mathrm{I}_{\mathrm{DD}}$ values considering the worst-case conditions of process, temperature, and voltage.
2. $\mathrm{BL}=16, \mathrm{DBI}$ disabled.
3. $\mathrm{I}_{\mathrm{DD} 4 \mathrm{RQ}}$ value is reference only. Typical value. $\mathrm{V}_{\mathrm{OH}}=0.5 \times \mathrm{V}_{\mathrm{DDQ}} ; \mathrm{T}_{\mathrm{C}}=25^{\circ} \mathrm{C}$
4. $\mathrm{I}_{\mathrm{DD}}$ values reflect dual-channel operation with the same pattern for each channel.
5. $\mathrm{V}_{\mathrm{DD} 2}=1.06-1.17 \mathrm{~V} ; \mathrm{V}_{\mathrm{DDQ}}=1.06-1.17 \mathrm{~V} ; \mathrm{V}_{\mathrm{DD} 1}=1.70-1.95 \mathrm{~V}$;

Table 11: $\mathrm{I}_{\text {DD6 }}$ Full-Array Self Refresh Current - Single Die (16Gb Dual-Channel Die)

| Temperature | Supply | Full-Array Self Refresh Current | Unit |
| :--: | :--: | :--: | :--: |
| $25^{\circ} \mathrm{C}$ | $\mathrm{V}_{\mathrm{DD} 1}$ | 0.65 | mA |
|  | $\mathrm{V}_{\mathrm{DD} 2}$ | 1.33 |  |
|  | $\mathrm{V}_{\mathrm{DDQ}}$ | 0.02 |  |
| $85^{\circ} \mathrm{C}$ | $\mathrm{V}_{\mathrm{DD} 1}$ | 5.00 | mA |
|  | $\mathrm{V}_{\mathrm{DD} 2}$ | 12.00 |  |
|  | $\mathrm{V}_{\mathrm{DDQ}}$ | 1.50 |  |
| $95^{\circ} \mathrm{C}$ | $\mathrm{V}_{\mathrm{DD} 1}$ | 6.50 | mA |
|  | $\mathrm{V}_{\mathrm{DD} 2}$ | 18.00 |  |
|  | $\mathrm{V}_{\mathrm{DDQ}}$ | 1.50 |  |

Notes: 1. $\mathrm{I}_{\mathrm{DD} 6} 25^{\circ} \mathrm{C}$ is the typical value in the distribution with nominal $\mathrm{V}_{\mathrm{DD}}$ and a reference-only value. $\mathrm{I}_{\mathrm{DD} 6} 85^{\circ} \mathrm{C}, \mathrm{I}_{\mathrm{DD} 6} 95^{\circ} \mathrm{C}$ is the maximum $\mathrm{I}_{\mathrm{DD}}$ guaranteed value considering the worst-case conditions of process, temperature, and voltage.
2. $\mathrm{I}_{\mathrm{DD}}$ values reflect dual-channel operation with the same pattern for each channel.
3. $\mathrm{V}_{\mathrm{DD} 2}=1.06-1.17 \mathrm{~V} ; \mathrm{V}_{\mathrm{DDQ}}=1.06-1.17 \mathrm{~V} ; \mathrm{V}_{\mathrm{DD} 1}=1.70-1.95 \mathrm{~V}$# General LPDDR4X Specification 

## Functional Description

The Mobile Low-Power DDR4 SDRAM (LPDDR4) is a high-speed CMOS, dynamic random-access memory internally configured with either 1 or 2 channels. Each channel is comprised of 16 DQs and 8 banks.

LPDDR4 uses a 2-tick, single-data-rate (SDR) protocol on the CA bus to reduce the number of input signals in the system. The term "2-tick" means that the command/address is decoded across two transactions, such that half of the command/address is captured with each of two consecutive rising edges of CK. The 6-bit CA bus contains command, address, and bank information. Some commands such as READ, WRITE, MASKED WRITE, and ACTIVATE require two consecutive 2-tick SDR commands to complete the instruction.

LPDDR4 uses a double-data-rate (DDR) protocol on the DQ bus to achieve high-speed operation. The DDR interface transfers two data bits to each DQ lane in one clock cycle and is matched to a $16 n$-prefetch DRAM architecture. A write/read access consists of a single $16 n$-bit-wide data transfer to/from the DRAM core and 16 corresponding $n$-bit-wide data transfers at the I/O pins.

Read and write accesses to the device are burst-oriented. Accesses start at a selected column address and continue for a programmed number of columns in a programmed sequence.

Accesses begin with the registration of an ACTIVATE command to open a row in the memory core, followed by a WRITE or READ command to access column data within the open row. The address and bank address (BA) bits registered by the ACTIVATE command are used to select the bank and row to be opened. The address and BA bits registered with the WRITE or READ command are used to select the bank and the starting column address for the burst access.

Prior to normal operation, the LPDDR4 SDRAM must be initialized. The following sections provide detailed information about device initialization, register definition, command descriptions and device operations.# SDRAM Addressing 

The table below includes all SDRAM addressing options defined by JEDEC. Under the Device Configuration heading near the beginning of this data sheet are addressing details for this product data sheet.

|  Micron Confidential and Proprietary | |
| --- | --- |
|  |

|  Memory Density (Per Die) | 4Gb | 6Gb | 8Gb | 12Gb | 16Gb | 24Gb | 32Gb  |
| --- | --- | --- | --- | --- | --- | --- | --- |
|  Memory density (per channel) | 2Gb | 3Gb | 4Gb | 6Gb | 8Gb | 12Gb | 16Gb  |
|  Configuration | 16Mb × 16DQ × 8 banks × 2 channels | 24Mb × 16DQ × 8 banks × 2 channels | 32Mb × 16DQ × 8 banks × 2 channels | 48Mb × 16DQ × 8 banks × 2 channels | 64Mb × 16DQ × 8 banks × 2 channels | 96Mb × 16DQ × 8 banks × 2 channels | 128Mb × 16DQ × 8 banks × 2 channels  |
|  Number of channels (per die) | 2 | 2 | 2 | 2 | 2 | 2 | 2  |
|  Number of banks (per channel) | 8 | 8 | 8 | 8 | 8 | 8 | 8  |
|  Array prefetch (bits, per channel) | 256 | 256 | 256 | 256 | 256 | 256 | 256  |
|  Number of rows (per channel) | 16,384 | 24,576 | 32,768 | 49,152 | 65,536 | 98,304 | 131,072  |
|  Number of columns (fetch boundaries) | 64 | 64 | 64 | 64 | 64 | 64 | 64  |
|  Page size (bytes) | 2048 | 2048 | 2048 | 2048 | 2048 | 2048 | 2048  |
|  Channel density (bits per channel) | 2,147,483,648 | 3,221,225,472 | 4,294,967,296 | 6,442,450,944 | 8,589,934,592 | 12,884,901,888 | 17,179,869,184  |
|  Total density (bits per die) | 4,294,967,296 | 6,442,450,944 | 8,589,934,592 | 12,884,901,888 | 17,179,869,184 | 25,769,803,776 | 34,359,738,368  |
|  Bank address | BA[2:0] | BA[2:0] | BA[2:0] | BA[2:0] | BA[2:0] | BA[2:0] | BA[2:0]  |
|  ×16 |  |  |  |  |  |  | |
|  Row add | R[13:0] | R[14:0] (R13 = 0 when R14 = 1) | R[14:0] | R[15:0] (R14 = 0 when R15 = 1) | R[15:0] | R[16:0] (R15 = 0 when R16 = 1) | R[16:0]  |
|  Col. add | C[9:0] | C[9:0] | C[9:0] | C[9:0] | C[9:0] | C[9:0] | C[9:0]  |
|  Burst starting address boundary | 64-bit | 64-bit | 64-bit | 64-bit | 64-bit | 64-bit | 64-bit  |



**LPDDR4X/LPDDR4 SDRAM**

**General LPDDR4X Specification**# Micron Confidential and Proprietary



## LPDDR4X/LPDDR4 SDRAM

### General LPDDR4X Specification

|  Memory Density (Per Die) | 2Gb | 3Gb | 4Gb | 6Gb | 8Gb | 12Gb | 16Gb  |
| --- | --- | --- | --- | --- | --- | --- | --- |
|  Memory density (per channel) | 2Gb | 3Gb | 4Gb | 6Gb | 8Gb | 12Gb | 16Gb  |
|  Configuration | 16Mb × 16 DQ × 8 banks | 24Mb × 16 DQ × 8 banks | 32Mb × 16 DQ × 8 banks | 48Mb × 16 DQ × 8 banks | 64Mb × 16 DQ × 8 banks | 96Mb × 16 DQ × 8 banks | 128Mb × 16 DQ × 8 banks  |
|  Number of channels (per die) | 1 | 1 | 1 | 1 | 1 | 1 | 1  |
|  Number of banks (per channel) | 8 | 8 | 8 | 8 | 8 | 8 | 8  |
|  Array prefetch (bits, per channel) | 256 | 256 | 256 | 256 | 256 | 256 | 256  |
|  Number of rows (per channel) | 16,384 | 24,576 | 32,768 | 49,152 | 65,536 | 98,304 | 131,072  |
|  Number of columns (fetch boundaries) | 64 | 64 | 64 | 64 | 64 | 64 | 64  |
|  Page size (bytes) | 2048 | 2048 | 2048 | 2048 | 2048 | 2048 | 2048  |
|  Channel density (bits per channel) | 2,147,483,648 | 3,221,225,472 | 4,294,967,296 | 6,442,450,944 | 8,589,934,592 | 12,884,901,888 | 17,179,869,184  |
|  Total density (bits per die) | 2,147,483,648 | 3,221,225,472 | 4,294,967,296 | 6,442,450,944 | 8,589,934,592 | 12,884,901,888 | 17,179,869,184  |
|  Bank address | BA[2:0] | BA[2:0] | BA[2:0] | BA[2:0] | BA[2:0] | BA[2:0] | BA[2:0]  |
|  16 |  |  |  |  |  |  | |
|  Row add | R[13:0] | R[14:0] (R13 = 0 when R14 = 1) | R[14:0] | R[15:0] (R14 = 0 when R15 = 1) | R[15:0] | R[16:0] (R15 = 0 when R16 = 1) | R[16:0]  |
|  Col. add | C[9:0] | C[9:0] | C[9:0] | C[9:0] | C[9:0] | C[9:0] | C[9:0]  |
|  Burst starting address boundary | 64-bit | 64-bit | 64-bit | 64-bit | 64-bit | 64-bit | 64-bit  |

**Notes:** 1. The lower two column addresses (C[1:0]) are assumed to be zero and are not transmitted on the CA bus. 2. Row and column address values on the CA bus that are not used for a particular density should be at valid logic levels. 3. For non-binary memory densities, only a quarter of the row address space is invalid. When the MSB address bit is HIGH, then the MSB - 1 address bit must be LOW.# Simplified Bus Interface State Diagram 

The state diagram provides a simplified illustration of the bus interface, supported state transitions, and the commands that control them. For a complete description of device behavior, use the information provided in the state diagram with the truth tables and timing specifications. The truth tables describe device behavior and applicable restrictions when considering the actual state of all banks. For command descriptions, see the Commands and Timing section.

## Figure 13: Simplified State Diagram



Notes: 1. From the self refresh state, the device can enter power-down, MRR, MRW, or any of the training modes initiated with the MPC command. See the Self Refresh section.
2. All banks are precharged in the idle state.
3. In the case of using an MRW command to enter a training mode, the state machine will not automatically return to the idle state at the conclusion of training. See the applicable training section for more information.4. In the case of an MPC command to enter a training mode, the state machine may not automatically return to the idle state at the conclusion of training. See the applicable training section for more information.
5. This diagram is intended to provide an overview of the possible state transitions and commands to control them; however, it does not contain the details necessary to operate the device. In particular, situations involving more than one bank are not captured in complete detail.
6. States that have an "automatic return" and can be accessed from more than one prior state (that is, MRW from either idle or active states) will return to the state where they were initiated (that is, MRW from idle will return to idle).
7. The RESET pin can be asserted from any state and will cause the device to enter the reset state. The diagram shows RESET applied from the power-on and idle states as an example, but this should not be construed as a restriction on RESET.
8. MRW commands from the active state cannot change operating parameters of the device that affect timing. Mode register fields which may be changed via MRW from the active state include: MR1-OP[3:0], MR1-OP[7], MR3-OP[7:6], MR10-OP[7:0], MR11-OP[7:0], MR13-OP[5], MR15-OP[7:0], MR16-OP[7:0], MR17-OP[7:0], MR20-OP[7:0], and MR22-OP[4:0].

Figure 14: Simplified State Diagram
a) FIFO-Based Write/Read Timing


b) Read DQ Calibration

c) ZQCAL Start

d) ZQCAL Latch

Power-Up and Initialization
To ensure proper functionality for power-up and reset initialization, default values for the MR settings are provided in the table below.

Table 14: Mode Register Default Settings

| Item | Mode Register Setting | Default Setting | Description |
| :-- | :--: | :--: | :--: |
| FSP-OP/WR | MR13 OP[7:6] | 00b | FSP-OP/WR[0] are enabled |
| WLS | MR2 OP[6] | 0b | WRITE latency set A is selected |
| WL | MR2 OP[5:3] | 000b | $\mathrm{WL}=4$ |
| RL | MR2 OP[2:0] | 000b | $\mathrm{RL}=6, n \mathrm{RTP}=8$ |
| $n$ WR | MR1 OP[6:4] | 000b | $n \mathrm{WR}=6$ |# Micron 

LPDDR4X/LPDDR4 SDRAM General LPDDR4X Specification

## Table 14: Mode Register Default Settings (Continued)

| Item | Mode Register Setting | Default Setting | Description |
| :-- | :--: | :--: | :-- |
| DBI-WR/RD | MR3 OP[7:6] | 00b | Write and read DBI are dis- <br> abled |
| CA ODT | MR11 OP[6:4] | 000b | CA ODT is disabled |
| DQ ODT | MR11 OP[2:0] | 000b | DQ ODT is disabled |
| V $_{\text {REF(CA) }}$ setting | MR12 OP[6] | 1b | V $_{\text {REF(CA) }}$ range[1] is enabled |
| V $_{\text {REF(CA) }}$ value | MR12 OP[5:0] | 011101 b | Range1: 50.3\% of V $_{\text {DDQ }}$ |
| V $_{\text {REF(DQ) }}$ setting | MR14 OP[6] | 1b | V $_{\text {REF(DQ) }}$ range[1] enabled |
| V $_{\text {REF(DQ) }}$ value | MR14 OP[5:0] | 011101 b | Range1: 50.3\% of V $_{\text {DDQ }}$ |

The following sequence must be used to power up the device. Unless specified otherwise, this procedure is mandatory. The power-up sequence of all channels must proceed simultaneously.

## Voltage Ramp

1. While applying power (after Ta), RESET_n should be held LOW ( $\leq 0.2 \times \mathrm{V}_{\mathrm{DD} 2}$ ), and all other inputs must be between $\mathrm{V}_{\mathrm{IL}, \min }$ and $\mathrm{V}_{\mathrm{IH}, \max }$. The device outputs remain at High-Z while RESET_n is held LOW. Power supply voltage ramp requirements are provided in the table below. $\mathrm{V}_{\mathrm{DD} 1}$ must ramp at the same time or earlier than $\mathrm{V}_{\mathrm{DD} 2} . \mathrm{V}_{\mathrm{DD} 2}$ must ramp at the same time or earlier than $\mathrm{V}_{\mathrm{DDQ}}$.

## Table 15: Voltage Ramp Conditions

| After... | Applicable Conditions |
| :-- | :-- |
| Ta is reached | $\mathrm{V}_{\mathrm{DD} 1}$ must be greater than $\mathrm{V}_{\mathrm{DD} 2}$ |
|  | $\mathrm{V}_{\mathrm{DD} 2}$ must be greater than $\mathrm{V}_{\mathrm{DDQ}}-200 \mathrm{mV}$ |

Notes: 1. Ta is the point when any power supply first reaches 300 mV .
2. Voltage ramp conditions in above table apply between Ta and power-off (controlled or uncontrolled).
3. Tb is the point at which all supply and reference voltages are within their defined operating ranges.
4. Power ramp duration ${ }^{1}$ INIT0 (Tb-Ta) must not exceed 20 ms .
5. The voltage difference between any $\mathrm{V}_{\mathrm{SS}}$ and $\mathrm{V}_{\mathrm{SSQ}}$ must not exceed 100 mV .
2. Following completion of the voltage ramp ( Tb ), RESET_n must be held LOW for ${ }^{1}$ INIT1. DQ, DMI, DQS_t, and DQS_c voltage levels must be between $\mathrm{V}_{\mathrm{SSQ}}$ and $\mathrm{V}_{\mathrm{DDQ}}$ during voltage ramp to avoid latch-up. CK_t and CK_c, CS, and CA input levels must be between $\mathrm{V}_{\mathrm{SS}}$ and $\mathrm{V}_{\mathrm{DD} 2}$ during voltage ramp to avoid latch-up. Voltage ramp power supply requirements are provided in the table below.
3. Beginning at Tb , RESET_n must remain LOW for at least ${ }^{1}$ INIT1(Tc), after which RESET_n can be de-asserted to HIGH(Tc). At least 10ns before CKE de-assertion, CKE is required to be set LOW. All other input signals are "Don't Care."Figure 15: Voltage Ramp and Initialization Sequence


Note: 1. Training is optional and may be done at the system designer's discretion. The order of training may be different than what is shown here.
4. After RESET_n is de-asserted(Tc), wait at least ${ }^{1} \mathrm{INIT} 3$ before activating CKE. CK_t, CK_c must be started and stabilized for ${ }^{1} \mathrm{INIT} 4$ before CKE goes active(Td). CS must remain LOW when the controller activates CKE.
5. After CKE is set to HIGH, wait a minimum of ${ }^{1} \mathrm{INIT5}$ to issue any MRR or MRW commands(Te). For MRR and MRW commands, the clock frequency must be within the range defined for ${ }^{1} \mathrm{CKb}$. Some AC parameters (for example, ${ }^{1} \mathrm{DQSCK}$ ) could have relaxed timings (such as ${ }^{1} \mathrm{DQSCKb}$ ) before the system is appropriately configured.
6. After completing all MRW commands to set the pull-up, pull-down, and Rx termination values, the controller can issue the ZQCAL START command to the memory(Tf). This command is used to calibrate the $\mathrm{V}_{\mathrm{OH}}$ level and the output impedance over process, voltage, and temperature. In systems where more than one device share one external ZQ resistor, the controller must not overlap the ZQ calibration sequence of each device. The ZQ calibration sequence is completed after ${ }^{1} \mathrm{ZQCAL}(\mathrm{Tg})$. The ZQCAL LATCH command must be issued to update the DQ drivers and DQ + CA ODT to the calibrated values.
7. After ${ }^{1}$ ZQLAT is satisfied (Th), the command bus (internal $\mathrm{V}_{\mathrm{REF}(\mathrm{CA})}, \mathrm{CS}$, and CA ) should be trained for high-speed operation by issuing an MRW command (command bus training mode). This command is used to calibrate the device's internal $\mathrm{V}_{\mathrm{REF}}$ and align CS/CA with CK for high-speed operation. The device will power-up with receivers configured for low-speed operations and with $\mathrm{V}_{\mathrm{REF}(\mathrm{CA})}$ set to a default factory setting. Normal device operation at clock speeds higher than ${ }^{1} \mathrm{CKb}$ may not be possible until command bus training is complete. The command bus training MRW command uses the CA bus as inputs for the calibration data stream, and it outputs the results asynchronously on the DQ bus. See command bus training in the MRW section for information on how to enter/exit the training mode.
8. After command bus training, the controller must perform write leveling. Write leveling mode is enabled when MR2 OP[7] is HIGH(Ti). See the Write Leveling section for a detailed description of the write leveling entry and exit sequence. In write leveling mode, the controller adjusts write DQS timing to the point where the device recognizes the start of write DQ data burst with desired WRITE latency.9. After write leveling, the DQ bus (internal $\mathrm{V}_{\mathrm{REF}(\mathrm{DQ})}$, DQS, and DQ) should be trained for high-speed operation using the MPC TRAINING commands and by issuing MRW commands to adjust $\mathrm{V}_{\mathrm{REF}(\mathrm{DQ})}$. The device will power-up with receivers configured for low-speed operations and with $\mathrm{V}_{\mathrm{REF}(\mathrm{DQ}}$ ) set to a default factory setting. Normal device operation at clock speeds higher than ${ }^{1} \mathrm{CKb}$ should not be attempted until DQ bus training is complete. The MPC[READ DQ CALIBRATION] command is used together with MPC[READ-FIFO] or MPC[WRITE-FIFO] commands to train the DQ bus without disturbing the memory array contents. See the DQ Bus Training section for more information on the DQ bus training sequence.
10. At Tk , the device is ready for normal operation and is ready to accept any valid command. Any mode registers that have not previously been configured for normal operation should be written at this time.

Table 16: Initialization Timing Parameters

| Parameter | Min | Max | Unit | Comment |
| :-- | :--: | :--: | :--: | :-- |
| ${ }^{1}$ INIT0 | - | 20 | ms | Maximum voltage ramp time |
| ${ }^{1}$ INIT1 | 200 | - | $\mu \mathrm{s}$ | Minimum RESET_n LOW time after completion of voltage <br> ramp |
| ${ }^{1}$ INIT2 | 10 | - | ns | Minimum CKE LOW time before RESET_n goes HIGH |
| ${ }^{1}$ INIT3 | 2 | - | ms | Minimum CKE LOW time after RESET_n goes HIGH |
| ${ }^{1}$ INIT4 | 5 | - | ${ }^{1} \mathrm{CK}$ | Minimum stable clock before first CKE HIGH |
| ${ }^{1}$ INIT5 | 2 | - | $\mu \mathrm{s}$ | Minimum idle time before first MRW/MRR command |
| ${ }^{1} \mathrm{CKb}$ | Note $^{1,2}$ | Note $^{1,2}$ | ns | Clock cycle time during boot |

Notes: 1. Minimum ${ }^{1} \mathrm{CKb}$ guaranteed by DRAM test is 18 ns .
2. The system may boot at a higher frequency than dictated by minimum ${ }^{1} \mathrm{CKb}$. The higher boot frequency is system dependent.

# Reset Initialization with Stable Power 

The following sequence is required for RESET at no power interruption initialization.

1. Assert RESET_n below $0.2 \times \mathrm{V}_{\mathrm{DD} 2}$ anytime when reset is needed. RESET_n needs to be maintained for minimum ${ }^{1} \mathrm{PW}$ RESET. CKE must be pulled LOW at least 10ns before de-asserting RESET_n.
2. Repeat steps $4-10$ in Voltage Ramp section.

Table 17: Reset Timing Parameter

| Parameter | Value |  | Unit | Comment |
| :--: | :--: | :--: | :--: | :--: |
|  | Min | Max |  |  |
| ${ }^{1}$ PW_RESET | 100 | - | ns | Minimum RESET_n LOW time for reset initialization with stable power |

## Power-Off Sequence

## Controlled Power-Off

While powering off, CKE must be held LOW $\left(\leq 0.2 \times \mathrm{V}_{\mathrm{DD} 2}\right)$; all other inputs must be between $\mathrm{V}_{\mathrm{IL}, \min }$ and $\mathrm{V}_{\mathrm{IH}, \text { max }}$. The device outputs remain at High-Z while CKE is held LOW.# Micron 

DQ, DMI, DQS_t, and DQS_c voltage levels must be between $\mathrm{V}_{\mathrm{SSQ}}$ and $\mathrm{V}_{\mathrm{DDQ}}$ during the power-off sequence to avoid latch-up. CK_t, CK_c, CS, and CA input levels must be between $\mathrm{V}_{\mathrm{SS}}$ and $\mathrm{V}_{\mathrm{DD} 2}$ during the power-off sequence to avoid latch-up.
Tx is the point where any power supply drops below the minimum value specified in the minimum DC Operating Condition.
Tz is the point where all power supplies are below 300 mV . After Tz , the device is powered off.

## Table 18: Power Supply Conditions

The voltage difference between $\mathrm{V}_{\mathrm{SS}}$ and $\mathrm{V}_{\mathrm{SSQ}}$ must not exceed 100 mV

| Between... | Applicable Conditions |
| :-- | :-- |
| Tx and Tz | $\mathrm{V}_{\mathrm{DD} 1}$ must be greater than $\mathrm{V}_{\mathrm{DD} 2}$ |
|  | $\mathrm{V}_{\mathrm{DD} 2}$ must be greater than $\mathrm{V}_{\mathrm{DDQ}}-200 \mathrm{mV}$ |

## Uncontrolled Power-Off

When an uncontrolled power-off occurs, the following conditions must be met:

- At Tx, when the power supply drops below the minimum values specified in the Recommended DC Operating Conditions table, all power supplies must be turned off and all power supply current capacity must be at zero, except for any static charge remaining in the system.
- After Tz (the point at which all power supplies first reach 300 mV ), the device must power off. During this period, the relative voltage between power supplies is uncontrolled. $\mathrm{V}_{\mathrm{DD} 1}$ and $\mathrm{V}_{\mathrm{DD} 2}$ must decrease with a slope lower than $0.5 \mathrm{~V} / \mu \mathrm{s}$ between Tx and Tz .

An uncontrolled power-off sequence can occur a maximum of 400 times over the life of the device.
Table 19: Power-Off Timing

| Parameter | Symbol | Min | Max | Unit |
| :-- | :--: | :--: | :--: | :--: |
| Power-off ramp time | ${ }^{\dagger} \mathrm{POFF}$ | - | 2 | sec |# LPDDR4X/LPDDR4 SDRAM General LPDDR4X Specification 

## Mode Registers

## Mode Register Assignments and Definitions

Mode register definitions are provided in the Mode Register Assignments table. In the access column of the table, R indicates read-only; W indicates write-only; R/W indicates read- or write-capable or enabled. The MRR command is used to read from a register. The MRW command is used to write to a register.

Table 20: Mode Register Assignments

| MR\# | MA[5:0] | Function | Access | OP7 | OP6 | OP5 | OP4 | OP3 | OP2 | OP1 | OP0 |
| :--: | :--: | :--: | :--: | :--: | :--: | :--: | :--: | :--: | :--: | :--: | :--: |
| 0 | 00 h | Device info | R | RFU |  |  | RZQI |  | RFM support | Latency mode | REF |
| 1 | 01 h | Device feature 1 | W | RD-PST | nWR (for AP) |  |  | RD-PRE | WR-PRE | BL |  |
| 2 | 02 h | Device feature 2 | W | WR Lev | WLS | WL |  |  | RL |  |  |
| 3 | 03 h | I/O config-1 | W | DBI-WR | DBI-RD | PDDS |  |  | PPRP | WR-PST | PU-CAL |
| 4 | 04 h | Refresh and training | R/W | TUF | Thermal offset |  | PPRE | SR <br> abort | Refresh rate |  |  |
| 5 | 05 h | Basic config-1 | R | Manufacturer ID |  |  |  |  |  |  |  |
| 6 | 06 h | Basic config-2 | R | Revision ID1 |  |  |  |  |  |  |  |
| 7 | 07 h | Basic config-3 | R | Revision ID2 |  |  |  |  |  |  |  |
| 8 | 08 h | Basic config-4 | R | I/O width |  |  | Density |  |  | Type |  |
| 9 | 09 h | Test mode | W | Vendor-specific test mode |  |  |  |  |  |  |  |
| 10 | 0Ah | I/O calibration | W | RFU |  |  |  |  |  |  | ZQ RST |
| 11 | 0Bh | ODT | W | RFU | CA ODT |  |  | RFU | DQ ODT |  |  |
| 12 | 0 Ch | $\mathrm{V}_{\text {REF(CA) }}$ | R/W | RFU | VR $_{\text {CA }}$ | $\mathrm{V}_{\text {REF(CA) }}$ |  |  |  |  |  |
| 13 | 0Dh | Register control | W | FSP-OP | FSP-WR | DMD | RRO | VRCG | VRO | RPT | CBT |
| 14 | 0Eh | $\mathrm{V}_{\text {REF(DQ) }}$ | R/W | RFU | VR $_{\text {DQ }}$ | $\mathrm{V}_{\text {REF(DQ) }}$ |  |  |  |  |  |
| 15 | 0Fh | DQI-LB | W | Lower-byte invert register for DQ calibration |  |  |  |  |  |  |  |
| 16 | 10 h | PASR_Bank | W | PASR bank mask |  |  |  |  |  |  |  |
| 17 | 11 h | PASR_Seg | W | PASR segment mask |  |  |  |  |  |  |  |
| 18 | 12 h | IT-LSB | R | DQS oscillator count - LSB |  |  |  |  |  |  |  |
| 19 | 13 h | IT-MSB | R | DQS oscillator count - MSB |  |  |  |  |  |  |  |
| 20 | 14 h | DQI-UB | W | Upper-byte invert register for DQ calibration |  |  |  |  |  |  |  |
| 21 | 15 h | Vendor use | W | RFU |  |  |  |  |  |  |  |
| 22 | 16 h | ODT feature 2 | W | ODTD for x8_2ch |  | ODTD <br> -CA | ODTE <br> -CS | ODTE <br> -CK | SoC ODT |  |  |
| 23 | 17 h | DQS oscillator stop | W | DQS oscillator run-time setting |  |  |  |  |  |  |  |# Micron 

LPDDR4X/LPDDR4 SDRAM General LPDDR4X Specification

Table 20: Mode Register Assignments (Continued)

| MR\# | MA[5:0] | Function | Access | OP7 | OP6 | OP5 | OP4 | OP3 | OP2 | OP1 | OP0 |
| :--: | :--: | :--: | :--: | :--: | :--: | :--: | :--: | :--: | :--: | :--: | :--: |
| 24 | 18 h | TRR control when MR0 OP2 $=0 b$ | R/W | TRR mode | TRR mode BAn |  |  | Unltd <br> MAC | MAC value |  |  |
|  |  | RFM control when MR0 OP2 $=1 b$ | R | RAAMMT |  |  |  |  | RAAIMT |  |  | RFM |
| 25 | 19 h | PPR resources | R | B7 | B6 | B5 | B4 | B3 | B2 | B1 | B0 |
| 26-29 | 1Ah-1Dh | - | - | Reserved for future use |  |  |  |  |  |  |  |
| 30 | 1Eh | Reserved for test | W | SDRAM will ignore |  |  |  |  |  |  |  |
| 31 | 1 Fh | - | - | Reserved for future use |  |  |  |  |  |  |  |
| 32 | 20 h | DQ calibration pattern A | W | See DQ calibration section |  |  |  |  |  |  |  |
| $33-35$ | 21h-23h | Do not use | - | Do not use |  |  |  |  |  |  |  |
| 36 | 24 h | RAADEC | R | RFU |  |  |  |  |  | RAADEC |  |
| $37-38$ | 25h-26h | Do not use | - | Do not use |  |  |  |  |  |  |  |
| 39 | 27 h | Reserved for test | W | SDRAM will ignore |  |  |  |  |  |  |  |
| 40 | 28 h | DQ calibration pattern B | W | See DQ calibration section |  |  |  |  |  |  |  |
| $41-47$ | 29h-2Fh | Do not use | - | Do not use |  |  |  |  |  |  |  |
| $48-63$ | 30h-3Fh | Reserved | - | Reserved for future use |  |  |  |  |  |  |  |

Notes: 1. RFU bits must be set to 0 during MRW commands.
2. RFU bits are read as 0 during MRR commands.
3. All mode registers that are specified as RFU or write-only shall return undefined data when read via an MRR command.
4. RFU mode registers must not be written.
5. Writes to read-only registers will not affect the functionality of the device.
6. Notes $1-5$ apply to entire table.

Table 21: MR0 Device Feature 0 (MA[5:0] = 00h)

| OP7 | OP6 | OP5 | OP4 | OP3 | OP2 | OP1 | OP0 |
| :--: | :--: | :--: | :--: | :--: | :--: | :--: | :--: |
| RFU |  |  | RZQI |  | RFM support | Latency mode | REF |

Table 22: MR0 Op-Code Bit Definitions

| Register Information | Type | OP | Definition | Notes |
| :-- | :-- | :-- | :-- | :-- |
| Refresh mode | Read-only | OP[0] | 0b: Both legacy and modified refresh mode supported <br> 1b: Only modified refresh mode supported |  |
| Latency mode | Read-only | OP[1] | 0b: Device supports normal latency <br> 1b: Device supports byte mode latency | 5,6 |
| RFM support | Read-only | OP[2] | 0b: TRR is supported <br> 1b: RFM is supported |  |# Micron 

LPDDR4X/LPDDR4 SDRAM General LPDDR4X Specification

Table 22: MR0 Op-Code Bit Definitions (Continued)

| Register Information | Type | OP | Definition | Notes |
| :--: | :--: | :--: | :--: | :--: |
| Built-in self-test for RZQ information | Read-only | OP[4:3] | 00b: RZQ self-test not supported <br> 01b: ZQ may connect to $\mathrm{V}_{\text {SSQ }}$ or float <br> 10b: ZQ may short to $\mathrm{V}_{\text {DDQ }}$ <br> 11b: ZQ pin self-test completed, no error condition detected (ZQ may not connect to $\mathrm{V}_{\text {SSQ }}$, float, or short to $\mathrm{V}_{\text {DDQ }}$ ) | $1-4$ |

Notes: 1. RZQI MR value, if supported, will be valid after the following sequence:

- Completion of MPC|ZQCAL START| command to either channel
- Completion of MPC|ZQCAL LATCH| command to either channel then ${ }^{t} Z Q L A T$ is satisfied

RZQI value will be lost after reset.
2. If $Z Q$ is connected to $V_{S S Q}$ to set default calibration, OP[4:3] must be set to 01 b . If $Z Q$ is not connected to $V_{S S Q}$, either $O P[4: 3]=01 b$ or $O P[4: 3]=10 b$ might indicate a $Z Q$ pin assembly error. It is recommended that the assembly error be corrected.
3. In the case of possible assembly error, the device will default to factory trim settings for $R_{O N}$, and will ignore ZQ CALIBRATION commands. In either case, the device may not function as intended.
4. If the ZQ pin self-test returns OP[4:3] = 11b, the device has detected a resistor connected to the ZQ pin. However, this result cannot be used to validate the ZQ resistor value or that the ZQ resistor meets the specified limits (that is, $240 \Omega \pm 1 \%$ ).
5. See byte mode addendum spec for byte mode latency details.
6. Byte mode latency for $2 \mathrm{Ch} . \times 16$ device is only allowed when it is stacked in a same package with byte mode device.

Table 23: MR1 Device Feature 1 (MA[5:0] = 01h)

| OP7 | OP6 | OP5 | OP4 | OP3 | OP2 | OP1 | OP0 |
| :--: | :--: | :--: | :--: | :--: | :--: | :--: | :--: |
| RD-PST | nWR (for AP) |  |  | RD-PRE | WR-PRE | BL |  |

Table 24: MR1 Op-Code Bit Definitions

| Feature | Type | OP | Definition | Notes |
| :--: | :--: | :--: | :--: | :--: |
| BL <br> Burst length | Write-only | OP[1:0] | 00b: BL = 16 sequential (default) <br> 01b: BL = 32 sequential <br> 10b: BL = 16 or 32 sequential (on-the-fly) <br> 11b: Reserved | 1 |
| WR-PRE <br> Write preamble length | Write-only | OP[2] | 0b: Reserved <br> 1b: WR preamble $=2 \times{ }^{\mathrm{t}} \mathrm{CK}$ | 5,6 |
| RD-PRE <br> Read preamble type | Write-only | OP[3] | 0b: RD preamble = Static (default) <br> 1b: RD preamble = Toggle | $3,5,6$ |# Micron 

LPDDR4X/LPDDR4 SDRAM General LPDDR4X Specification

Table 24: MR1 Op-Code Bit Definitions (Continued)

| Feature | Type | OP | Definition | Notes |
| :--: | :--: | :--: | :--: | :--: |
| $n$ WR <br> Write-recovery for AUTO PRECHARGE command | Write-only | OP[6:4] | 000b: $n \mathrm{WR}=6$ (default) <br> 001b: $n \mathrm{WR}=10$ <br> 010b: $n \mathrm{WR}=16$ <br> 011b: $n \mathrm{WR}=20$ <br> 100b: $n \mathrm{WR}=24$ <br> 101b: $n \mathrm{WR}=30$ <br> 110b: $n \mathrm{WR}=34$ <br> 111b: $n \mathrm{WR}=40$ | $2,5,6$ |
| RD-PST <br> Read postamble length | Write-only | OP[7] | 0b: RD postamble $=0.5 \times{ }^{1} \mathrm{CK}$ (default) <br> 1b: RD postamble $=1.5 \times{ }^{1} \mathrm{CK}$ | $4,5,6$ |

Notes: 1. Burst length on-the-fly can be set to either $B L=16$ or $B L=32$ by setting the $B L$ bit in the command operands. See the Command Truth Table.
2. The programmed value of $n$ WR is the number of clock cycles the device uses to determine the starting point of an internal precharge after a write burst with auto precharge (AP) enabled. See Frequency Ranges for RL, WL, and $n$ WR Settings table.
3. For READ operations, this bit must be set to select between a toggling preamble and a non-toggling preamble (see the Preamble section).
4. OP[7] provides an optional read postamble with an additional rising and falling edge of DQS_t. The optional postamble cycle is provided for the benefit of certain memory controllers.
5. There are two physical registers assigned to each bit of this MR parameter: designated set point 0 and set point 1. Only the registers for the set point determined by the state of the FSP-WR bit (MR13 OP[6]) will be written to with an MRW command to this MR address.
6. There are two physical registers assigned to each bit of this MR parameter: designated set point 0 and set point 1. The device will operate only according to the values stored in the registers for the active set point, that is, the set point determined by the state of the FSP-OP bit (MR13 OP[7]). The values in the registers for the inactive set point will be ignored by the device and may be changed without affecting device operation.Micron Confidential and Proprietary

Micron Technology, Inc. reserves the right to change products or specifications without notice.

Micron Technology, Inc. All rights reserved.

1.     1.         1.  2.  3.  4.  5.  6.  7.  8.  9.  10.  11.  12.  13.  14.  15.  16.  17.  18.  19.  20.  21.  22.  23.  24.  25.  26.  27.  28.  29.  30.  31.  32.

1.     1.         1.  2.  3.  4.  5.  6.  7.  8.  9.  10.  11.  12.  13.  14.  15.  16.  17.  18.  19.  20.  21.  22.  23.  24.  25.  26.  27.  28.  29.  30.  31.  32.

1.     1.         1.  2.  3.  4.  5.  6.  7.  8.  9.  10.  11.  12.  13.  14.  15.  16.  17.  18.  19.  20.  21.  22.  23.  24.  25.  26.  27.  28.  29.  30.  31.  32.

1.     1.         1.  2.  3.  4.  5.  6.  7.  8.  9.  10.  11.  12.  13.  14.  15.  16.  17.  18.  19.  20.  21.  22.  23.  24.  25.  26.  27.  28.  29.  30.  31.  32.

1.     1.         1.  2.  3.  4.  5.  6.  7.  8.  9.  10.  11.  12.  13.  14.  15.  16.  17.  18.  19.  20.  21.  22.  23.  24.  25.  26.  27.  28.  29.  30.  31.  32.

1.     1.         1.  2.  3.  4.  5.  6.  7.  8.  9.  10.  11.  12.  13.  14.  15.  16.  17.  18.  19.  20.  21.  22.  23.  24.  25.  26.  27.  28.  29.  30.  31.  32.

1.     1.         1.  2.  3.  4.  5.  6.  7.  8.  9.  10.  11.  12.  13.  14.  15.  16.  17.  18.  19.  20.  21.  22.  23.  24.  25.  26.  27.  28.  29.  30.  31.  32.

1.     1.         1.  2.  3.  4.  5.  6.  7.  8.  9.  10.  11.  12.  13.  14.  15.  16.  17.  18.  19.  20.  21.  22.  23.  24.  25.  26.  27.  28.  29.  30.  31.  32.

1.     1.         1.  2.  3.  4.  5.  6.  7.  8.  9.  10.  11.  12.  13.  14.  15.  16.  17.  18.  19.  20.  21.  22.  23.  24.  25.  26.  27.  28.  29.  30.  31.  32.

1.     1.         1.  2.  3.  4.  5.  6.  7.  8.  9.  10.  11.  12.  13.  14.  15.  16.  17.  18.  19.  20.  21.  22.  23.  24.  25.  26.  27.  28.  29.  30.  31.  32.

1.     1.         1.  2.  3.  4.  5.  6.  7.  8.  9.  10.  11.  12.  13.  14.  15.  16.  17.  18.  19.  20.  21.  22.  23.  24.  25.  26.  27.  28.  29.  30.  31.  32.

1.     1.         1.  2.  3.  4.  5.  6.  7.  8.  9.  10.  11.  12.  13.  14.  15.  16.  17.  18.  19.  20.  21.  22.  23.  24.  25.  26.  27.  28.  29.  30.  31.  32.

1.     1.         1.  2.  3.  4.  5.  6.  7.  8.  9.  10.  11.  12.  13.  14.  15.  16.  17.  18.  19.  20.  21.  22.  23.  24.  25.  26.  27.  28.  29.  30.  31.  32.

1.     1.         1.  2.  3.  4.  5.  6.  7.  8.  9.  10.  11.  12.  13.  14.  15.  16.  17.  18.  19.  20.  21.  22.  23.  24.  25.  26.  27.  28.  29.  30.  31.  32.

1.     1.         1.  2.  3.  4.  5.  6.  7.  8.  9.  10.  11.  12.  13.  14.  15.  16.  17.  18.  19.  20.  21.  22.  23.  24.  25.  26.  27.  28.  29.  30.  31.  32.

1.     1.         1.  2.  3.  4.  5.  6.  7.  8.  9.  10.  11.  12.  13.  14.  15.  16.  17.  18.  19.  20.  21.  22.  23.  24.  25.  26.  27.  28.  29.  30.  31.  32.

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

1.     1.         1.  2.  3.  4.  5.  6.  7.  8.  9.  10.  11.  12.  13.  14.  15.  16.  17.  18.  19.  20.  21.  22.  23.  24.  25.  26.  27.  28.  29.  30.  31.  32.



|  C4 | C3 | C2 | C1 | C0 | 1 | 2 | 3 | 4 | 5 | 6 | 7 | 8 | 9 | 10 | 11 | 12 | 13 | 14 | 15 | 16 | 17 | 18 | 19 | 20 | 21 | 22 | 23 | 24 | 25 | 26 | 27 | 28 | 29 | 30 | 31 | 32  |
| --- | --- | --- | --- | --- | --- | --- | --- | --- | --- | --- | --- | --- | --- | --- | --- | --- | --- | --- | --- | --- | --- | --- | --- | --- | --- | --- | --- | --- | --- | --- | --- | --- | --- | --- | --- | --- |
|  16-Bit WRITE Operation |  |  |  |  |  |  |  |  |  |  |  |  |  |  |  |  |  |  |  |  |  |  |  |  |  |  |  |  |  |  |  |  |  |  |  | |
|  V | 0 | 0 | 0 | 0 | 0 | 1 | 2 | 3 | 4 | 5 | 6 | 7 | 8 | 9 | A | B | C | D | E | F |  |  |  |  |  |  |  |  |  |  |  |  |  |  |  | |
|  32-Bit WRITE Operation |  |  |  |  |  |  |  |  |  |  |  |  |  |  |  |  |  |  |  |  |  |  |  |  |  |  |  |  |  |  |  |  |  |  |  | |
|  0 | 0 | 0 | 0 | 0 | 0 | 1 | 2 | 3 | 4 | 5 | 6 | 7 | 8 | 9 | A | B | C | D | E | F | 10 | 11 | 12 | 13 | 14 | 15 | 16 | 17 | 18 | 19 | 1A | 1B | 1C | 1D | 1E | 1F  |

**Notes:** 1. C[1:0] are not present on the CA bus; they are implied to be zero. 2. The starting burst address is on 256-bit (16n) boundaries for burst length 16. 3. The starting burst address is on 512-bit (32n) boundaries for burst length 32. 4. C[3:2] must be set to 0 for all WRITE operations.Table 27: MR2 Device Feature 2 (MA[5:0] = 02h)

|  OP7 | OP6 | OP5 | OP4 | OP3 | OP2 | OP1 | OP0  |
| --- | --- | --- | --- | --- | --- | --- | --- |
|  WR Lev | WLS |  | WL |  |  | RL | |

Table 28: MR2 Op-Code Bit Definitions

|  Feature | Type | OP | Definition | Notes  |
| --- | --- | --- | --- | --- |
|  RL
READ latency | Write-
only | OP[2:0] | RL and $n$ RTP for DBI-RD disabled (MR3 OP[6] = 0b)
000b: RL $=6, n$ RTP $=8$ (default)
001b: RL $=10, n$ RTP $=8$
010b: RL $=14, n$ RTP $=8$
011b: RL $=20, n$ RTP $=8$
100b: RL $=24, n$ RTP $=10$
101b: RL $=28, n$ RTP $=12$
110b: RL $=32, n$ RTP $=14$
111b: RL $=36, n$ RTP $=16$ | $1,3,4$  |
|   |  |  | RL and $n$ RTP for DBI-RD enabled (MR3 OP[6] = 1b)
000b: RL $=6, n$ RTP $=8$
001b: RL $=12, n$ RTP $=8$
010b: RL $=16, n$ RTP $=8$
011b: RL $=22, n$ RTP $=8$
100b: RL $=28, n$ RTP $=10$
101b: RL $=32, n$ RTP $=12$
110b: RL $=36, n$ RTP $=14$
111b: RL $=40, n$ RTP $=16$ |   |Table 28: MR2 Op-Code Bit Definitions (Continued)

| Feature | Type | OP | Definition | Notes |
| :--: | :--: | :--: | :--: | :--: |
| WL <br> WRITE latency | Write- <br> only | OP[5:3] | WL set A (MR2 OP[6] = 0b) <br> 000b: WL $=4$ (default) <br> 001b: WL $=6$ <br> 010b: WL $=8$ <br> 011b: WL $=10$ <br> 100b: WL $=12$ <br> 101b: WL $=14$ <br> 110b: WL $=16$ <br> 111b: WL $=18$ | $1,3,4$ |
|  |  |  | WL set B (MR2 OP[6] = 1b) <br> 000b: WL $=4$ <br> 001b: WL $=8$ <br> 010b: WL $=12$ <br> 011b: WL $=18$ <br> 100b: WL $=22$ <br> 101b: WL $=26$ <br> 110b: WL $=30$ <br> 111b: WL $=34$ |  |
| WLS <br> WRITE latency <br> set | Write- <br> only | OP[6] | 0b: Use WL set A (default) <br> 1b: Use WL set B | $1,3,4$ |
| WR Lev <br> Write leveling | Write- <br> only | OP[7] | 0b: Disable write leveling (default) <br> 1b: Enable write leveling | 2 |

Notes: 1. See Latency Code Frequency Table for allowable frequency ranges for RL/WL/nWR.
2. After an MRW command to set the write leveling enable bit (OP[7] = 1b), the device remains in the MRW state until another MRW command clears the bit (OP[7] = 0b). No other commands are allowed until the write leveling enable bit is cleared.
3. There are two physical registers assigned to each bit of this MR parameter: designated set point 0 and set point 1. Only the registers for the set point determined by the state of the FSP-WR bit (MR13 OP[6]) will be written to with an MRW command this MR address, or read from with an MRR command to this address.
4. There are two physical registers assigned to each bit of this MR parameter: designated set point 0 and set point 1. The device will operate only according to the values stored in the registers for the active set point, that is, the set point determined by the state of the FSP-OP bit (MR13 OP[7]). The values in the registers for the inactive set point will be ignored by the device and may be changed without affecting device operation.
5. $n$ RTP is valid for BL16 only. For BL32, the SDRAM will add 8 clocks to the $n$ RTP value before starting a precharge.Table 29: Frequency Ranges for RL, WL, nWR, and $n$ RTP Settings

| READ Latency |  | WRITE Latency |  | nWR | nRTP | Lower Frequency Limit ( $>$ ) | Upper Frequency Limit( $\leq$ ) | Units | Notes |
| :--: | :--: | :--: | :--: | :--: | :--: | :--: | :--: | :--: | :--: |
| No DBI | w/DBI | Set A | Set B |  |  |  |  |  |  |
| 6 | 6 | 4 | 4 | 6 | 8 | 10 | 266 | MHz | $1-6$ |
| 10 | 12 | 6 | 8 | 10 | 8 | 266 | 533 |  |  |
| 14 | 16 | 8 | 12 | 16 | 8 | 533 | 800 |  |  |
| 20 | 22 | 10 | 18 | 20 | 8 | 800 | 1066 |  |  |
| 24 | 28 | 12 | 22 | 24 | 10 | 1066 | 1333 |  |  |
| 28 | 32 | 14 | 26 | 30 | 12 | 1333 | 1600 |  |  |
| 32 | 36 | 16 | 30 | 34 | 14 | 1600 | 1866 |  |  |
| 36 | 40 | 18 | 34 | 40 | 16 | 1866 | 2133 |  |  |

Notes: 1. The device should not be operated at a frequency above the upper frequency limit or below the lower frequency limit shown for each RL, WL, or $n$ WR value.
2. DBI for READ operations is enabled in MR3 OP[6]. When MR3 OP[6] $=0$, then the "No DBI" column should be used for READ latency. When MR3 OP[6] $=1$, then the "w/DBI" column should be used for READ latency.
3. WRITE latency set $A$ and set $B$ are determined by MR2 OP[6]. When MR2 OP[6] $=0$, then WRITE latency set $A$ should be used. When MR2 OP[6] $=1$, then WRITE latency set $B$ should be used.
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
