dioderobot/arduino/components/MT53E512M32D1ZW/MT53E512M32D1ZW-046_AUT_B.md

# Automotive LPDDR4X/LPDDR4 SDRAM 

## MT53E512M32D1, MT53E1G32D2

## Features

This data sheet specifies the operation of the unified LPDDR4 and LPDDR4X product, and first describes specific requirements for LPDDR4X $0.6 \mathrm{~V} \mathrm{~V}_{\mathrm{DDQ}}$ operation. When using the product as an LPDDR4 device, refer to LPDDR4 setting section LPDDR4 $1.10 \mathrm{~V} \mathrm{~V}_{\mathrm{DDQ}}$ at the end of this data sheet.

- Ultra-low-voltage core and I/O power supplies
- $\mathrm{V}_{\mathrm{DD} 1}=1.70-1.95 \mathrm{~V} ; 1.80 \mathrm{~V}$ nominal
- $\mathrm{V}_{\mathrm{DD} 2}=1.06-1.17 \mathrm{~V} ; 1.10 \mathrm{~V}$ nominal
- $\mathrm{V}_{\mathrm{DDQ}}=0.57-0.65 \mathrm{~V} ; 0.60 \mathrm{~V}$ nominal or $\mathrm{V}_{\mathrm{DDQ}}=1.06-1.17 \mathrm{~V} ; 1.10 \mathrm{~V}$ nominal
- Frequency range
- 2133-10 MHz (data rate range per pin: 4266-20 $\mathrm{Mb} / \mathrm{s}$ )
- $16 n$ prefetch DDR architecture
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
