dioderobot/arduino/boards/Nano/docs/reference/Pinout-NANO_latest.pdf

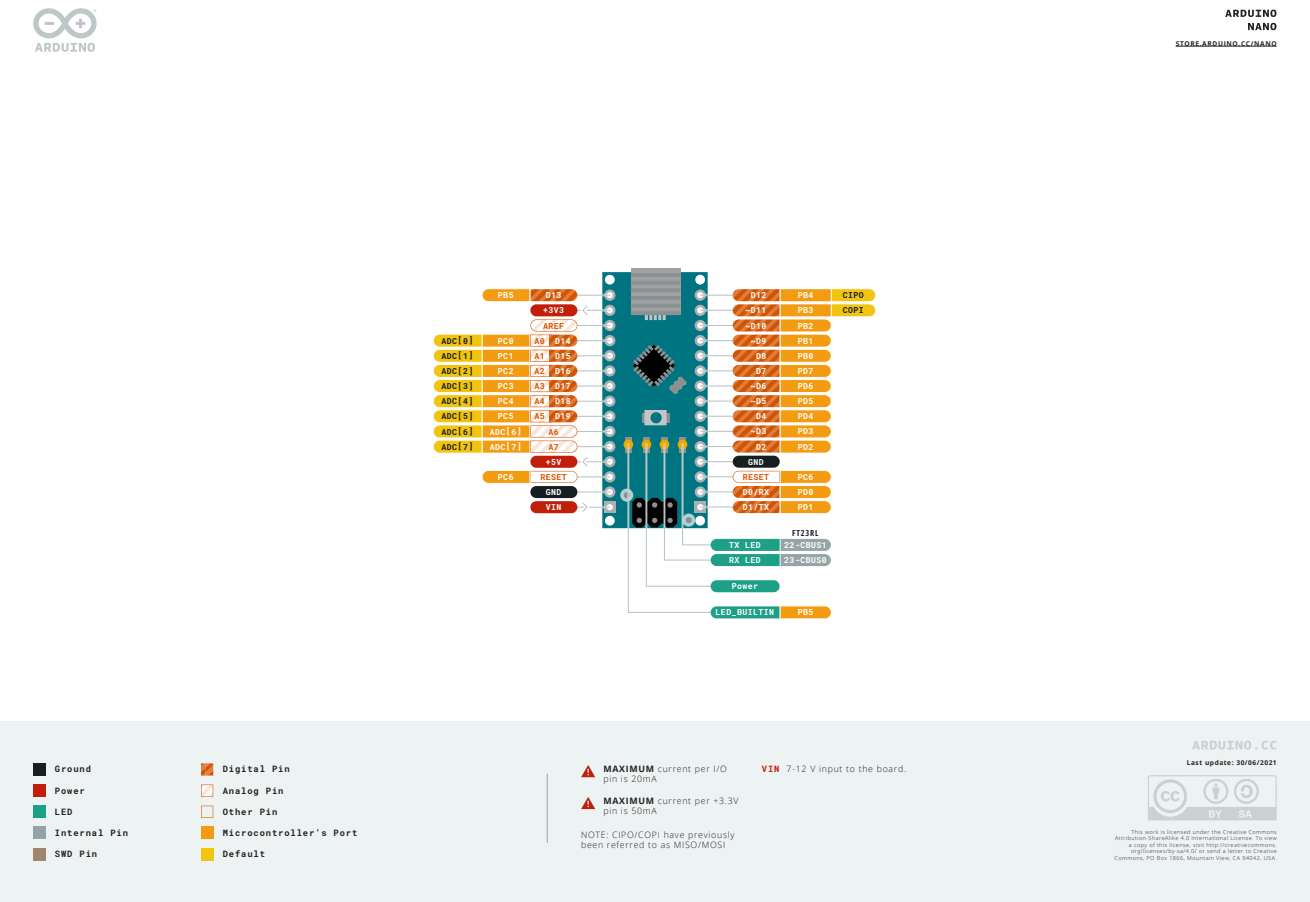
[picture p1: page 1]

STORE.ARDUINO.CC/NANO (https://store.arduino.cc/arduino-nano)

VIN 7-12 V input to the board.

NOTE: CIPO/COPI have previously
been referred to as MISO/MOSI

This work is licensed under the Creative Commons
Attribution-ShareAlike 4.0 International License. To view
a copy of this license, visit http://creativecommons.
org/licenses/by-sa/4.0/ or send a letter to Creative
Commons, PO Box 1866, Mountain View, CA 94042, USA.

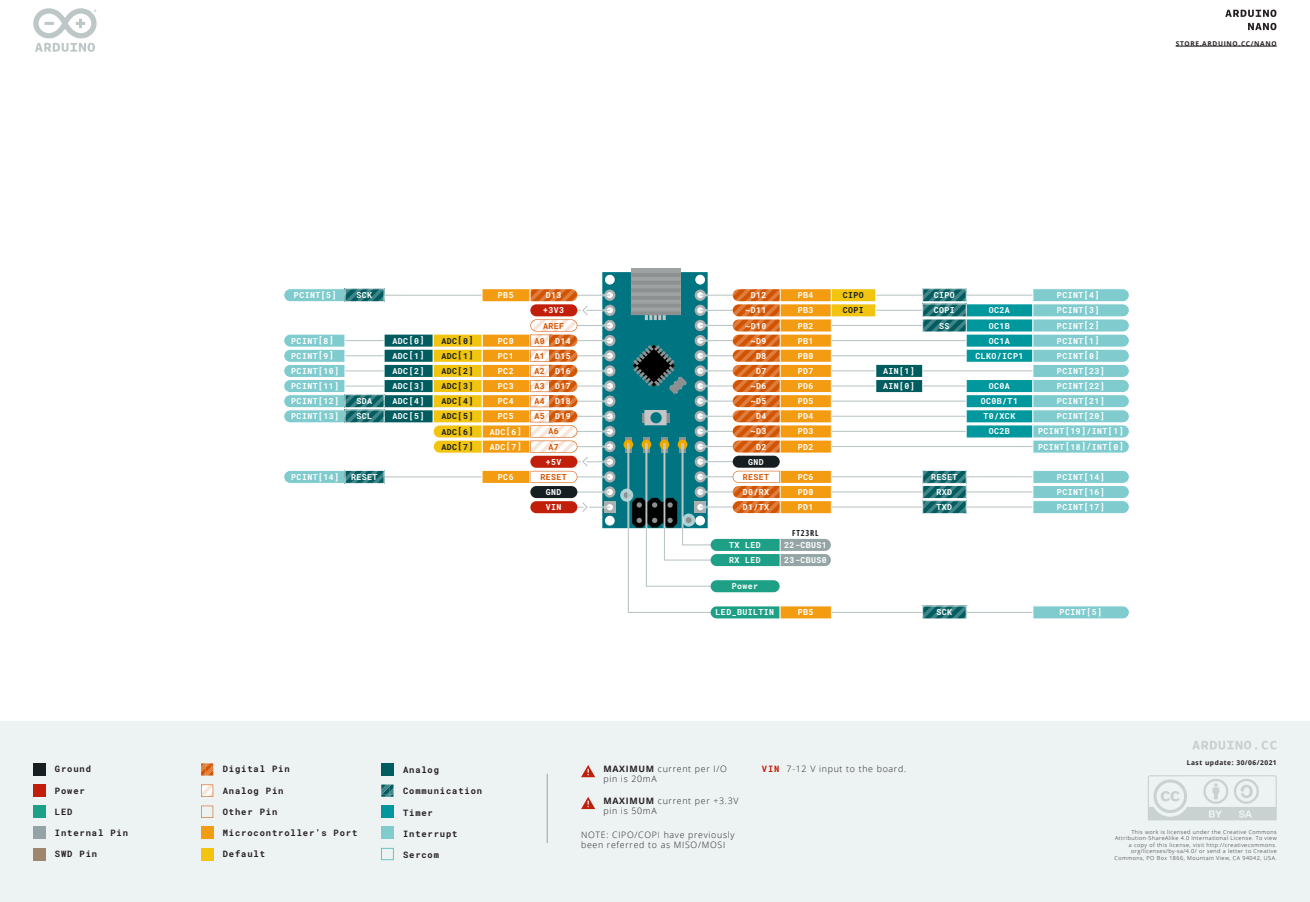
[picture p2: page 2]

ADC[0]
ADC[1]
ADC[2]
ADC[3]
ADC[4]
ADC[5]

VIN 7-12 V input to the board.

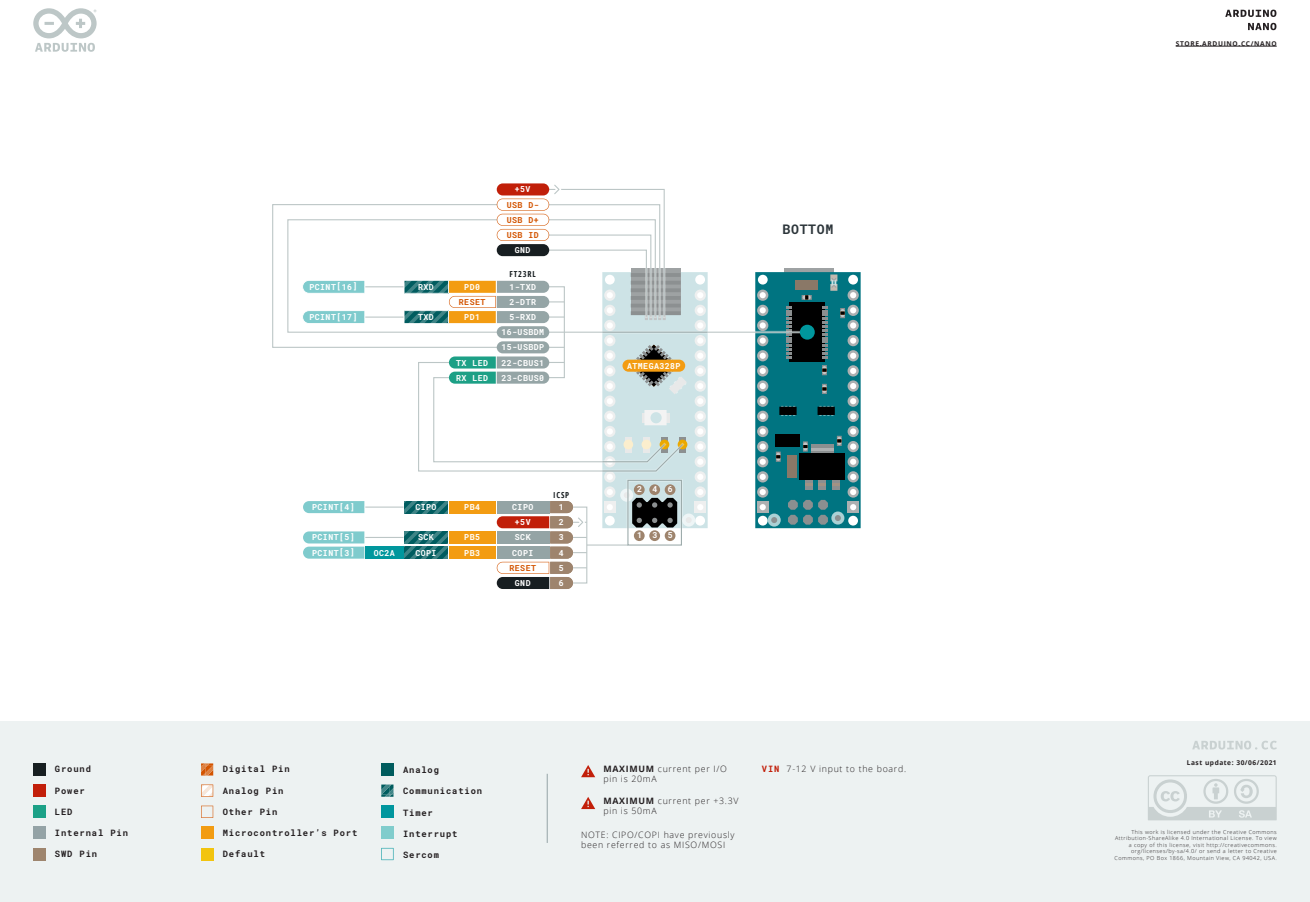
[picture p3: page 3]
Analog; Communication; Timer; Interrupt; Sercom; Ground; Power; LED; Digital Pin; Analog Pin; Other Pin; Last update: 30/06/2021; BOTTOM; ATMEGA328P; PCINT[16]; RXD; 1-TXD; RESET; 2-DTR; PCINT[17]; TXD; 5-RXD; TX LED; 22-CBUS1; RX LED; 23-CBUS0; 16-USBDM 15-USBDP; CIPO; SCK; COPI; GND; PCINT[4]; PCINT[5] PCINT[3]; ICSP; USB D-; USB D+ USB ID GND

MAXIMUM current per I/O
pin is 20mA
MAXIMUM current per +3.3V
pin is 50mA

VIN 7-12 V input to the board.
