dioderobot/arduino/modules/NanoCarrier/layout/NanoCarrier/layout.kicad_pcb

## KiCad design modules/NanoCarrier/layout/NanoCarrier/layout.kicad_pcb (2025-10-22)

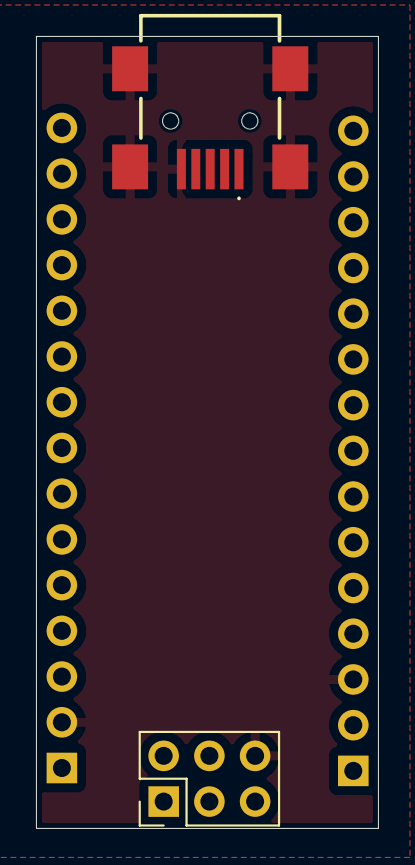
[picture p4: board modules/NanoCarrier/layout/NanoCarrier/layout.kicad_pcb from above]

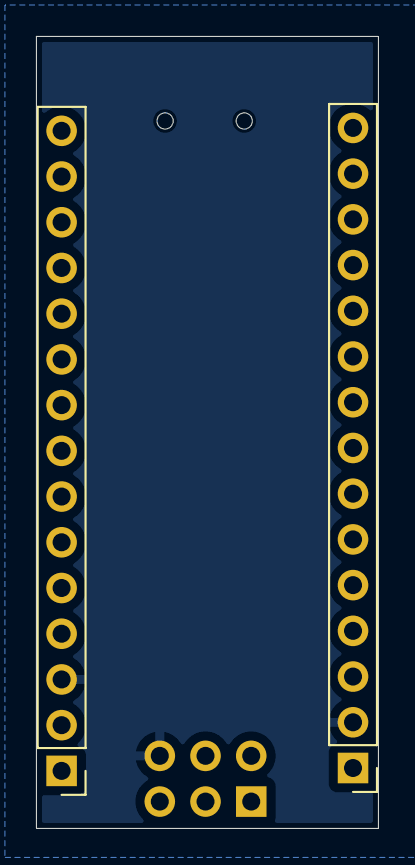
[picture p5: board modules/NanoCarrier/layout/NanoCarrier/layout.kicad_pcb from below]

Board: 4 copper layers, 19.0 x 44.0 mm, 4 parts (2 on the bottom side), 6 nets, no tracks yet.

Parts:
J1, J2: 2.54mm 15x1; PinHeader_1x15_P2.54mm_Vertical
J3: 10033526MN3212LF; 10033526N3212LF
J4: 2.54mm 3x2; PinHeader_2x03_P2.54mm_Vertical

Connections:
D11: J1.14, J4.4
D12: J1.15, J4.1
D13: J2.15, J4.3
GND: J1.3, J2.2, J3.5, J3.8, J3.9, J3.10, J3.11, J4.6
RESET: J1.2, J2.3, J4.5
VCC_5V: J2.4, J4.2
