dioderobot/arduino/modules/NanoCore/layout/NanoCore/layout.kicad_pcb

## KiCad design modules/NanoCore/layout/NanoCore/layout.kicad_pcb (2025-10-22)

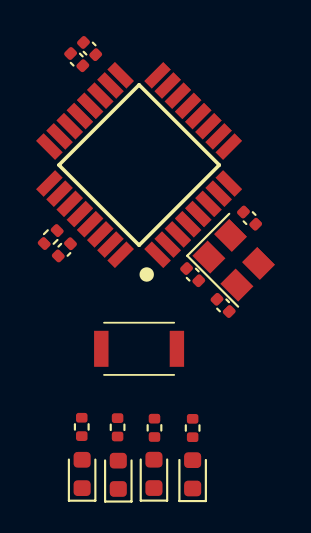
[picture p6: board modules/NanoCore/layout/NanoCore/layout.kicad_pcb from above]

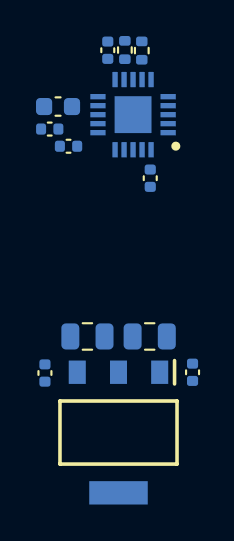
[picture p7: board modules/NanoCore/layout/NanoCore/layout.kicad_pcb from below]

Board: 4 copper layers, 31 parts (13 on the bottom side), 19 nets, no tracks yet.

Parts:
C1: 100nF; C_0402_1005Metric
C2, C3, C4, C11: 100nF 6.3V; C_0402_1005Metric
C5, C6: 22pF C0G; C_0402_1005Metric
C7: 10uF 25V; C_0805_2012Metric
C8: 100nF 25V; C_0402_1005Metric
C9: 22uF 10V; C_0805_2012Metric
C10, C12, C13, C14: 100nF 10V; C_0402_1005Metric
C15: 4.7uF 10V; C_0603_1608Metric
D1: LED YELLOW; LED_0603_1608Metric
D2, D3, D4: LED GREEN; LED_0603_1608Metric
IC1: ATMEGA328PMAU; QFP80P900X900X120-32N
IC2: AMS1117M5_0; SOT229P700X180-4N
IC3: FT231XQMR; QFN50P400X400X80-21N
R1: 10k 5%; R_0402_1005Metric
R2, R3: 1k 5%; R_0402_1005Metric
R4, R5: 470 5%; R_0402_1005Metric
R6, R7: 27 5%; R_0402_1005Metric
S1: SKRKAHE020; SKRKAEE020
Y1: 16MHz 18pF; Crystal_SMD_3225-4Pin_3.2x2.5mm

Connections:
D13: IC1.17, R2.1
DTR: C1.1, IC3.18
GND: C2.2, C3.2, C4.2, C5.2, C6.2, C7.2, C8.2, C9.2, C10.2, C11.2, C12.2, C13.2, C14.2, C15.2, D1.1, D2.1, IC1.3, IC1.5, IC1.21, IC2.1, IC2.4, IC3.3, IC3.13, IC3.21, S1.2, Y1.2, Y1.4
LED_L_ANODE: D1.2, R2.2
LED_PWR_ANODE: D2.2, R3.2
MCU.oscpair_XIN: C5.1, IC1.7, Y1.1
MCU.oscpair_XOUT: C6.1, IC1.8, Y1.3
RESET: C1.2, IC1.29, R1.1, S1.1
UART_RX: IC1.30, IC3.1
UART_TX: IC1.31, IC3.17
USB_SERIAL.CBUS0: D4.1, IC3.15
USB_SERIAL.CBUS1: D3.1, IC3.14
USB_SERIAL.P3V3OUT: C11.1, IC3.10
USB_SERIAL.RX_LED_ANODE: D3.2, R4.2
USB_SERIAL.TX_LED_ANODE: D4.2, R5.2
USB_SERIAL.USBDM_INTERNAL: IC3.9, R6.1
USB_SERIAL.USBDP_INTERNAL: IC3.8, R7.1
USB_VBUS: C7.1, C8.1, IC2.3
VCC_5V: C2.1, C3.1, C4.1, C9.1, C10.1, C12.1, C13.1, C14.1, C15.1, IC1.4, IC1.6, IC1.18, IC2.2, IC3.11, IC3.12, IC3.20, R1.2, R3.1, R4.1, R5.1
