dioderobot/arduino/boards/unoQ/src/LED_Layout/layout.kicad_pcb

## KiCad design boards/unoQ/src/LED_Layout/layout.kicad_pcb (2025-11-26)

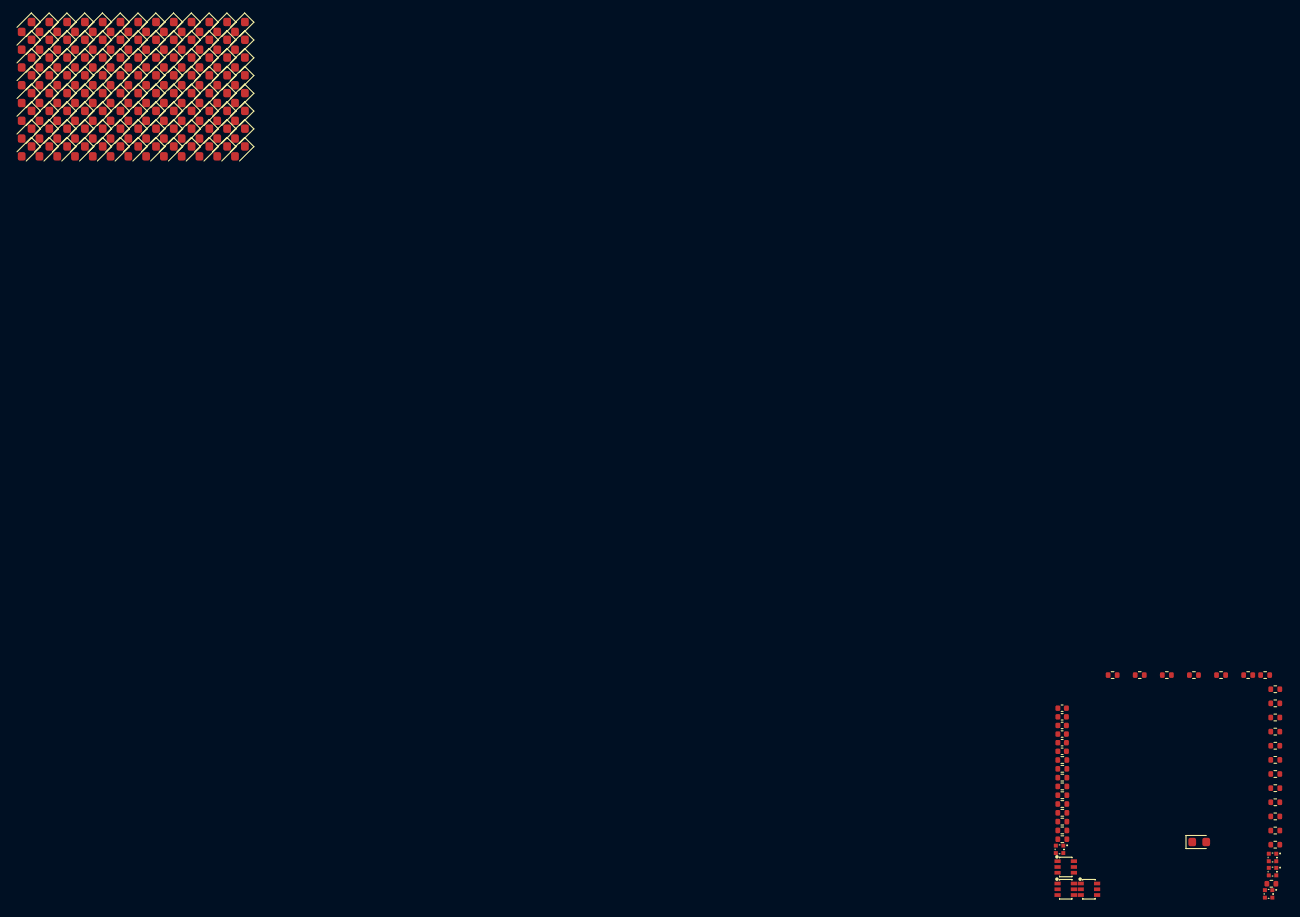
[picture p8: board boards/unoQ/src/LED_Layout/layout.kicad_pcb from above]

Board: 2 copper layers, 148 parts (0 on the bottom side), 38 nets, no tracks yet.

Parts:
C1, C2, C3, C4, C5, C6: 100nF 10V; C_0402_1005Metric
D1, D2, D3, D4, D5, D6, D7, D8, D9, D10, D11, D12, D13, D14, D15, D16, D17, D18, D19, D20, D21, D22, D23, D24, D25, D26, D27, D28, D29, D30, D31, D32, D33, D34, D35, D36, D37, D38, D39, D40, D41, D42, D43, D44, D45, D46, D47, D48, D49, D50, D51, D52, D53, D54, D55, D56, D57, D58, D59, D60, D61, D62, D63, D64, D65, D66, D67, D68, D69, D70, D71, D72, D73, D74, D75, D76, D77, D78, D79, D80, D81, D82, D83, D84, D85, D86, D87, D88, D89, D90, D91, D92, D93, D94, D95, D96, D97, D98, D99, D100, D101, D102, D103, D104: LED BLUE; LED_0603_1608Metric
D105: LED GREEN; LED_0603_1608Metric
LED1, LED2, LED3, LED4: ?; LED-SMD_4P-L1.0-W1.0-TR_RGB
Q1, Q2, Q3: ?; SOT-363_L2.0-W1.3-P0.65-LS2.1-TL
R1, R2, R3, R4, R5, R6, R7, R8, R9, R10, R11: 22; R_0402_1005Metric
R12: 330; R_0402_1005Metric
R13, R14, R15, R16, R17, R18, R20, R22, R24, R26, R28, R30: 1.1k 1%; R_0402_1005Metric
R19, R21, R23, R25, R27, R29: 1k; R_0402_1005Metric

Connections:
GND: C1.2, C2.2, C3.2, C4.2, C5.2, C6.2, D105.1, Q1.1, Q1.4, Q2.1, Q2.4, Q3.1, Q3.4
LED_MATRIX_0_R: D1.2, D10.2, D11.1, D17.1, D19.2, D20.1, D28.2, D30.2, D31.1, D39.1, D43.2, D44.1, D58.2, D59.1, D72.2, D76.2, D77.1, D83.1, D96.2, D97.1, R1.2
LED_MATRIX_1_R: D1.1, D2.1, D12.2, D13.1, D17.2, D21.2, D22.1, D32.2, D33.1, D45.2, D46.1, D50.2, D60.2, D61.1, D62.1, D78.2, D79.1, D94.2, D98.2, D99.1, R2.2
LED_MATRIX_2_R: D8.2, D9.1, D14.2, D15.1, D23.2, D24.1, D28.1, D34.2, D35.1, D39.2, D47.2, D48.1, D50.1, D61.2, D63.2, D64.1, D80.2, D81.1, D100.2, D101.1, R4.2
LED_MATRIX_3_R: D2.2, D8.1, D9.2, D16.2, D18.1, D25.2, D26.1, D36.2, D37.1, D49.2, D51.1, D65.2, D66.1, D72.1, D82.2, D83.2, D84.1, D94.1, D102.2, D103.1, R5.2
LED_MATRIX_4_R: D3.1, D10.1, D11.2, D12.1, D13.2, D14.1, D15.2, D16.1, D18.2, D27.2, D29.1, D38.2, D40.1, D52.2, D53.1, D67.2, D68.1, D85.2, D86.1, D104.2, R6.2
LED_MATRIX_5_R: D4.2, D5.1, D19.1, D20.2, D21.1, D22.2, D23.1, D24.2, D25.1, D26.2, D27.1, D29.2, D41.2, D42.1, D54.2, D55.1, D69.2, D70.1, D87.2, D88.1, R7.2
LED_MATRIX_6_R: D6.2, D7.1, D30.1, D31.2, D32.1, D33.2, D34.1, D35.2, D36.1, D37.2, D38.1, D40.2, D41.1, D42.2, D56.2, D57.1, D71.2, D73.1, D89.2, D90.1, R8.2
LED_MATRIX_7_R: D43.1, D44.2, D45.1, D46.2, D47.1, D48.2, D49.1, D51.2, D52.1, D53.2, D54.1, D55.2, D56.1, D57.2, D74.2, D75.1, D91.2, D92.1, R9.2
LED_MATRIX_8_R: D58.1, D59.2, D60.1, D62.2, D63.1, D64.2, D65.1, D66.2, D67.1, D68.2, D69.1, D70.2, D71.1, D73.2, D74.1, D75.2, D93.2, D95.1, R10.2
LED_MATRIX_9_R: D76.1, D77.2, D78.1, D79.2, D80.1, D81.2, D82.1, D84.2, D85.1, D86.2, D87.1, D88.2, D89.1, D90.2, D91.1, D92.2, D93.1, D95.2, R11.2
LED_MATRIX_10_R: D3.2, D4.1, D5.2, D6.1, D7.2, D96.1, D97.2, D98.1, D99.2, D100.1, D101.2, D102.1, D103.2, D104.1, R3.2
LED_PWR: D105.2, R12.2
MCU_LED1_BLU_D: LED1.3, R13.1
MCU_LED1_GRN_D: LED1.4, R14.1
MCU_LED1_RED_D: LED1.2, R15.1
MCU_LED2_BLU_D: LED2.3, R16.1
MCU_LED2_GRN_D: LED2.4, R17.1
MCU_LED2_RED_D: LED2.2, R18.1
PWR_3P3V: LED1.1, LED2.1, LED3.1, LED4.1, R12.1
SOC_LED1_BLU_B: C1.1, Q2.2, R19.2
SOC_LED1_BLU_C: Q2.6, R20.2
SOC_LED1_BLU_D: LED3.3, R20.1
SOC_LED1_GRN_B: C2.1, Q1.5, R21.2
SOC_LED1_GRN_C: Q1.6, R22.2
SOC_LED1_GRN_D: LED3.4, R22.1
SOC_LED1_RED_B: C3.1, Q1.2, R23.2
SOC_LED1_RED_C: Q1.3, R24.2
SOC_LED1_RED_D: LED3.2, R24.1
SOC_LED2_BLU_B: C4.1, Q3.5, R25.2
SOC_LED2_BLU_C: Q3.3, R26.2
SOC_LED2_BLU_D: LED4.3, R26.1
SOC_LED2_GRN_B: C5.1, Q3.2, R27.2
SOC_LED2_GRN_C: Q3.6, R28.2
SOC_LED2_GRN_D: LED4.4, R28.1
SOC_LED2_RED_B: C6.1, Q2.5, R29.2
SOC_LED2_RED_C: Q2.3, R30.2
SOC_LED2_RED_D: LED4.2, R30.1
