dioderobot/arduino/boards/unoQ/layout/unoQ/layout.kicad_pcb

## KiCad design boards/unoQ/layout/unoQ/layout.kicad_pcb (2025-11-26)

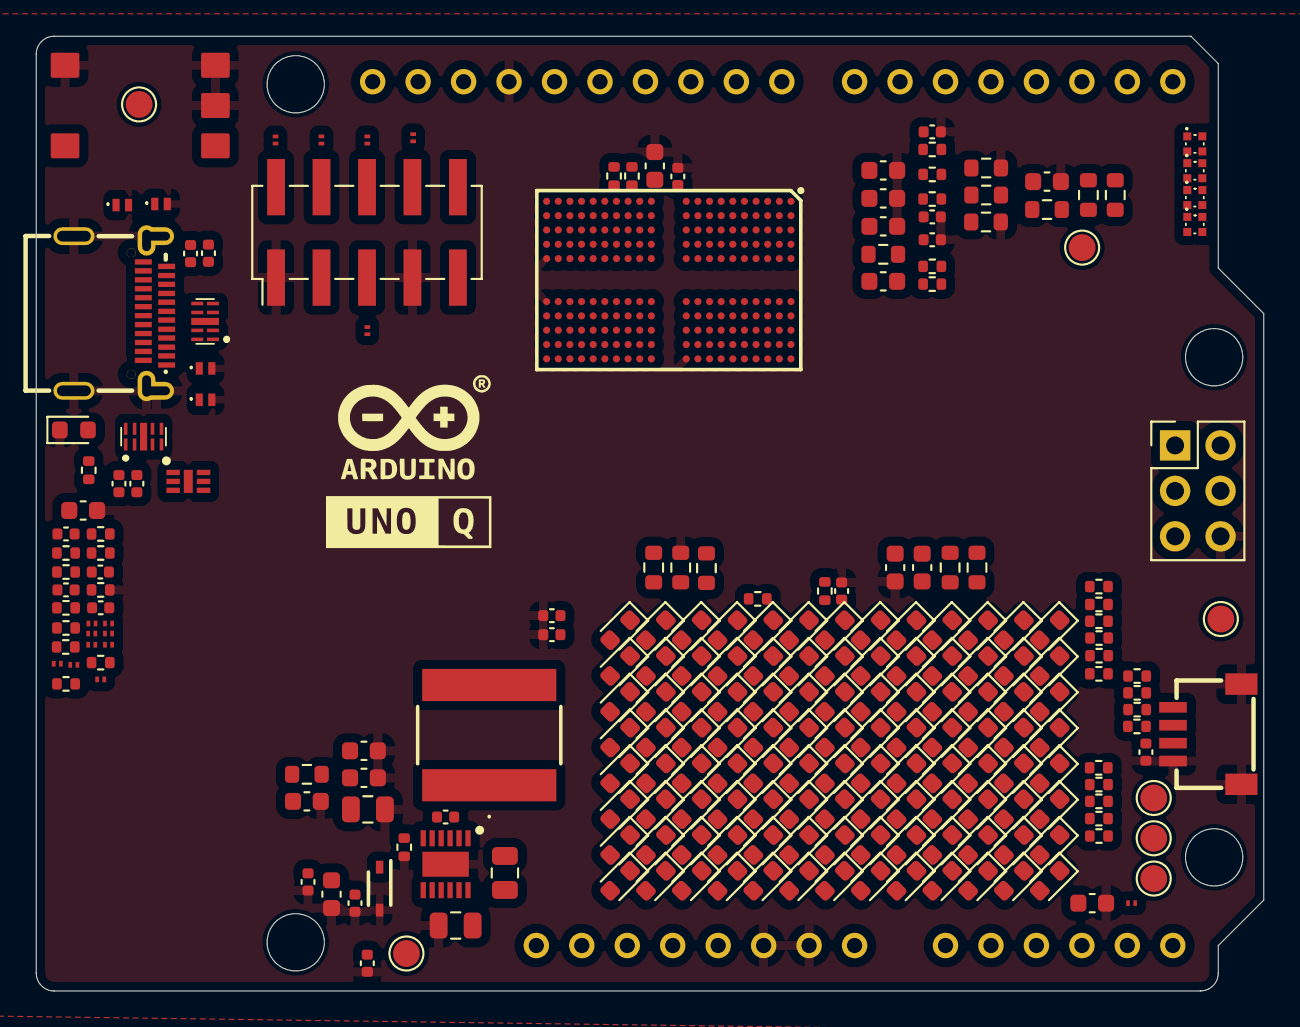
[picture p9: board boards/unoQ/layout/unoQ/layout.kicad_pcb from above]

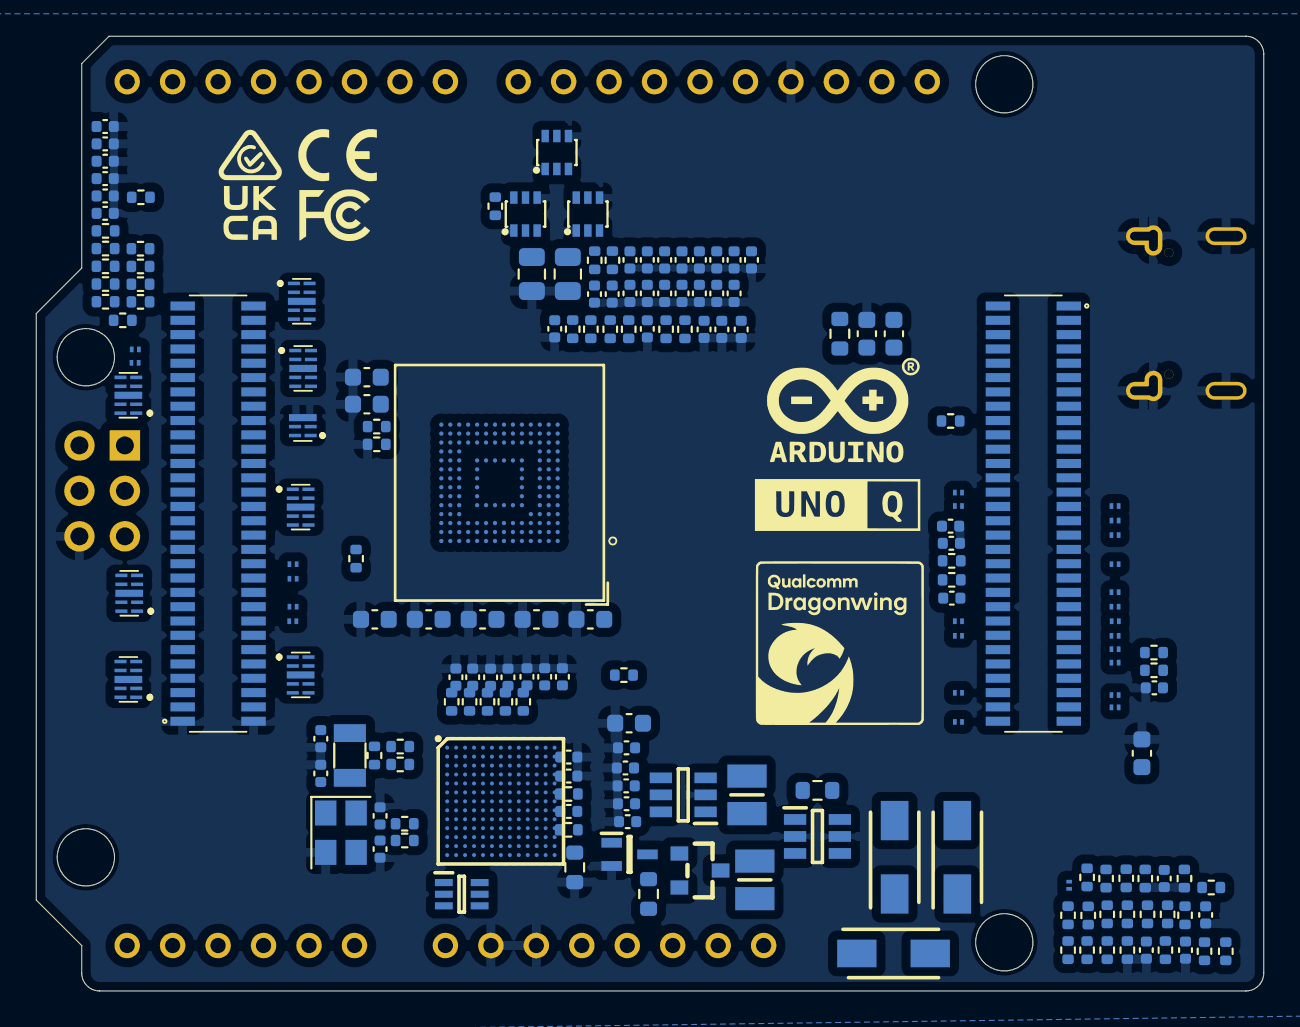
[picture p10: board boards/unoQ/layout/unoQ/layout.kicad_pcb from below]

Board: 4 copper layers, 68.6 x 53.3 mm, 424 parts (185 on the bottom side), 266 nets, no tracks yet.

Parts:
1: ?; 1571636-3
2: ?; 1X18-CUSTOM
C1: 100nF 16V; C_0402_1005Metric
C2: 22pF 50V; C_0603_1608Metric
C3, C4: 22uF 25V; C_0805_2012Metric
C5: 100nF 50V; C_0603_1608Metric
C6: 22uF 10V; C_0603_1608Metric
C7, C39, C40: 10uF 10V; C_0603_1608Metric
C8, C10: 120pF 25V; C_0603_1608Metric
C9, C15: 4.7uF 10V; C_0603_1608Metric
C11, C12: 22uF 6.3V; C_0603_1608Metric
C13, C103: 100nF 6.3V; C_0603_1608Metric
C14, C62: 4.7uF 6.3V; C_0805_2012Metric
C16, C99: 100nF 10V; C_0603_1608Metric
C17, C23, C32, C33, C34, C35, C41, C43, C44, C45, C46, C56, C70, C72, C74, C80, C81, C82, C83, C84, C85, C86, C87, C88, C89, C90, C91, C92, C93, C95, C97, C98: 100nF 6.3V; C_0402_1005Metric
C18, C19, C20: 100nF 50V; C_0402_1005Metric
C21, C22: 220pF 25V; C_0402_1005Metric
C24, C25, C26, C27, C28, C29, C30, C31: 330nF 10V; C_0402_1005Metric
C36, C37, C38, C42, C47, C48, C49, C50, C51, C52: 100nF 10V; C_0402_1005Metric
C53, C54, C55, C57, C58, C59, C60, C61, C63, C64, C65, C66, C67, C68, C69: 1uF 6.3V; C_0402_1005Metric
C71: 10uF 6.3V; C_0805_2012Metric
C73, C79, C100, C101: 1uF 6.3V; C_0603_1608Metric
C75, C76: 12pF 50V; C_0402_1005Metric
C77, C78: 7pF 25V; C_0402_1005Metric
C94, C96: 4.7uF 6.3V; C_0603_1608Metric
C102, C104, C105: 2.2uF 6.3V; C_0603_1608Metric
D1, D2, D3: SX34; DIOM5027X244N
D4: RCLAMP0522P.TCT; RCLAMP0522PTCT
D5, D6, D7, D8, D9, D10, D11, D12, D13, D14, D15, D16, D17, D18, D19, D20, D21, D22, D23, D24, D25, D26, D27, D28, D29, D30, D31, D32, D33, D34, D35, D36, D37, D38, D39, D40, D41, D42, D43, D44: DF2B7ASL; DF2S51ASLL3F
D45: PJGBLC24C; SODFL2512X90N
D46, D47, D48, D49, D50, D51, D52, D53, D54: RCLAMP0524PATCT
D55, D56, D57, D58: PESD5V0X1BL,315; PESD5V0S1BL315
D59, D60, D61, D62, D63, D64, D65, D66, D67, D68, D69, D70, D71, D72, D73, D74, D75, D76, D77, D78, D79, D80, D81, D82, D83, D84, D85, D86, D87, D88, D89, D90, D91, D92, D93, D94, D95, D96, D97, D98, D99, D100, D101, D102, D103, D104, D105, D106, D107, D108, D109, D110, D111, D112, D113, D114, D115, D116, D117, D118, D119, D120, D121, D122, D123, D124, D125, D126, D127, D128, D129, D130, D131, D132, D133, D134, D135, D136, D137, D138, D139, D140, D141, D142, D143, D144, D145, D146, D147, D148, D149, D150, D151, D152, D153, D154, D155, D156, D157, D158, D159, D160, D161, D162: LED BLUE; LED_0603_1608Metric
D163: LED GREEN; LED_0603_1608Metric
H1, H2, H3, H4: M3 ISO14580 Via; MountingHole_3.2mm_M3_ISO14580
IC1: LMR51440SDRRR; SON50P300X300X80-13N-D
IC2, IC3: TPS62A02APDDCR; SOT95P280X110-6N
IC4: RCLAMP3654PATCT; SON50P160X160X65-7N
IC5: MT53E512M32D1ZW-046 AUT:B; BGA200C65P12X22_1000X1450X105
IC6: 74LVC1G3157DW-7; SOT65P210X110-6N
IC7: STM32U585AII6TR; BGA169C50P13X13_700X700X60
J1, J2: CLE-130-01-G-DV-P-TR; CLE-130-01-X-DV-P-TR
J3: PinHeader_2x03_P2.54mm_Vertical
J4: PinHeader_2x05_P2.54mm_Vertical_SMD
JANALOG1: ?; 1X14-CUSTOM
L1, L2: TFM252012ALMA1R0MTAA; INDC2520X120N
L3: NRS8030T3R3MJGJ
LED1, LED2, LED3, LED4: ?; LED-SMD_4P-L1.0-W1.0-TR_RGB
Q1: SMMBT3904WT1G; SOT65P220X100-3N
Q2: ?; SOT-23_L2.9-W1.3-P1.90-LS2.4-BR
Q3, Q4, Q5: ?; SOT-363_L2.0-W1.3-P0.65-LS2.1-TL
R1: 301k 1%; R_0603_1608Metric
R2, R3, R15: 100k 1%; R_0603_1608Metric
R4: 1k 1%; R_0603_1608Metric
R5: 19.1k 1%; R_0603_1608Metric
R6, R19, R21, R23, R25, R27, R28, R29, R30, R31, R33, R35, R37, R39, R40, R41, R43, R45, R48, R49, R50, R51, R52, R53, R58, R59, R60, R61, R62, R63, R64, R65, R98, R99, R100, R101, R102, R103, R104, R105, R106, R108, R109, R110, R111: 0; R_0402_1005Metric
R7, R11, R12, R13, R18: 10k 1%; R_0603_1608Metric
R8, R16, R17: 0; R_0603_1608Metric
R9: 95.3k 1%; R_0603_1608Metric
R10: 499k 1%; R_0603_1608Metric
R14: 453k 1%; R_0603_1608Metric
R20, R22, R24, R26, R84, R86, R88, R90, R92, R94: 1k; R_0402_1005Metric
R32, R34, R36, R38, R47: 2.2k; R_0402_1005Metric
R42, R112: 100k; R_0402_1005Metric
R44, R46: 2.2; R_0402_1005Metric
R54, R55, R56, R57: 220k; R_0402_1005Metric
R66, R67, R68, R69, R70, R71, R72, R73, R74, R75, R76: 22; R_0402_1005Metric
R77: 330; R_0402_1005Metric
R78, R79, R80, R81, R82, R83, R85, R87, R89, R91, R93, R95: 1.1k 1%; R_0402_1005Metric
R96, R97: 240 1%; R_0402_1005Metric
R107: 1M; R_0402_1005Metric
R113, R114: 10k 1%; R_0402_1005Metric
TP1, TP2, TP3, TP4, TP5, TP6, TP7: Pad_D1.5mm; TestPoint_Pad_D1.5mm
U1: ?; CONN-SMD_4P-P1.00_CCSH-W10R-04TR-BK
U2: ?; BGA-153_L13.0-W11.5-P0.50-TL_KLM8G1GEME-B041
USB1: ?; USB-C-SMD_TYPE-C-24P-QT
Y1: 16MHz; Crystal_SMD_3225-4Pin_3.2x2.5mm
Y2: 32kHz; Crystal_SMD_3215-2Pin_3.2x1.5mm

Connections:
BUCK_5V_OUT: C6.1, C7.1, D2.2, L3.2, R3.1, R4.1
CCI_I2C_SCL0: R19.1, R20.1
CCI_I2C_SCL1: R21.1, R22.1
CCI_I2C_SDA0: R23.1, R24.1
CCI_I2C_SDA1: R25.1, R26.1
CSI0_A0_CLK_M: D4.1, D52.4, D52.7, J1.33
CSI0_A1_LN1_P: D52.2, D52.9, J1.29
CSI0_A2_LN2_M: D51.1, D51.10, J1.39
CSI0_B0_LN0_P: D49.5, D49.6, J1.23
CSI0_B1_LN1_M: D52.1, D52.10, J1.27
CSI0_C0_LN0_M: D49.4, D49.7, J1.21
CSI0_NC_CLK_P: D52.5, D52.6, J1.35
CSI1_A0_CLK_M: D4.2, J1.42
CSI1_A1_LN1_P: D48.5, D48.6, J1.46
CSI1_A2_LN2_M: D50.1, D50.10, J1.36
CSI1_B0_LN0_P: D48.2, D48.9, J1.52
CSI1_B1_LN1_M: D48.4, D48.7, J1.48
CSI1_B2_LN3_P: D50.5, D50.6, D51.5, D51.6, J1.28
CSI1_C0_LN0_M: D48.1, D48.10, J1.54
CSI1_C1_LN2_P: D50.2, D50.9, D51.2, D51.9, J1.34
CSI1_C2_LN3_M: D50.4, D50.7, D51.4, D51.7, J1.30
DC_DC.BUCK_5V_BOOT: C1.1, IC1.4
DC_DC.BUCK_5V_C: C3.2, C4.1
DC_DC.BUCK_5V_EN: IC1.9, R1.2, R2.1
DC_DC.BUCK_5V_FB: C2.2, IC1.7, R3.2, R5.1
DC_DC.BUCK_5V_FB_C: C2.1, R4.2
DC_DC.BUCK_5V_RT: IC1.6, R6.1
DC_DC.BUCK_5V_SW: C1.2, IC1.1, IC1.2, IC1.3, L3.1
DC_DC.BUCK_5V_VIN: C3.1, C5.1, D1.1, IC1.10, IC1.11, IC1.12, R1.1
DC_DC.LDO1_EN: IC2.1, R7.2, R8.1
DC_DC.LDO1_FB: C8.2, IC2.6, R9.1, R10.2
DC_DC.LDO1_LX: IC2.3, L2.1
DC_DC.LDO1_PG: C9.1, IC2.5, Q1.1, R11.1, R12.2
DC_DC.LDO2_EN: IC3.1, R13.2
DC_DC.LDO2_FB: C10.2, IC3.6, R14.2, R15.1
DC_DC.LDO2_LX: IC3.3, L1.1
DC_DC.USB_5V_VBUS_ON_N: Q1.3, Q2.1, R18.2
DC_IN: C18.1, C19.1, C20.1, D1.2, D45.1, J1.57, J1.59, JANALOG1.8
FORCED_USB_BOOT_N: D13.1, J4.2
GND: 1.3, 1.4, 1.5, 2.15, C4.2, C5.2, C6.2, C7.2, C9.2, C11.2, C12.2, C13.2, C14.2, C15.2, C16.2, C17.2, C18.2, C19.2, C20.2, C21.2, C22.2, C23.2, C32.2, C33.2, C34.2, C35.2, C36.2, C37.2, C38.2, C39.2, C40.2, C41.2, C42.2, C43.2, C44.2, C45.2, C46.2, C47.2, C48.2, C49.2, C50.2, C51.2, C52.2, C53.2, C54.2, C55.2, C56.2, C57.2, C58.2, C59.2, C60.2, C61.2, C62.2, C63.2, C64.2, C65.2, C66.2, C67.2, C68.2, C69.2, C70.2, C71.2, C72.2, C73.2, C74.2, C75.2, C76.2, C77.2, C78.2, C79.2, C80.2, C81.2, C82.2, C83.2, C84.2, C85.2, C86.2, C87.2, C88.2, C89.2, C90.2, C91.2, C92.2, C93.2, C94.2, C95.2, C96.2, C97.2, C98.2, C99.2, C100.2, C101.2, C102.2, C103.2, C104.2, C105.2, D4.3, D4.4, D5.2, D6.2, D7.2, D8.2, D9.2, D10.2, D11.2, D12.2, D13.2, D14.2, D15.2, D16.2, D17.2, D18.2, D19.2, D20.2, D21.2, D22.2, D23.2, D24.2, D25.2, D26.2, D27.2, D28.2, D29.2, D30.2, D31.2, D32.2, D33.2, D34.2, D35.2, D36.2, D37.2, D38.2, D39.2, D40.2, D41.2, D42.2, D43.2, D44.2, D45.2, D46.3, D46.8, D47.3, D47.8, D48.3, D48.8, D49.3, D49.8, D50.3, D50.8, D51.3, D51.8, D52.3, D52.8, D53.3, D53.8, D54.3, D54.8, D55.2, D56.2, D57.2, D58.2, D163.1, IC1.8, IC1.13, IC2.2, IC3.2, IC3.5, IC4.7, IC5.A3, IC5.A4, IC5.A9, IC5.A10, IC5.AB3, IC5.AB5, IC5.AB8, IC5.AB10, IC5.C1, IC5.C5, IC5.C8, IC5.C12, IC5.D2, IC5.D4, IC5.D9, IC5.D11, IC5.E1, IC5.E5, IC5.E8, IC5.E12, IC5.G1, IC5.G3, IC5.G5, IC5.G8, IC5.G10, IC5.G12, IC5.J1, IC5.J3, IC5.J10, IC5.J12, IC5.K2, IC5.K4, IC5.K9, IC5.K11, IC5.K12, IC5.N2, IC5.N4, IC5.N9, IC5.N11, IC5.P1, IC5.P3, IC5.P10, IC5.P12, IC5.T1, IC5.T3, IC5.T5, IC5.T8, IC5.T10, IC5.T12, IC5.V1, IC5.V5, IC5.V8, IC5.V12, IC5.W2, IC5.W4, IC5.W9, IC5.W11, IC5.Y1, IC5.Y5, IC5.Y8, IC5.Y12, IC6.2, IC7.B2, IC7.B4, IC7.B8, IC7.B11, IC7.E12, IC7.F2, IC7.H2, IC7.J12, IC7.K2, IC7.M3, IC7.M7, IC7.M11, J1.1, J1.2, J1.7, J1.8, J1.13, J1.14, J1.19, J1.20, J1.25, J1.26, J1.31, J1.32, J1.37, J1.38, J1.43, J1.44, J1.49, J1.50, J1.55, J1.56, J2.26, J2.27, J2.35, J2.44, J2.58, J3.6, J4.1, J4.7, JANALOG1.6, JANALOG1.7, Q1.2, Q3.1, Q3.4, Q4.1, Q4.4, Q5.1, Q5.4, R2.2, R5.2, R6.2, R9.2, R11.2, R15.2, R42.2, R54.2, R55.2, R56.2, R57.2, R112.2, R114.2, U1.1, U1.5, U1.6, U2.A6, U2.C4, U2.E7, U2.E8, U2.E9, U2.E10, U2.F10, U2.G5, U2.G10, U2.H5, U2.H10, U2.J5, U2.K8, U2.K10, U2.N2, U2.N5, U2.P4, U2.P6, USB1.3, USB1.4, USB1.25, USB1.A1, USB1.A12, USB1.B1, USB1.B12, Y1.2, Y1.4
IO.CCI_I2C_SCL0_CONN: D7.1, J1.51, R19.2
IO.CCI_I2C_SCL1_CONN: D8.1, J1.24, R21.2
IO.CCI_I2C_SDA0_CONN: D9.1, J1.53, R23.2
IO.CCI_I2C_SDA1_CONN: D10.1, J1.22, R25.2
IO.EAR_M_R: C21.1, D11.1, J2.30, R27.2
IO.EAR_P_R: C22.1, D12.1, J2.28, R28.2
IO.HPH_L_CONN: D14.1, J2.36, R29.2
IO.HPH_REF_CONN: J2.40, R31.2
IO.HPH_R_CONN: D15.1, J2.38, R30.2
IO.LINEOUT_M_CONN: D16.1, J2.34, R40.2
IO.LINEOUT_P_CONN: D17.1, J2.32, R41.2
IO.MCU_I2C2_SCL_CONN: 2.18, R33.2
IO.MCU_I2C2_SDA_CONN: 2.17, R35.2
IO.MCU_I2C4_SCL_PD12_CONN: R37.2, U1.4
IO.MCU_I2C4_SCL_PF14_CONN: J2.16, R43.2
IO.MCU_I2C4_SDA_PD13_CONN: R39.2, U1.3
IO.MCU_I2C4_SDA_PF15_CONN: J2.18, R45.2
IO.MCU_SPI2_CLK_CONN: 2.14, R60.2
IO.MCU_SPI2_CLK_PD1_CONN: J3.3, R48.2
IO.MCU_SPI2_MISO_CONN: 2.13, R61.2
IO.MCU_SPI2_MISO_PC2_CONN: J3.1, R49.2
IO.MCU_SPI2_MOSI_CONN: 2.12, R62.2
IO.MCU_SPI2_MOSI_PC3_CONN: J3.4, R50.2
IO.MCU_SPI2_NSS_CONN: 2.11, R63.2
IO.MCU_USART1_RX_CONN: 2.1, R64.2
IO.MCU_USART1_TX_CONN: 2.2, R65.2
IO.MIC2_BIAS_CONN: D18.1, J2.33, R51.2
IO.MIC2_INN_CONN: D19.1, J2.31, R52.2
IO.MIC2_INP_CONN: D20.1, J2.29, R53.2
IO.MUX_SSRXN1_C: C24.1, D55.1, USB1.B10
IO.MUX_SSRXN2_C: C25.1, D46.5, D46.6, USB1.A10
IO.MUX_SSRXP1_C: C26.1, D56.1, USB1.B11
IO.MUX_SSRXP2_C: C27.1, D46.4, D46.7, USB1.A11
IO.MUX_SSTXN1_C: C28.1, D57.1, USB1.A3
IO.MUX_SSTXN2_C: C29.1, D46.1, D46.10, USB1.B3
IO.MUX_SSTXP1_C: C30.1, D58.1, USB1.A2
IO.MUX_SSTXP2_C: C31.1, D46.2, D46.9, USB1.B2
IO.SOC_CAM_MCLK0_R: D22.1, J1.16, R58.2
IO.SOC_CAM_MCLK1_R: D23.1, J1.18, R59.2
LED.LED_MATRIX_0_R: D59.2, D68.2, D69.1, D75.1, D77.2, D78.1, D86.2, D88.2, D89.1, D97.1, D101.2, D102.1, D116.2, D117.1, D130.2, D134.2, D135.1, D141.1, D154.2, D155.1, R66.2
LED.LED_MATRIX_1_R: D59.1, D60.1, D70.2, D71.1, D75.2, D79.2, D80.1, D90.2, D91.1, D103.2, D104.1, D108.2, D118.2, D119.1, D120.1, D136.2, D137.1, D152.2, D156.2, D157.1, R67.2
LED.LED_MATRIX_2_R: D66.2, D67.1, D72.2, D73.1, D81.2, D82.1, D86.1, D92.2, D93.1, D97.2, D105.2, D106.1, D108.1, D119.2, D121.2, D122.1, D138.2, D139.1, D158.2, D159.1, R69.2
LED.LED_MATRIX_3_R: D60.2, D66.1, D67.2, D74.2, D76.1, D83.2, D84.1, D94.2, D95.1, D107.2, D109.1, D123.2, D124.1, D130.1, D140.2, D141.2, D142.1, D152.1, D160.2, D161.1, R70.2
LED.LED_MATRIX_4_R: D61.1, D68.1, D69.2, D70.1, D71.2, D72.1, D73.2, D74.1, D76.2, D85.2, D87.1, D96.2, D98.1, D110.2, D111.1, D125.2, D126.1, D143.2, D144.1, D162.2, R71.2
LED.LED_MATRIX_5_R: D62.2, D63.1, D77.1, D78.2, D79.1, D80.2, D81.1, D82.2, D83.1, D84.2, D85.1, D87.2, D99.2, D100.1, D112.2, D113.1, D127.2, D128.1, D145.2, D146.1, R72.2
LED.LED_MATRIX_6_R: D64.2, D65.1, D88.1, D89.2, D90.1, D91.2, D92.1, D93.2, D94.1, D95.2, D96.1, D98.2, D99.1, D100.2, D114.2, D115.1, D129.2, D131.1, D147.2, D148.1, R73.2
LED.LED_MATRIX_7_R: D101.1, D102.2, D103.1, D104.2, D105.1, D106.2, D107.1, D109.2, D110.1, D111.2, D112.1, D113.2, D114.1, D115.2, D132.2, D133.1, D149.2, D150.1, R74.2
LED.LED_MATRIX_8_R: D116.1, D117.2, D118.1, D120.2, D121.1, D122.2, D123.1, D124.2, D125.1, D126.2, D127.1, D128.2, D129.1, D131.2, D132.1, D133.2, D151.2, D153.1, R75.2
LED.LED_MATRIX_9_R: D134.1, D135.2, D136.1, D137.2, D138.1, D139.2, D140.1, D142.2, D143.1, D144.2, D145.1, D146.2, D147.1, D148.2, D149.1, D150.2, D151.1, D153.2, R76.2
LED.LED_MATRIX_10_R: D61.2, D62.1, D63.2, D64.1, D65.2, D154.1, D155.2, D156.1, D157.2, D158.1, D159.2, D160.1, D161.2, D162.1, R68.2
LED.LED_PWR: D163.2, R77.2
LED.MCU_LED1_BLU_D: LED1.3, R78.1
LED.MCU_LED1_GRN_D: LED1.4, R79.1
LED.MCU_LED1_RED_D: LED1.2, R80.1
LED.MCU_LED2_BLU_D: LED2.3, R81.1
LED.MCU_LED2_GRN_D: LED2.4, R82.1
LED.MCU_LED2_RED_D: LED2.2, R83.1
LED.SOC_LED1_BLU_B: C47.1, Q4.2, R84.2
LED.SOC_LED1_BLU_C: Q4.6, R85.2
LED.SOC_LED1_BLU_D: LED3.3, R85.1
LED.SOC_LED1_GRN_B: C48.1, Q3.5, R86.2
LED.SOC_LED1_GRN_C: Q3.6, R87.2
LED.SOC_LED1_GRN_D: LED3.4, R87.1
LED.SOC_LED1_RED_B: C49.1, Q3.2, R88.2
LED.SOC_LED1_RED_C: Q3.3, R89.2
LED.SOC_LED1_RED_D: LED3.2, R89.1
LED.SOC_LED2_BLU_B: C50.1, Q5.5, R90.2
LED.SOC_LED2_BLU_C: Q5.3, R91.2
LED.SOC_LED2_BLU_D: LED4.3, R91.1
LED.SOC_LED2_GRN_B: C51.1, Q5.2, R92.2
LED.SOC_LED2_GRN_C: Q5.6, R93.2
LED.SOC_LED2_GRN_D: LED4.4, R93.1
LED.SOC_LED2_RED_B: C52.1, Q4.5, R94.2
LED.SOC_LED2_RED_C: Q4.3, R95.2
LED.SOC_LED2_RED_D: LED4.2, R95.1
LED_MATRIX_0: IC7.E2, R66.1
LED_MATRIX_1: IC7.F3, R67.1
LED_MATRIX_2: IC7.F4, R69.1
LED_MATRIX_3: IC7.G5, R70.1
LED_MATRIX_4: IC7.G6, R71.1
LED_MATRIX_5: IC7.G4, R72.1
LED_MATRIX_6: IC7.H6, R73.1
LED_MATRIX_7: IC7.G2, R74.1
LED_MATRIX_8: IC7.F1, R75.1
LED_MATRIX_9: IC7.G3, R76.1
LED_MATRIX_10: IC7.H4, R68.1
LPDDR4X.DRAM_ZQ0: IC5.A5, R96.1
LPDDR4X.DRAM_ZQ1: IC5.A8, R97.1
MCU.LED_MATRIX_11: IC7.M5, TP3.1
MCU.MCU_JTAG_TDI: IC7.A10, TP7.1
MCU.MCU_OSC32_IN_PC14: IC7.D1, R98.1
MCU.MCU_OSC32_OUT_PC15: IC7.E1, R99.1
MCU.MCU_OSC_IN_PH0_R: IC7.H1, R100.1
MCU.MCU_OSC_OUT_PH1_R: IC7.J1, R101.1
MCU.MCU_SOC_LPUART1_CTS: IC7.J9, R109.2
MCU.MCU_SOC_LPUART1_RTS: IC7.H10, R108.2
MCU.MCU_SOC_LPUART1_RX: IC7.H9, R111.2
MCU.MCU_SOC_LPUART1_TX: IC7.G8, R110.2
MCU.MCU_SPI3_CLK_R: IC7.A7, R102.2
MCU.MCU_SPI3_CS_N_R: IC7.E6, R103.2
MCU.MCU_SPI3_MISO_R: IC7.C7, R104.2
MCU.MCU_SPI3_MOSI_R: IC7.C6, R105.1
MCU.MCU_SPI3_RDY_R: IC7.N10, R106.2
MCU.MCU_VCAP: IC7.A4, IC7.N11
MCU.MCU_VREF_EN: IC6.6, IC7.M2, R112.1
MCU.OSC_16M_IN: C75.1, R100.2, Y1.1
MCU.OSC_16M_OUT: C76.1, R101.2, Y1.3
MCU.OSC_32K_IN: C77.1, R98.2, R107.1, Y2.1
MCU.OSC_32K_OUT: C78.1, R99.2, R107.2, Y2.2
MCU_BOOT0: IC7.C5, JANALOG1.1, R42.1, TP1.1
MCU_CRS_SYNC_PA10: IC7.F11, J2.25
MCU_I2C2_SCL: IC7.K9, R32.2, R33.1
MCU_I2C2_SDA: IC7.L9, R34.2, R35.1
MCU_I2C4_SCL_PD12: IC7.K10, R36.2, R37.1
MCU_I2C4_SCL_PF14: IC7.L6, R43.1, R44.2
MCU_I2C4_SDA_PD13: IC7.K12, R38.2, R39.1
MCU_I2C4_SDA_PF15: IC7.N6, R45.1, R46.2
MCU_JTAG_NJTRST_PB4: 2.9, IC7.B6, TP4.1
MCU_JTAG_SWCLK: IC7.C10, TP5.1
MCU_JTAG_SWDIO: IC7.F12, TP6.1
MCU_JTAG_SWO_PB3: 2.3, IC7.D6
MCU_LED1_BLU: IC7.B13, R78.2
MCU_LED1_GRN: IC7.D9, R79.2
MCU_LED1_RED: IC7.C13, R80.2
MCU_LED2_BLU: IC7.A13, R81.2
MCU_LED2_GRN: IC7.C11, R82.2
MCU_LED2_RED: IC7.C12, R83.2
MCU_MCO_PA8: IC7.G7, J2.23
MCU_NRST: IC7.H3, J3.5, JANALOG1.3, R47.1, TP2.1
MCU_OPAMP1_VINM_PA1: IC7.L3, J2.24
MCU_OPAMP1_VINP_PA0: IC7.K3, J2.22
MCU_OPAMP1_VOUT_PA3: IC7.N2, J2.20
MCU_PA4: IC7.N1, JANALOG1.9
MCU_PA5: IC7.K4, JANALOG1.10
MCU_PA6: IC7.N4, JANALOG1.11
MCU_PA7: IC7.J5, JANALOG1.12
MCU_PA11: 2.6, IC7.G13
MCU_PA12: 2.5, IC7.F13
MCU_PB0: 2.4, IC7.K5
MCU_PB1: 2.7, IC7.N5
MCU_PB2: 2.8, IC7.L5
MCU_PB8: 2.10, IC7.E5
MCU_PC0: IC7.J2, JANALOG1.14
MCU_PC1: IC7.J3, JANALOG1.13
MCU_PE7: IC7.L7, J2.12
MCU_PE8: IC7.K7, J2.14
MCU_PSSI_D0: IC7.H13, J2.1
MCU_PSSI_D1: IC7.G12, J2.3
MCU_PSSI_D2: IC7.G10, J2.5
MCU_PSSI_D3: IC7.G9, J2.7
MCU_PSSI_D4: IC7.C2, J2.9
MCU_PSSI_D5: IC7.B10, J2.11
MCU_PSSI_D6: IC7.A2, J2.13
MCU_PSSI_D7: IC7.C3, J2.15
MCU_PSSI_DE: IC7.L12, J2.21
MCU_PSSI_PDCK: IC7.L13, J2.17
MCU_PSSI_RDY: IC7.B3, J2.19
MCU_SDMMC1_CMD_PD2: IC7.F7, J2.2
MCU_SPI2_CLK: IC7.N13, R60.1
MCU_SPI2_CLK_PD1: IC7.F6, R48.1
MCU_SPI2_MISO: IC7.M12, R61.1
MCU_SPI2_MISO_PC2: IC7.J4, R49.1
MCU_SPI2_MOSI: IC7.L11, R62.1
MCU_SPI2_MOSI_PC3: IC7.K1, R50.1
MCU_SPI2_NSS: IC7.D5, R63.1
MCU_TRACE_CLK: IC7.A1, J2.4
MCU_TRACE_D0: IC7.D3, J2.6
MCU_TRACE_D2: IC7.D2, J2.8
MCU_TRACE_D3: IC7.E4, J2.10
MCU_USART1_RX: IC7.F5, R64.1
MCU_USART1_TX: IC7.B5, R65.1
MCU_VREFP: 2.16, C23.1, C73.1, C74.1, IC6.3, IC7.L1
MIPI_DSI0_CLK_M_CONN: D54.1, D54.10, J1.3
MIPI_DSI0_CLK_P_CONN: D54.2, D54.9, J1.5
MIPI_DSI0_L0_M_CONN: D53.1, D53.10, J1.12
MIPI_DSI0_L0_P_CONN: D53.2, D53.9, J1.10
MIPI_DSI0_L1_M_CONN: D53.4, D53.7, J1.6
MIPI_DSI0_L1_P_CONN: D53.5, D53.6, J1.4
MIPI_DSI0_L2_M_CONN: D54.4, D54.7, J1.9
MIPI_DSI0_L2_P_CONN: D54.5, D54.6, J1.11
MIPI_DSI0_L3_M_CONN: D49.1, D49.10, J1.15
MIPI_DSI0_L3_P_CONN: D49.2, D49.9, J1.17
MUX_SBU1_2: D47.1, D47.10, USB1.A8
MUX_SBU2_2: D47.2, D47.9, USB1.B8
MUX_SSRXN1_2: C24.2, R54.1
MUX_SSRXN2_2: C25.2, R55.1
MUX_SSRXP1_2: C26.2, R56.1
MUX_SSRXP2_2: C27.2, R57.1
PHONE_ON_N: 1.1, 1.2, C17.1, D5.1
PM_RESIN_N: D21.1, J4.8
PWR_3P3V: C10.1, C11.1, C32.1, C33.1, C34.1, C35.1, C72.1, C79.1, C80.1, C81.1, C82.1, C83.1, C84.1, C85.1, C86.1, C87.1, C88.1, C89.1, C90.1, C91.1, C92.1, C93.1, IC6.4, IC6.5, IC7.A3, IC7.A8, IC7.A11, IC7.B1, IC7.D13, IC7.E13, IC7.G1, IC7.J13, IC7.L2, IC7.N3, IC7.N7, IC7.N12, J1.58, J1.60, J2.53, J2.55, JANALOG1.2, JANALOG1.4, L1.2, LED1.1, LED2.1, LED3.1, LED4.1, R14.1, R16.2, R32.1, R34.1, R36.1, R38.1, R44.1, R46.1, R47.2, R77.1, U1.2
PWR_3P8V: C8.1, C12.1, C13.1, C14.1, IC3.4, L2.2, R10.1, R12.1, R13.1, R16.1, R17.1
SDC1_CMD: R113.2, U2.M5
SOC_GPIO18: D24.1, J2.49
SOC_GPIO28: D25.1, J2.51
SOC_GPIO_0_SE0: D26.1, J2.37
SOC_GPIO_1_SE0: D29.1, J2.39
SOC_GPIO_2_SE0: D30.1, J2.41
SOC_GPIO_3_SE0: D31.1, J2.43
SOC_GPIO_82_SE0: D32.1, J2.47
SOC_GPIO_86_SE0: D33.1, J2.45
SOC_GPIO_98: D34.1, J2.46
SOC_GPIO_99: D35.1, J2.48
SOC_GPIO_100: D27.1, J2.50
SOC_GPIO_101: D28.1, J2.52
SOC_UART_RX_SE4: D36.1, J4.6
SOC_UART_TX_SE4: D37.1, J4.4
SYS_5V: C15.1, C16.1, D2.1, D3.1, IC2.4, Q2.2, R7.1, R18.1
USB0_HS_DM_2: IC4.1, USB1.A7, USB1.B7
USB0_HS_DP_2: IC4.2, USB1.A6, USB1.B6
USB_5V_VBUS: C36.1, C37.1, C38.1, C39.1, C40.1, C42.1, D3.2, D6.1, D38.1, IC4.6, J2.54, J2.56, J3.2, JANALOG1.5, USB1.A4, USB1.A9, USB1.B4, USB1.B9
USB_CC1_2: D47.4, D47.7, USB1.A5
USB_CC2_2: D47.5, D47.6, USB1.B5
VBAT: C41.1, D39.1, J2.60, R17.2
VBUS_POWER_SWITCH_DISABLE_N: J4.10, R8.2
VCOIN: C43.1, C94.1, C95.1, D40.1, IC7.C1, J2.59
VOLUME_DOWN_N: D41.1, J4.3
VOLUME_UP_N: D42.1, J4.5
VREG_L2A_1P128V: C57.1, C58.1, C59.1, C60.1, C61.1, C62.1, IC5.AB4, IC5.AB9, IC5.F5, IC5.F8, IC5.G2, IC5.H1, IC5.H5, IC5.H8, IC5.H12, IC5.K1, IC5.K3, IC5.K10, IC5.N1, IC5.N3, IC5.N10, IC5.N12, IC5.R1, IC5.R5, IC5.R8, IC5.R12, IC5.T2, IC5.U5, IC5.U8
VREG_L3A_0P6V: C63.1, C64.1, C65.1, C66.1, C67.1, C68.1, C69.1, C70.1, C71.1, IC5.AA3, IC5.AA5, IC5.AA8, IC5.AA10, IC5.B3, IC5.B5, IC5.B8, IC5.B10, IC5.D1, IC5.D5, IC5.D8, IC5.D12, IC5.F3, IC5.F10, IC5.U3, IC5.U10, IC5.W1, IC5.W5, IC5.W8, IC5.W12, R96.2, R97.2
VREG_L14A_1P8V: C101.1, C102.1, U2.C6, U2.M4, U2.N4, U2.P3, U2.P5
VREG_L15A_1P8V: C44.1, C45.1, C46.1, C53.1, C54.1, C55.1, C56.1, C96.1, C97.1, C98.1, D43.1, D44.1, IC5.F1, IC5.F12, IC5.G4, IC5.G9, IC5.T4, IC5.T9, IC5.U1, IC5.U12, IC7.A6, IC7.H12, J2.57, J4.9, R20.2, R22.2, R24.2, R26.2, R113.1
VREG_L20A_2P96V: C103.1, C104.1, C105.1, U2.E6, U2.J10, U2.K9
eMMC.EMMC1_VDDI: C99.1, C100.1, U2.C2
eMMC.EMMC16G_WW28_GA01.NC: U2.A1, U2.A2, U2.A8, U2.A9, U2.A10, U2.A11, U2.A12, U2.A13, U2.A14, U2.B1, U2.B7, U2.B8, U2.B9, U2.B10, U2.B11, U2.B12, U2.B13, U2.B14, U2.C1, U2.C3, U2.C5, U2.C7, U2.C8, U2.C9, U2.C10, U2.C11, U2.C12, U2.C13, U2.C14, U2.D1, U2.D2, U2.D3, U2.D4, U2.D12, U2.D13, U2.D14, U2.E1, U2.E2, U2.E3, U2.E12, U2.E13, U2.E14, U2.F1, U2.F2, U2.F3, U2.F12, U2.F13, U2.F14, U2.G1, U2.G2, U2.G12, U2.G13, U2.G14, U2.H1, U2.H2, U2.H3, U2.H12, U2.H13, U2.H14, U2.J1, U2.J2, U2.J3, U2.J12, U2.J13, U2.J14, U2.K1, U2.K2, U2.K3, U2.K12, U2.K13, U2.K14, U2.L1, U2.L2, U2.L3, U2.L12, U2.L13, U2.L14, U2.M1, U2.M2, U2.M3, U2.M7, U2.M8, U2.M9, U2.M10, U2.M11, U2.M12, U2.M13, U2.M14, U2.N1, U2.N3, U2.N6, U2.N7, U2.N8, U2.N9, U2.N10, U2.N11, U2.N12, U2.N13, U2.N14, U2.P1, U2.P2, U2.P8, U2.P9, U2.P11, U2.P12, U2.P13, U2.P14
eMMC.NC: U2.A7, U2.E5, U2.F5, U2.G3, U2.K6, U2.K7, U2.P7, U2.P10
