dioderobot/arduino/reference/AMS1117x/layout/AMS1117x/layout.kicad_pcb

## KiCad design reference/AMS1117x/layout/AMS1117x/layout.kicad_pcb (2025-10-21, an earlier design)

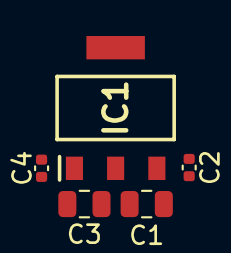
[picture p11: board reference/AMS1117x/layout/AMS1117x/layout.kicad_pcb from above]

Board: 2 copper layers, 5 parts (0 on the bottom side), 3 nets, no tracks yet.

Parts:
C1: 10uF 25V; C_0805_2012Metric
C2: 100nF 25V; C_0402_1005Metric
C3: 22uF 10V; C_0805_2012Metric
C4: 100nF 10V; C_0402_1005Metric
IC1: AMS1117M5_0; SOT229P700X180-4N

Connections:
GND: C1.2, C2.2, C3.2, C4.2, IC1.1, IC1.4
VIN: C1.1, C2.1, IC1.3
VOUT_5V: C3.1, C4.1, IC1.2
