dioderobot/arduino/reference/ATmega328Px/layout/ATmega328Px/layout.kicad_pcb

## KiCad design reference/ATmega328Px/layout/ATmega328Px/layout.kicad_pcb (2025-10-21, an earlier design)

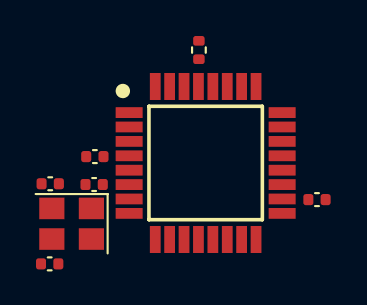
[picture p12: board reference/ATmega328Px/layout/ATmega328Px/layout.kicad_pcb from above]

Board: 2 copper layers, 8 parts (0 on the bottom side), 5 nets, no tracks yet.

Parts:
C1, C2, C3: 100nF 6.3V; C_0402_1005Metric
C4, C5: 22pF C0G; C_0402_1005Metric
IC1: ATMEGA328PMAU; QFP80P900X900X120-32N
R1: 10k 5%; R_0402_1005Metric
Y1: 16MHz 18pF; Crystal_SMD_3225-4Pin_3.2x2.5mm

Connections:
GND: C1.2, C2.2, C3.2, C4.2, C5.2, IC1.3, IC1.5, IC1.21, Y1.2, Y1.4
RESET: IC1.29, R1.1
VCC: C1.1, C2.1, C3.1, IC1.4, IC1.6, IC1.18, R1.2
oscpair_XIN: C4.1, IC1.7, Y1.1
oscpair_XOUT: C5.1, IC1.8, Y1.3
