dioderobot/arduino/reference/CH340x/layout/CH340x/layout.kicad_pcb

## KiCad design reference/CH340x/layout/CH340x/layout.kicad_pcb (2025-10-21, an earlier design)

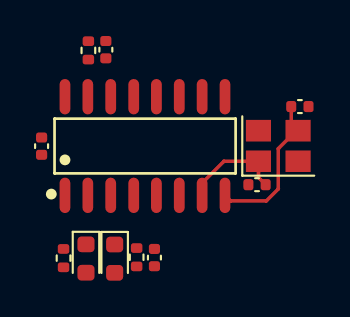
[picture p13: board reference/CH340x/layout/CH340x/layout.kicad_pcb from above]

Board: 2 copper layers, 12 parts (0 on the bottom side), 11 nets.

Parts:
C1, C3: 100nF 10V; C_0402_1005Metric
C2: 100nF 6.3V; C_0402_1005Metric
C4, C5: 22pF C0G; C_0402_1005Metric
D1, D2: LED YELLOW; LED_0603_1608Metric
R1, R2, R3: 1k 5%; R_0402_1005Metric
U1: CH340G; SOIC-16_L9.9-W3.9-P1.27-LS6.0-BL
Y1: 12MHz 20pF; Crystal_SMD_3225-4Pin_3.2x2.5mm

Connections:
GND: C1.2, C2.2, C3.2, C4.2, C5.2, D1.1, U1.1, Y1.2, Y1.4
R232: R1.1, U1.15
RX_LED_ANODE: D1.2, R2.2
TX_LED_ANODE: D2.2, R3.2
UART_RX: D2.1, U1.3
UART_TX: R2.1, U1.2
USB_VCC: C1.1, U1.16
V3_INTERNAL: C2.1, U1.4
VCC: C3.1, R1.2, R3.1
oscpair_XIN: C4.1, U1.7, Y1.1
oscpair_XOUT: C5.1, U1.8, Y1.3
