dioderobot/arduino/reference/FT232RLx/layout/FT232RLx/layout.kicad_pcb

## KiCad design reference/FT232RLx/layout/FT232RLx/layout.kicad_pcb (2025-10-21, an earlier design)

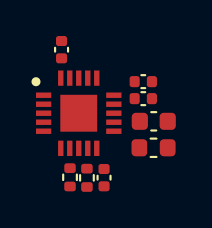
[picture p14: board reference/FT232RLx/layout/FT232RLx/layout.kicad_pcb from above]

Board: 2 copper layers, 9 parts (0 on the bottom side), 6 nets, no tracks yet.

Parts:
C1: 100nF 6.3V; C_0402_1005Metric
C2, C3, C4: 100nF 10V; C_0402_1005Metric
C5: 4.7uF 10V; C_0603_1608Metric
IC1: FT231XQMR; QFN50P400X400X80-21N
L1: 600nH; L_0603_1608Metric
R1, R2: 27 5%; R_0402_1005Metric

Connections:
GND: C1.2, C2.2, C3.2, C4.2, C5.2, IC1.3, IC1.13, IC1.21
P3V3OUT: C1.1, IC1.10
USBDM_INTERNAL: IC1.9, R1.1
USBDP_INTERNAL: IC1.8, R2.1
VCC: C3.1, C4.1, C5.1, IC1.11, IC1.12, L1.2
VCCIO: C2.1, IC1.20
