dioderobot/arduino/(commit log)

2025-10-21 rename board
    [layout.kicad_pcb]
2025-10-21 add reference
    [layout.kicad_pcb]
2025-10-21 first pass
    [layout.kicad_pcb]
2025-10-21 blue solder mask
    [layout.kicad_pcb]
2025-10-21 add arduino access
2025-10-21 better connector
    [layout.kicad_pcb]
2025-10-21 add uart LEDs
    [layout.kicad_pcb]
2025-10-21 full routing
    [layout.kicad_pcb]
2025-10-22 better schematics
    [layout.kicad_pcb]
2025-10-22 add pcb version
    [layout.kicad_pcb]
2025-10-22 add UnoQ
    [layout.kicad_pcb]
2025-10-22 Fix CI release error and correct unoQ board configuration
    - Add quotes around board name and archive path in CI workflow to handle spaces in 'Arduino UNO Q'
    - Update unoQ Board() configuration: name, layout_path, and layers (2->4)
    - Fixes 'unexpected argument Q found' error in pcb release command
2025-10-22 Vendor stdlib HEAD dependencies for offline CI builds
    - Update stdlib from v0.3.2 to HEAD
    - Add new generics: Diode, MountingHole, TestPoint, Version
    - Add additional KiCad footprints and symbols
    - Fixes offline build errors in CI
2025-10-22 Fix CI: Add python3-pip and sanitize board names in filenames
    - Add python3-pip to dependencies for sigstore action
    - Replace spaces with underscores in archive filenames (Arduino_UNO_Q-<hash>.zip)
    - Update artifact names to use sanitized board slug
    - Fixes 'input Arduino doesn't expand to one or more filenames' error
2025-10-22 use carrier and core arch
    [layout.kicad_pcb]
2025-10-27 Update GitHub workflow: pcb-release.yml
2025-11-26 fix CI
    [layout.kicad_pcb]
2025-12-04 Update GitHub workflow: pcb-release.yml (#8)
2025-12-07 Refactor into modules
    modules/NanoCarrier/
    modules/NanoCore/
    modules/Stackup/
    [layout.kicad_pcb]
2025-12-07 pcb migrate
2025-12-07 Update GitHub workflow: pcb-release.yml (#10)
2025-12-10 bump pcb
2025-12-12 Update GitHub workflow: pcb-release.yml (#11)
2025-12-17 Update GitHub workflow: pcb-release.yml (#12)
2026-03-28 Bump pcb version
2026-04-19 Update GitHub workflow: pcb-release.yml (#31)
    * Update GitHub workflows
    * chore: flatten eda/ subdirs into their parent component packages
    Move .kicad_mod, .kicad_sym, and other files out of per-package eda/
    subdirectories up into the component package roots. Strip the eda/
    path segment from all in-repo references:
    - 30 component .zen files (Symbol library, File footprint paths)
    - 2 fp-lib-table files (boards/unoQ KIPRJMOD URIs)
    30 component packages flattened under components/. pcb build passes
    for all 40 boards/modules/components.
    ---------
